gianlucarenzi/Vera-Module-RBL-C64/WORKFLOW.md

# Workflow di progetto: dallo schematico all'ordine JLCPCB

Versione stampabile: [WORKFLOW.pdf](WORKFLOW.pdf), generata da `WORKFLOW.tex`
(`firmware/MCU/produce-pdf-from-tex.sh WORKFLOW`). Le modifiche si fanno
prima qui, poi nel `.tex`.

Strumenti: KiCad 5 (Eeschema, CvPcb, Pcbnew) per schematico e PCB, libreria
`~/Progetti/RetroBitLab-Library` per simboli, footprint e modelli 3D, gli script
del repository per tutto ciò che si produce (PDF, Gerber, 3D, BOM, CPL).

In sintesi:

1. schematico e annotazione
2. disponibilità dei componenti → se serve, aggiornare la libreria e tornare al punto 1
3. ERC
4. assegnamento dei footprint
5. salvataggio della netlist
6. PCB: import della netlist e netclass
7. sbroglio
8. riempimento delle aree e DRC, senza errori né warning
9. salvataggio del PCB
10. `./output_job.sh <versione>`
11. consegna: zip dei Gerber, BOM e CPL

In questa fase **non** si esportano a mano PDF, BOM, Gerber o CPL da KiCad:
li genera tutti `output_job.sh` al punto 10, sempre dai sorgenti.

## 1. Schematico e annotazione

- Si disegna lo schematico in Eeschema (KiCad 5), foglio principale
  `VERA-MODULE-RBL.sch` e fogli gerarchici.
- Ogni componente da montare ha il campo **`LCSC`** con il codice del pezzo
  (es. `C17713`). La BOM raggruppa per valore, footprint e LCSC; un componente
  senza LCSC non viene montato da JLCPCB e viene tolto anche dalla CPL.
- Si annota tutto (Strumenti → Annota schematico). Nessun riferimento deve
  restare con `?`: `sch2bomxml.py` si ferma se ne trova uno, o se due parti
  diverse hanno lo stesso riferimento.

## 2. Disponibilità dei componenti

Subito dopo l'annotazione, prima di andare avanti:

```sh
./check_jlcpcb_stock.sh          # 5 schede
./check_jlcpcb_stock.sh -n 10    # 10 schede
```

Lo script costruisce la BOM dallo schematico in una cartella temporanea (non
scrive file del progetto) e la confronta con il catalogo JLCPCB in tempo reale.
Per ogni riga riporta stock, quantità necessaria (con scarto e minimo),
tipo Basic / Preferred / Extended e costo.

| Stato | Significato | Blocca |
|---|---|---|
| `OK` | stock sufficiente | no |
| `LOW` | sufficiente ora, ma meno di 5 volte il necessario | no (avviso) |
| `GLOBAL` | stock insufficiente, ma il codice è in `jlcpcb-global-sourcing.txt` | no |
| `SHORT` | stock minore del necessario | sì |
| `OUT` | stock zero | sì |
| `MISSING` | codice non presente nel catalogo JLCPCB | sì |

Per le righe che bloccano propone alternative con stock sufficiente (stessa
categoria e package, stesso valore per i passivi, Basic prima). Esce con 0 se
tutto si può montare, 1 se qualcosa va cambiato, 2 se il servizio non risponde.

Se un componente è attivo ma JLCPCB ne ha pochi, lo si può far comprare a
JLCPCB con il **Global Sourcing**: si aggiunge il codice LCSC a
`jlcpcb-global-sourcing.txt` (uno per riga, `#` per il commento) e all'ordine
si sceglie Global Sourcing per quella riga.

### Aggiornare la libreria, se necessario

Quando un componente va sostituito:

1. in `RetroBitLab-Library` si crea o si aggiorna il simbolo (`.lib`) con
   footprint, datasheet e campo `LCSC`, e la sua documentazione (`.dcm`);
   per i passivi si usa la libreria della famiglia giusta (`CCAP0805`,
   `CRES0805`, ...). Se cambia il package servono anche footprint e modello 3D;
2. si verifica sul datasheet piedinatura e land pattern rispetto al footprint;
3. si fa il commit della libreria;
4. nello schematico si sostituisce il simbolo e si torna al punto 2 finché
   il controllo non passa.

## 3. ERC

Ispeziona → Controllo regole elettriche. Si correggono tutti gli errori e i
warning prima di proseguire.

## 4. Assegnamento dei footprint

Con CvPcb ogni simbolo deve avere il suo footprint. Per le parti JLCPCB il
footprint deve corrispondere al package del codice LCSC.

## 5. Salvataggio della netlist

Si genera e si salva la netlist `VERA-MODULE-RBL.net` (Strumenti → Genera
netlist, formato Pcbnew). **Nessun PDF e nessuna BOM** in questa fase.

## 6. PCB: netlist e netclass

- In Pcbnew (KiCad 5) si importa la netlist (Strumenti → Carica netlist).
- Le **netclass si definiscono e si assegnano nel PCB** (File → Impostazioni
  scheda → Classi di rete): con KiCad 5 non esiste back annotation dal PCB
  allo schematico, quindi l'unico posto dove le netclass sono definite è il
  `.kicad_pcb`. Dopo ogni nuovo import della netlist si controlla che le net
  nuove o rinominate siano nella netclass giusta.

## 7. Sbroglio

A mano, oppure con fastroute tramite `tools/route.sh` (vedi il commento in
testa allo script). Il risultato si importa come sessione Specctra.
fastroute va installato nel sistema dal suo pacchetto Debian, da
[github.com/gianlucarenzi/fastroute](https://github.com/gianlucarenzi/fastroute)
(`scripts/build-deb.sh`, poi `sudo apt install ./dist/fastroute_*.deb`):
`tools/route.sh` si ferma se non lo trova.

`tools/route.sh` sbroglia **da zero** (cancella tutte le piste). Per completare
solo i collegamenti mancanti di una scheda già sbrogliata si usa
`tools/route_incremental.sh WORKDIR` (KiCad chiuso, DSN esportato dalla scheda
salvata con le aree riempite): le piste esistenti restano fisse e il risultato
è `VERA-MODULE-RBL.ses`. Due cose da sapere:

- KiCad 5 esporta i segmenti consecutivi come un'unica polilinea e mette le
  giunzioni a T sui vertici intermedi; fastroute collega le piste solo agli
  estremi e vedrebbe interrotte net già complete. `tools/split_dsn_wires.py`
  spezza le polilinee in segmenti.
- L'import della sessione in KiCad 5 **sostituisce tutte** le piste e le via:
  `tools/filter_ses.py` tiene lo sbroglio esistente una sola volta e con la
  larghezza originale, aggiunge il nuovo solo sulle net incomplete
  (`tools/unrouted_nets.py`) e rifiuta una sessione a cui manca qualcosa.

Per far ottimizzare a fastroute (lunghezza delle piste, numero di via) solo
lo sbroglio aggiunto dopo un commit, lasciando fisso quello già validato, si
usa `tools/optimize_new.sh COMMIT WORKDIR`. Prima dell'import della sessione
si tolgono le teardrop, dopo si rimettono. Il report di fastroute è più severo
del DRC di KiCad (controlla anche il rame della stessa net e vede via ed
estremità delle piste come ottagoni): il riferimento resta il DRC.

## 8. Riempimento delle aree e DRC

1. Al termine dello sbroglio si riempiono tutte le aree (tasto `B`).
2. Si lancia il DRC (Ispeziona → Controllo regole di progettazione).
3. Si correggono **tutti** gli errori e i warning, poi si ripetono i punti 1 e 2
   finché il DRC è pulito.

## 9. Salvataggio del PCB

Il `.kicad_pcb` si salva sempre corretto (DRC pulito) e **con le aree
riempite**: Gerber, 3D e CPL vengono generati dal file così come è salvato.
(`REFILL_ZONES=1 ./output_job.sh <versione>` riempie di nuovo le aree solo in
memoria, senza modificare il file: è un ripiego, non sostituisce il punto 8.)

## 10. Generazione dei file di produzione

```sh
./check_jlcpcb_stock.sh          # di nuovo, lo stock cambia nel tempo
./output_job.sh <versione>       # es. ./output_job.sh 4
```

`output_job.sh`, in ordine:

1. XML della BOM dallo schematico (`sch2bomxml.py`) → `VERA-MODULE-RBL.xml`;
2. BOM raggruppata (`generate_bom.py`) → `VERA-MODULE-RBL.csv`;
3. **BOM JLCPCB** (`jlcpcb-check-bom.py`) → `<NOME>-v<versione>-JLCPCB-BOM.csv`;
4. **CPL JLCPCB** dal PCB (`run_generate_cpl.sh`, `clean_virtual.sh`) →
   `<NOME>-v<versione>-JLCPCB-CPL.csv`, poi `jlcpcb-sync-cpl.py` toglie dalla
   CPL ciò che non è in BOM e si ferma se manca qualcosa;
5. **Gerber e forature** con pcbnew 5 e le impostazioni di stampa salvate nel
   PCB (`generate_gerbers.py`) → `production/` (svuotata prima);
6. **BOM interattiva** con il plugin InteractiveHtmlBom e le impostazioni di
   `ibom.config.ini` (`tools/generate_ibom.py`) → `ibom/ibom.html`;
7. **PDF dello schematico** con eeplot → `VERA-MODULE-RBL.pdf`;
8. **scheda in 3D**, STEP e VRML, con kicad-cli → `images/VERA-MODULE-RBL.step`
   e `images/VERA-MODULE-RBL.wrl`;
9. zip del contenuto di `production/` → `<NOME>-v<versione>.zip`.

Si ferma al primo errore. `<NOME>` è `VERA-MODULE-RBL-C64` per questo progetto.

## 11. Consegna

Il progetto da mandare in produzione è composto da **3 file**:

| File | Contenuto | Dove si carica su JLCPCB |
|---|---|---|
| `<NOME>-v<versione>.zip` | Gerber e forature | ordine PCB |
| `<NOME>-v<versione>-JLCPCB-BOM.csv` | BOM | PCB Assembly → BOM |
| `<NOME>-v<versione>-JLCPCB-CPL.csv` | posizioni e rotazioni | PCB Assembly → CPL |

All'ordine:

- nell'anteprima di montaggio si controlla la rotazione dei componenti,
  soprattutto quelli nuovi o con footprint cambiato;
- per le righe elencate come `GLOBAL` dal controllo stock si sceglie
  Global Sourcing.

Zip, BOM e CPL versionati non vanno nel repository; ci vanno invece i
sorgenti (schematici, netlist, PCB), `VERA-MODULE-RBL.xml/.csv`,
`production/`, il PDF, la BOM interattiva e i modelli 3D.
