gianlucarenzi/Vera-Module-RBL-C64/firmware/MCU/Vera_Module_Analisys.ITA.tex

\documentclass[12pt, a4paper]{article}

% --- PACHETTI ---
\usepackage[utf8]{inputenc}
\usepackage[T1]{fontenc}
\usepackage{lmodern} % Font più moderno rispetto al default
\usepackage[italian]{babel}
\usepackage{geometry}
\usepackage{graphicx}
\usepackage{amsmath}
\usepackage{amssymb}
\usepackage{xcolor}
\usepackage{hyperref}
\usepackage{listings}
\usepackage{tikz}
\usepackage{tikz-timing}
\usepackage{verbatim} % Aggiunto per commentare blocchi
\usepackage{fancyvrb} % BVerbatim per ASCII art centrata
\usepackage{float}
\usepackage{booktabs}
\usepackage{array}

% --- CONFIGURAZIONE GEOMETRIA PAGINA ---
\geometry{a4paper, top=3cm, bottom=3cm, left=2.5cm, right=2.5cm}

% --- CONFIGURAZIONE HYPERREF ---
\hypersetup{
    colorlinks=true,
    linkcolor=blue!50!black,
    urlcolor=blue!80!black,
    citecolor=green!50!black,
    pdftitle={Analisi Progetto Vera-Module-RBL-C64},
    pdfauthor={RetroBit Lab},
}

% --- CONFIGURAZIONE TIKZ ---
\usetikzlibrary{shapes.geometric, arrows, positioning, chains, shapes.misc}

% --- CONFIGURAZIONE LISTINGS (per il codice) ---
\definecolor{codegreen}{rgb}{0,0.6,0}
\definecolor{codegray}{rgb}{0.5,0.5,0.5}
\definecolor{codepurple}{rgb}{0.58,0,0.82}
\definecolor{backcolour}{rgb}{0.98,0.98,0.98}

\lstdefinestyle{cppstyle}{
    backgroundcolor=\color{backcolour},
    commentstyle=\color{codegreen},
    keywordstyle=\color{magenta},
    numberstyle=\tiny\color{codegray},
    stringstyle=\color{codepurple},
    basicstyle=\footnotesize\ttfamily,
    breakatwhitespace=false,
    breaklines=true,
    captionpos=b,
    keepspaces=true,
    numbers=left,
    numbersep=5pt,
    showspaces=false,
    showstringspaces=false,
    showtabs=false,
    tabsize=2,
    language=C++
}

% --- TITOLO ---
\title{
    \vspace{2cm}
    \hrule
    \vspace{0.5cm}
    {\Huge \bfseries Analisi Tecnica del Firmware}\\
    \vspace{0.2cm}
    {\Large Progetto \textit{Vera-Module-RBL-C64}}\\
    \vspace{0.5cm}
    \hrule
}
\author{Analisi del progetto a cura di RetroBit Lab}
\date{\today}

% --- INIZIO DOCUMENTO ---
\begin{document}

\maketitle
\thispagestyle{empty}

\newpage
\tableofcontents
\thispagestyle{empty}

\newpage
\setcounter{page}{1}

% --- SEZIONE 1: INTRODUZIONE ---
\section{Introduzione}
Questo documento presenta un'analisi tecnica del firmware ESP32 per il progetto \textit{Vera-Module-RBL-C64}. Il firmware, eseguito su un ESP32-S3, si interfaccia con il bus del processore 6510 attraverso la \textbf{porta di espansione del Commodore 64}. Espone i registri della scheda video VERA (FPGA) e una \textbf{GeoRAM da 256\,KB} emulata nella RAM interna dell'ESP32.

Il progetto deriva dalla versione Atari (\textit{Vera-Module-RBL-XE}). Lo schema è quello di RBL-XE nella revisione del 2026-10-26, con il foglio del connettore adattato alla porta di espansione del C64; la piedinatura dell'ESP32-S3 è la stessa di RBL-XE, tranne GPIO\,41/42 che diventano gli ingressi \texttt{/IO1}/\texttt{/IO2} (\texttt{PIN-MAPPING.md}~\S9). Il PCB è ancora quello Atari. Anche il firmware riprende l'architettura di RBL-XE (loop del bus sul Core\,1 a interruzioni mascherate, percorso critico in assembly, tabelle di decodifica, log senza lock), adattata al bus del C64. L'analisi si concentra sulla fattibilità temporale dell'interazione fra la MCU e la CPU e sulla struttura del loop del bus. \textbf{Nulla è stato provato su hardware.}

% --- SEZIONE 2: ARCHITETTURA DEL SISTEMA ---
\section{Architettura del Sistema}

\subsection{Componenti Chiave}
\begin{itemize}
    \item {\bfseries CPU 6510 (MOS):} il processore del C64, a \textbf{0.985\,MHz} (PAL) o \textbf{1.023\,MHz} (NTSC). PHI2 alto dura $\approx$490\,ns.
    \item {\bfseries MCU:} \textbf{ESP32-S3FN8} (QFN56, 7$\times$7\,mm) --- dual-core Xtensa LX7 @ 240\,MHz, 512\,KB SRAM, 8\,MB flash in-package Quad SPI, 45 GPIO.
    \item {\bfseries FPGA VERA:} iCE40UP5K con il firmware VERA; risponde ai registri \$DF00--\$DF1F quando l'ESP32 asserisce \texttt{DEV\_SEL\_N}.
\end{itemize}

\subsection{Mappa I/O}
La scheda occupa le due aree I/O della porta di espansione, \texttt{IO1} (\$DE00--\$DEFF) e \texttt{IO2} (\$DF00--\$DFFF). Sul C64 queste aree non hanno memoria interna: non serve disabilitare nulla sulla scheda madre, basta pilotare il bus dati.

\begin{center}
\begin{tabular}{lllp{4.5cm}}
\toprule
\textbf{Indirizzo} & \textbf{Accesso} & \textbf{Funzione} & \textbf{Chi risponde} \\
\midrule
\$DE00--\$DEFF & R/W & Finestra GeoRAM (pagina da 256\,B) & ESP32, \texttt{georam\_256k[]} \\
\$DF00--\$DF1F & R/W & Registri VERA & FPGA, \texttt{DEV\_SEL\_N} asserito \\
\$DFFD & W & Latch selezione VERA & ESP32 (snoop) \\
\$DFFE & W & GeoRAM, registro pagina (0--63) & ESP32 (snoop) \\
\$DFFF & W & GeoRAM, registro blocco (0--15) & ESP32 (snoop) \\
\bottomrule
\end{tabular}
\end{center}

La VERA risponde \textbf{solo se selezionata}: un valore $\neq 0$ scritto in \$DFFD la seleziona, \texttt{0} la deseleziona. La GeoRAM (finestra e registri \$DFFE/\$DFFF) è \textbf{sempre attiva}, come nella cartuccia originale. Il latch risponde sempre.

La GeoRAM è organizzata in 16 blocchi da 16\,KB, ognuno di 64 pagine da 256\,byte:
\[
\text{offset} = \text{blocco} \times 16384 + \text{pagina} \times 256 + (\text{addr} \;\&\; \text{\$FF})
\]
I registri sono a sola scrittura, si azzerano all'accensione e sopravvivono al reset del C64, come nell'hardware originale. Sono decodificati esattamente a \$DFFE/\$DFFF, senza i mirror \$DF80--\$DFFD di alcune GeoRAM: per questo il latch a \$DFFD non va in conflitto.

\subsection{Ambiente di build PlatformIO}
Il file \texttt{platformio.ini} definisce un solo ambiente, \texttt{esp32s3fn8}. Opzioni di compilazione (\texttt{-D}):

\begin{center}
\begin{tabular}{lcp{8cm}}
\toprule
\textbf{Macro} & \textbf{Default} & \textbf{Effetto} \\
\midrule
\texttt{CARD\_SEL\_LATCH}           & \texttt{0xFD} & offset in \texttt{IO2} del latch di selezione (\$DFFD) \\
\texttt{IO\_QUALIFY\_NS}            & 200  & attesa massima di \texttt{/IO1}/\texttt{/IO2} dopo il fronte di salita di PHI2 \\
\texttt{BUS\_WR\_SAMPLE\_NS}        & 300  & ritardo dalla salita di PHI2 al campionamento del dato in scrittura \\
\texttt{VERA\_TRACE\_REGS}          & 0    & log di ogni accesso ai registri VERA (solo debug) \\
\texttt{VERA\_POST\_CDONE\_DELAY\_US} & 1000 & attesa fra \texttt{CDONE} e il rilascio del reset del C64 \\
\bottomrule
\end{tabular}
\end{center}

\subsection{Interfacciamento Bus}
Ogni ciclo è qualificato dalle linee \texttt{/IO1} e \texttt{/IO2} della porta di espansione. Nel C64 le genera il 74LS139 a valle del PLA, che le abilita solo con \texttt{AEC} alto, cioè solo per gli accessi della CPU: i fetch del VIC-II, i cui indirizzi compaiono anch'essi sulla porta, non le asseriscono e vengono ignorati. \texttt{/IO1} e \texttt{/IO2} decodificano già A8--A15, quindi al firmware servono solo A0--A7 come offset nella pagina.

\begin{sloppypar}
L'adattamento di livello 5\,V\,$\leftrightarrow$\,3.3\,V è affidato a cinque \textbf{74LVC4245} (lato A a 5\,V verso il C64, lato B a 3.3\,V), a un invertitore \textbf{SN74HCT04} (\texttt{U23}) per la direzione del bus dati e a due \textbf{SN74LVC00A} (\texttt{U24}, \texttt{U25}) per l'abilitazione di \texttt{U19}; dettaglio in \texttt{PIN-MAPPING.md}~\S6:
\end{sloppypar}

\begin{itemize}
    \item {\bfseries U19 --- Bus dati D0--D7 (GPIO\,4--11):} bidirezionale, \texttt{DIR} = NOT R/W\_ da \texttt{U23}. \texttt{\textasciitilde OE\_} = \texttt{NAND(PHI2, NAND(R/W, DEV\_SEL\_N, /IO1))}: acceso in scrittura, nelle letture VERA e nelle letture GeoRAM, spento in tutte le altre letture. L'ESP32 abilita le proprie uscite con \texttt{GPIO.enable\_w1ts} solo nelle letture della finestra GeoRAM.
    \item {\bfseries U4 --- A0--A7 (GPIO\,12--19)} e {\bfseries U3 --- A8--A15:} ingressi C64$\rightarrow$ESP32, con \texttt{\textasciitilde OE\_} sulla rete \texttt{\textasciitilde ABUS\_OE} (GPIO\,47, sezione~\ref{sec:strapping}). A8--A15 sono cablati ma non usati dalla decodifica. GPIO\,19/20 condividono i pad USB; USB CDC è disabilitato.
    \item {\bfseries U6 --- PHI2, R/W\_, /IO1, /IO2 (GPIO\,1, 2, 41, 42):} ingressi C64$\rightarrow$scheda; altri tre canali portano \texttt{BA}, \texttt{/DMA} e \texttt{/RESET} a punti di test. GPIO\,41 e 42 erano \texttt{EXTSEL\_N} e \texttt{MPD} su RBL-XE.
    \item {\bfseries U26, U27 --- IRQ della VERA e ARESET (GPIO\,37):} uscite scheda$\rightarrow$C64 verso le linee condivise \texttt{/IRQ} e \texttt{/RESET}, attraverso due buffer open-drain SN74LVC1G07; \texttt{U16} non pilota più nessuna linea del C64. Una pull-down da 10\,k$\Omega$ (\texttt{R70}) tiene il C64 in reset mentre l'ESP32 si avvia.
    \item {\bfseries Connessioni dirette (3.3\,V):} \texttt{DEV\_SEL\_N} (GPIO\,40) $\rightarrow$ /CS della VERA e gating di \texttt{U19}; \texttt{CRESET} (GPIO\,38) $\rightarrow$ reset VERA; \texttt{CDONE} (GPIO\,39) $\leftarrow$ VERA; \texttt{ABUS\_OE\_N} (GPIO\,47) $\rightarrow$ \texttt{U3}/\texttt{U4}.
\end{itemize}

PHI2, R/W\_, \texttt{/IO1} e \texttt{/IO2} sono letti con il \textbf{Dedicated GPIO input bundle} (\texttt{ee.get\_gpio\_in}, 1\,ciclo CPU, canali 0--3); \texttt{DEV\_SEL\_N} è l'unico canale del bundle di uscita (\texttt{ee.wr\_mask\_gpio\_out}). I bundle sono creati dal task del bus sul Core\,1, che è il core che li usa.

\subsection{Ripartizione dei core}
\label{sec:core}

\begin{center}
\begin{tabular}{clp{5.5cm}}
\toprule
\textbf{Core} & \textbf{Cosa gira} & \textbf{Note} \\
\midrule
0 & \texttt{LogTask}, \texttt{Serial} & svuota \texttt{log\_ring} e stampa; qui gira anche l'interrupt della UART e il tick FreeRTOS \\
1 & solo \texttt{MonitorTask} (loop del bus) & priorità \texttt{configMAX\_PRIORITIES - 1}, non cede mai la CPU, \textbf{interruzioni mascherate}; watchdog delle interruzioni (MWDT1) disattivato \\
\bottomrule
\end{tabular}
\end{center}

Nella versione precedente il loop girava sul Core\,0 con il tick FreeRTOS attivo: l'interruzione a 1\,kHz può far perdere cicli di bus. Ora il Core\,1 non esegue nient'altro e non riceve interruzioni; il contatore dei tick resta aggiornato dal Core\,0. Il loop passa gli eventi (cambio del latch; accessi ai registri VERA con \texttt{VERA\_TRACE\_REGS=1}) a \texttt{LogTask} tramite \texttt{log\_ring}, un ring buffer \emph{single-producer/single-consumer} senza lock: l'inserimento costa poche istruzioni e non chiama FreeRTOS, il timestamp è aggiunto da \texttt{LogTask}. Il cambio di latch viene registrato nella coda di PHI2 e inserito nel ring nel PHI1 successivo.

% --- SEZIONE 3: MAPPING DEI PIN ---
\section{Mapping dei Pin (ESP32-S3FN8, QFN56)}

I pin fisici del package QFN56 sono numerati 1--56 (più il pad GND centrale). La tabella riporta i segnali con il numero GPIO logico \textbf{e} il numero di pad fisico (Table~2-1 del datasheet ESP32-S3 v2.2).

\textbf{Nota importante:} il MCU \emph{richiede} un \textbf{quarzo esterno a 40\,MHz} sui pin dedicati \textbf{XTAL\_P} (pin\,54) e \textbf{XTAL\_N} (pin\,53); senza quarzo il chip non si avvia (sezione~\ref{sec:xtal}).

\begin{center}
\resizebox{\linewidth}{!}{%
\begin{tabular}{lcclll}
\toprule
\textbf{Segnale} & \textbf{GPIO} & \textbf{Pin QFN56} & \textbf{IO MUX} & \textbf{Dir.} & \textbf{Note} \\
\midrule
\multicolumn{6}{l}{\textit{Bus dati D0--D7 --- bidirezionale via 74LVC4245 U19 (Bank-0 bit 4--11)}} \\
D0--D7 & 4--11 & 9--16 & GPIO4--11 & I/O & D0 ha un glitch LOW di 60\,µs al power-up \\
\midrule
\multicolumn{6}{l}{\textit{Bus indirizzi A0--A7 --- input via 74LVC4245 U4 (Bank-0 bit 12--19)}} \\
A0--A2 & 12--14 & 17--19 & GPIO12--14 & IN & \\
A3 & 15 & 21 & XTAL\_32K\_P & IN & pad RTC usato come GPIO; pin\,20 = VDD3P3\_RTC \\
A4 & 16 & 22 & XTAL\_32K\_N & IN & pad RTC usato come GPIO \\
A5, A6 & 17, 18 & 23, 24 & GPIO17, 18 & IN & \\
A7 & 19 & 25 & USB\_D$-$ & IN & USB CDC disabilitato \\
\midrule
\multicolumn{6}{l}{\textit{Bus indirizzi A8--A15 --- input via U3, cablati ma non usati dalla decodifica}} \\
A8, A9 & 20, 21 & 26, 27 & USB\_D$+$, GPIO21 & IN & \\
A10, A11 & 33, 34 & 38, 39 & GPIO33, 34 & IN & \\
A12, A13 & 35, 36 & 40, 41 & GPIO35, 36 & IN & \\
A14, A15 & 45, 46 & 51, 52 & GPIO45, 46 & IN & pin di strapping (sezione~\ref{sec:strapping}) \\
\midrule
\multicolumn{6}{l}{\textit{Controllo --- U6 (ingressi) e U27 (uscita open-drain)}} \\
PHI2  &  1 &  6 & GPIO1  & IN  & Dedicated GPIO input ch\,0; 0.985/1.023\,MHz \\
R/W\_ &  2 &  7 & GPIO2  & IN  & Dedicated GPIO input ch\,1; HIGH = lettura \\
/IO1  & 41 & 47 & MTDI   & IN  & Dedicated GPIO input ch\,2; ex \texttt{EXTSEL\_N}, ex-JTAG \\
/IO2  & 42 & 48 & MTMS   & IN  & Dedicated GPIO input ch\,3; ex \texttt{MPD}, ex-JTAG \\
ARESET & 37 & 42 & GPIO37 & OUT & \texttt{/RESET} del C64 via open-drain \texttt{U27} (LOW asserito) \\
\midrule
\multicolumn{6}{l}{\textit{Segnali diretti (senza level shifter, 3.3\,V)}} \\
DEV\_SEL\_N & 40 & 45 & MTDO   & OUT & /CS VERA; Dedicated GPIO output ch\,0; ex-JTAG \\
CRESET      & 38 & 43 & GPIO38 & OUT & /RESET VERA \\
CDONE       & 39 & 44 & MTCK   & IN  & VERA configurata (HIGH = OK); ex-JTAG \\
ABUS\_OE\_N & 47 & 37 & SPICLK\_P & OUT & \texttt{\textasciitilde OE} di U3/U4; pull-up \texttt{R7}/\texttt{R34} \\
--- & 3 & 8 & GPIO3 & --- & non usato; pull-up \texttt{R71} 10\,k$\Omega$ (strapping) \\
BOOT0 & 0 & 5 & GPIO0 & IN & pulsante BOOT / auto-reset; non usato dal firmware \\
\midrule
\multicolumn{6}{l}{\textit{Debug}} \\
UART TX & 43 & 49 & U0TXD & OUT & Serial debug @ 115200 baud \\
UART RX & 44 & 50 & U0RXD & IN  & non utilizzato dal firmware \\
\bottomrule
\end{tabular}%
}
\end{center}

\noindent\textbf{Attenzione:} i pin QFN56 30--35 (GPIO\,27--32) sono collegati alla flash Quad SPI in-package (variante FN8) e non devono mai essere connessi esternamente; il pin\,28 (GPIO\,26, \texttt{SPICS1}) è il chip select della PSRAM in-package, assente sulla FN8, e resta sconsigliato (datasheet Table~2-14). Resta libero solo GPIO\,48 (pin\,36). I pin\,53 e\,54 sono pad analogici dedicati al quarzo da 40\,MHz.

\subsection{Pin di strapping --- comportamento al boot con il C64 collegato}
\label{sec:strapping}

L'ESP32-S3 campiona quattro pin di strapping a ogni reset del chip (accensione, CHIP\_PU, programmatore, brown-out), \emph{prima che qualsiasi codice venga eseguito}; i livelli devono essere validi alla salita di CHIP\_PU e per 3\,ms dopo. Le linee indirizzo della porta di espansione sono sempre pilotate: dal 6510, che continua a pilotarle anche in reset, oppure in PHI1 dal VIC-II e dai pull-up della scheda madre. Il loro livello non può quindi decidere gli strapping di GPIO\,45/46.

\begin{itemize}
  \item \textbf{GPIO\,0 (pin\,5) --- boot mode.} Rete \texttt{BOOT0} (\texttt{R33} 4.7\,k$\Omega$ verso 3V3, pulsante \texttt{SW3}, \texttt{C61}, \texttt{R54} verso \texttt{Q4}); non collegato al C64. CHIP\_PU ha \texttt{R31} 4.7\,k$\Omega$ + \texttt{C25} 1\,µF (4.7\,ms) contro 0.47\,ms di BOOT0: GPIO\,0 è già alto al rilascio del reset. Campionato HIGH $\rightarrow$ boot SPI dalla flash integrata.
  \item \textbf{GPIO\,3 (pin\,8) --- sorgente JTAG, nessun pull interno.} Non usato dal firmware; pull-up \texttt{R71} 10\,k$\Omega$ verso 3V3, obbligatoria perché il datasheet vieta l'alta impedenza. Con gli eFuse di default il livello è comunque ignorato.
  \item \textbf{GPIO\,45 (pin\,51) --- VDD\_SPI} e \textbf{GPIO\,46 (pin\,52) --- messaggi ROM / download}, pull-down interni da 45\,k$\Omega$, collegati ad A14/A15 tramite \texttt{U3}. \texttt{\textasciitilde OE} di \texttt{U3} e \texttt{U4} è la rete \texttt{\textasciitilde ABUS\_OE}, pilotata da GPIO\,47 e tenuta alta da \texttt{R7}/\texttt{R34} (10\,k$\Omega$ verso 3V3) mentre l'ESP32 è in reset: i traslatori sono spenti, i pull-down danno GPIO\,45 = GPIO\,46 = LOW, quindi VDD\_SPI = 3.3\,V (quella della flash della FN8) e download boot valido anche con il C64 acceso. \texttt{setup()} porta GPIO\,47 basso molto dopo i 3\,ms di hold. Gli eFuse \texttt{VDD\_SPI\_FORCE}/\texttt{TIEH} non servono.
\end{itemize}

\subsection{Quarzo oscillatore 40\,MHz (pin\,53--54)}
\label{sec:xtal}

L'ESP32-S3FN8 richiede un quarzo esterno da \textbf{40\,MHz} per il riferimento del PLL che alimenta la CPU a 240\,MHz, l'interfaccia flash e i divisori UART. I pin sono analogici dedicati, non condivisi con GPIO.

\begin{center}
\begin{BVerbatim}
XTAL_P (54) --[C1 10pF]-- GND
     |
  [X1 40MHz]    <- Rs 0-33 Ohm in serie (opzionale)
     |
XTAL_N (53) --[C2 10pF]-- GND
\end{BVerbatim}
\end{center}

\begin{center}
\resizebox{\linewidth}{!}{%
\begin{tabular}{lll}
\toprule
\textbf{Componente} & \textbf{Valore} & \textbf{Note} \\
\midrule
X1 -- quarzo & 40\,MHz, SMD 3225 o 2016 & $\pm$10\,ppm; verificare $C_L$ dal datasheet \\
C1, C2 -- condensatori di carico & 10\,pF, 0402, $\pm$5\,\% & $C_{ext}=2C_L - C_{stray}$;\; $C_{stray}\approx 3$--5\,pF \\
Rs -- resistenza serie & 0--33\,$\Omega$ (opzionale) & Limita il drive dell'oscillatore \\
\bottomrule
\end{tabular}%
}
\end{center}

\noindent\textbf{Regole di layout PCB:} tracce XTAL\_P/N più corte possibile ($<$5\,mm); condensatori di carico ai pad del chip; piano di massa solido sotto il quarzo; isolamento dalle tracce PHI2 e D0--D7.

% --- SEZIONE 4: ANALISI DELLE TEMPISTICHE ---
\section{Analisi delle Tempistiche}

\begin{itemize}
    \item {\bfseries Ciclo 6510:} $T_{6510} \approx 1015\,\text{ns}$ (PAL, 0.985\,MHz) o $\approx 978\,\text{ns}$ (NTSC, 1.023\,MHz).
    \item {\bfseries Finestra PHI2 alto:} $T_{PHI2\uparrow} \approx 490\,\text{ns}$. Nella fase PHI1 il bus appartiene al VIC-II: sul C64, a differenza dell'Atari, l'indirizzo della CPU non è disponibile in anticipo e la decodifica può partire solo dopo la salita di PHI2.
    \item {\bfseries Vincoli del 6510 a 1\,MHz:} dato in lettura richiesto $t_{DSU} = 100$\,ns prima della discesa di PHI2; dato in scrittura valido al più $t_{MDS} = 200$\,ns dopo la salita e tenuto $t_{HW} = 10$\,ns dopo la discesa.
    \item {\bfseries Ciclo ESP32 (240\,MHz):} $T_{ESP32} \approx 4.17\,\text{ns}$, quindi
    \[
    \frac{T_{PHI2\uparrow}}{T_{ESP32}} = \frac{490\,\text{ns}}{4.17\,\text{ns}} \approx 117\,\text{cicli ESP32}.
    \]
\end{itemize}

\subsection{Sequenza di un ciclo}
\begin{enumerate}
    \item \textbf{Fronte di salita di PHI2}, letto con \texttt{ee.get\_gpio\_in} (3 cicli per campione); l'istante è annotato con \texttt{CCOUNT}.
    \item \textbf{Qualificazione}: attesa limitata (\texttt{IO\_QUALIFY\_NS}, default 200\,ns dalla salita) di \texttt{/IO1} o \texttt{/IO2} basso, con un solo salto \texttt{bnall} sui canali 2--3. Se nessuna delle due si attiva, il ciclo non è della scheda (altro indirizzo o fetch VIC-II) e viene saltato.
    \item \textbf{Una lettura di \texttt{GPIO.in}} (A0--A7): a questo punto \texttt{AEC} è alto e l'indirizzo è quello del 6510; R/W\_ è già nel canale Dedicated GPIO\,1.
    \item \textbf{\texttt{/IO2}}: \texttt{c = bus\_io2[latch][A0-A7]}, poi \texttt{ee.wr\_mask\_gpio\_out}: per \$DF00--\$DF1F con la VERA selezionata \texttt{DEV\_SEL\_N} va basso (risponde la FPGA).
    \item \textbf{\texttt{/IO1}, finestra GeoRAM in lettura}: l'ESP32 pilota subito D0--D7 con \texttt{win[off8]} (\texttt{GPIO.out = byte << 4} e \texttt{GPIO.enable\_w1ts}, due store senza \texttt{memw}); \texttt{win} è il puntatore alla pagina corrente, tenuto in un registro.
    \item \textbf{Scritture}: il dato è campionato \texttt{BUS\_WR\_SAMPLE\_NS} (300\,ns) dopo la salita di PHI2, fra $t_{MDS}$ e la discesa; gli effetti (byte GeoRAM, latch, registri pagina/blocco e ricalcolo di \texttt{win}) sono applicati subito, nel resto di PHI2.
    \item \textbf{Fronte di discesa di PHI2}: bus rilasciato, \texttt{DEV\_SEL\_N} de-asserito, eventuale evento di latch inserito nel ring.
\end{enumerate}

\subsection{Percorso critico}
I passi 2--5 sono scritti in assembly inline, con tutti gli operandi in registro e le costanti caricate prima dell'attesa. Conteggio dal disassemblato della ELF (\texttt{xtensa-esp32s3-elf-objdump}), a partire dal campione di \texttt{/IOx} basso:

\begin{center}
\begin{tabular}{lcc}
\toprule
\textbf{Fino a} & \textbf{Versione precedente} & \textbf{Versione corrente} \\
\midrule
\texttt{DEV\_SEL\_N} asserito (registri VERA) & $\approx$9 istruzioni + 1 lettura APB & 5 istruzioni + 1 lettura APB \\
dato GeoRAM pilotato su D0--D7 & $\approx$18 istruzioni & $\approx$10 istruzioni + 1 lettura e 2 scritture APB \\
campionamento di \texttt{/IOx} & chiamate C, $\approx$10 istruzioni & 5 istruzioni \\
\bottomrule
\end{tabular}
\end{center}

La versione precedente teneva la GeoRAM in \texttt{.iram0.bss}: una sezione fuori dal layout IRAM di ESP-IDF, che non viene riservata sul bus dati e si sovrappone a \texttt{.data}, \texttt{.bss} e heap; inoltre la IRAM non è accessibile a byte. Ora la GeoRAM è \texttt{.bss} ordinaria in DRAM, come la RAMbo di RBL-XE, e il pilotaggio del bus non usa più la tabella \texttt{lut\_drive[]}. Con $\approx$117 cicli disponibili il margine è ampio anche considerando l'attesa di \texttt{/IOx}; i tempi reali (latenza delle letture APB, sincronizzatori GPIO, ritardo di \texttt{/IOx}) vanno confermati con un analizzatore logico.

La previsione del fronte di discesa usata su RBL-XE non serve: gli effetti delle scritture durano poche decine di cicli e dopo la discesa di PHI2 resta tutto PHI1 ($\approx$490\,ns) prima del ciclo successivo.

\subsection{Accesso diretto ai registri GPIO}
\begin{itemize}
    \item \texttt{GPIO.in} --- i 32 GPIO del bank-0 in una lettura: D0--D7, A0--A7 (PHI2, R/W\_, \texttt{/IO1}, \texttt{/IO2} arrivano dai canali Dedicated GPIO).
    \item \texttt{GPIO.out} + \texttt{GPIO.enable\_w1ts} --- pilotaggio del bus dati (\texttt{byte << 4}); \texttt{GPIO.enable\_w1tc} lo rilascia.
    \item \texttt{GPIO.out1\_w1ts} --- rilascio di \texttt{ARESET} all'avvio del loop.
\end{itemize}

\subsection{Diagramma temporale di una lettura GeoRAM}

\begin{figure}[h!]
\centering
\begin{tikztimingtable}[timing/slope=0.1, timing/coldist=2pt, xscale=1.2, yscale=1.5]
    PHI2      & L H L H L H L H L H L H \\
    /IO1      & H H H 8L H \\
    Address   & U 2D{Addr} 8D{Addr} 2U \\
    R/W Line  & U H H H H H H H H H 2U \\
    Data Bus  & Z Z Z Z Z Z 4D{Data} 2Z \\
    \extracode
    \begin{pgfonlayer}{background}
        \vertlines[help lines, step=1]{0,1,...,12}
        \node[below, font=\tiny, text=blue] at (3,-0.5) {/IO1 basso (AEC alto)};
        \node[below, font=\tiny, text=blue] at (8,-0.5) {ESP32 fornisce \texttt{win[off8]}};
        \node[below, font=\tiny, text=blue] at (11,-0.5) {CPU legge dati};
    \end{pgfonlayer}
\end{tikztimingtable}
\caption{Ciclo di lettura della finestra GeoRAM gestito dall'ESP32.}
\label{fig:timing_diagram}
\end{figure}

% --- SEZIONE 5: CODICE SORGENTE ---
\section{Frammento di Codice Sorgente}
Estratti di \texttt{bus\_decode.h} e \texttt{main.cpp} (setup dei bundle e sequenza di reset omessi).

\begin{lstlisting}[style=cppstyle, caption={Canali Dedicated GPIO e tabella di IO2 (bus\_decode.h)}, label=code:mcu_select]
#define DEDIC_IN_PHI2        (1u << 0)   /* GPIO 1              */
#define DEDIC_IN_RW          (1u << 1)   /* GPIO 2              */
#define DEDIC_IN_IO1N        (1u << 2)   /* GPIO 41, active LOW */
#define DEDIC_IN_IO2N        (1u << 3)   /* GPIO 42, active LOW */
#define DEDIC_OUT_DEVSELN    (1u << 0)   /* GPIO 40, active LOW */

BUS_INLINE uint32_t bus_io2_ctrl(uint32_t off8, bool selected)
{
    uint32_t c = DEDIC_OUT_CTRL_IDLE | CT_IO2;
    if (selected && off8 < VERA_REG_COUNT)
        c &= ~DEDIC_OUT_DEVSELN;
    if (off8 == CARD_SEL_LATCH || off8 == GEORAM_PAGE_REG || off8 == GEORAM_BLOCK_REG)
        c |= CT_WR_REG;
    return c;
}
\end{lstlisting}

\begin{lstlisting}[style=cppstyle, caption={Percorso critico del MonitorTask (Core\,1), assembly inline}, label=code:monitor_task]
wait_phi2_high();
const uint32_t t_rise  = cpu_ll_get_cycle_count();
const uint32_t t_limit = t_rise + qualify;
asm volatile(
    "   movi   %[c], 0x0C                \n"   /* /IO1, /IO2 in din */
    "   movi   %[t2], 1                  \n"   /* DEDIC_OUT_CTRL_MASK */
    "1: ee.get_gpio_in %[din]            \n"
    "   bnall  %[din], %[c], 2f          \n"   /* /IO1 or /IO2 LOW */
    "   rsr.ccount %[t1]                 \n"
    "   sub    %[t1], %[t1], %[tl]       \n"
    "   bltz   %[t1], 1b                 \n"
    "   movi   %[c], 0                   \n"   /* not ours */
    "   j      6f                        \n"
    "2: l32i   %[lo], %[gpio], %[o_in]   \n"   /* GPIO.in */
    "   extui  %[off], %[lo], 12, 8      \n"   /* A0-A7 */
    "   bbci   %[din], 2, 4f             \n"   /* /IO1 LOW: GeoRAM */
    "   add    %[t1], %[io2], %[off]     \n"
    "   l8ui   %[c], %[t1], 0            \n"   /* io2_cur[A0-A7] */
    "   ee.wr_mask_gpio_out %[c], %[t2]  \n"
    "   j      6f                        \n"
    "4: movi   %[c], %[ct_io1]           \n"
    "   bbci   %[din], 1, 6f             \n"   /* write cycle */
    "   add    %[t1], %[win], %[off]     \n"
    "   l8ui   %[t1], %[t1], 0           \n"   /* win[A0-A7] */
    "   movi   %[t2], %[m_dbus]          \n"
    "   slli   %[t1], %[t1], %[sh]       \n"
    "   s32i   %[t1], %[gpio], %[o_out]  \n"   /* GPIO.out */
    "   s32i   %[t2], %[gpio], %[o_en]   \n"   /* GPIO.enable_w1ts */
    "6:                                  \n"
    /* operandi omessi */);
\end{lstlisting}

% --- SEZIONE 6: DIAGRAMMA DI FLUSSO ---
\section{Diagramma di Flusso del Firmware}
Il \texttt{MonitorTask} gira da solo sul Core\,1 a interruzioni mascherate; il Core\,0 stampa gli eventi del \texttt{log\_ring} (sezione~\ref{sec:core}).

\begin{figure}[H]
\centering
\begin{tikzpicture}[
    scale=0.50, transform shape,
    node distance=1.2cm and 1.0cm,
    base/.style={draw, text width=5cm, align=center, minimum height=0.9cm},
    proc/.style={base, rectangle, fill=blue!10},
    test/.style={base, diamond, aspect=2, text width=4cm, fill=orange!15},
    term/.style={base, rounded rectangle, fill=green!20},
    arrow/.style={-latex, thick}
]
    \node[term] (start) {Inizio \texttt{MonitorTask} (Core 1)};
    \node[proc, below=of start]      (wait_phi2) {Spin-wait salita PHI2};
    \node[proc, below=of wait_phi2]  (qualify)   {Attesa limitata di /IO1 o /IO2\\(\texttt{IO\_QUALIFY\_NS})};
    \node[test, below=of qualify]    (ours)      {/IO1 o /IO2\\basso?};
    \node[proc, right=1.5cm of ours] (skip)      {Ciclo non della scheda};
    \node[proc, below=of ours]       (read_in)   {Lettura \texttt{GPIO.in}: A0--A7};
    \node[test, below=of read_in]    (is_io1)    {/IO1?};

    \node[proc, below=of is_io1, xshift=-4cm] (geo)  {GeoRAM: in lettura pilota subito \texttt{win[off8]}};
    \node[proc, below=of is_io1, xshift=+4cm] (io2)  {IO2: \texttt{DEV\_SEL\_N} da \texttt{bus\_io2[latch][off8]}};

    \node[proc, below=3.2cm of is_io1] (write) {Scrittura: campione a \texttt{BUS\_WR\_SAMPLE\_NS};\\GeoRAM, latch \$DFFD, pagina/blocco $\rightarrow$ \texttt{win}};
    \node[proc, below=of write] (fall) {Discesa PHI2: rilascio bus, \texttt{DEV\_SEL\_N} alto,\\evento di latch nel ring};

    \draw[arrow] (start)     -- (wait_phi2);
    \draw[arrow] (wait_phi2) -- (qualify);
    \draw[arrow] (qualify)   -- (ours);
    \draw[arrow] (ours)      -- node[above]{No} (skip);
    \draw[arrow] (ours)      -- node[right, pos=0.4]{Sì} (read_in);
    \draw[arrow] (read_in)   -- (is_io1);
    \draw[arrow] (is_io1)    -| node[above, pos=0.25]{Sì} (geo);
    \draw[arrow] (is_io1)    -| node[above, pos=0.25]{No} (io2);
    \draw[arrow] (geo)       |- (write);
    \draw[arrow] (io2)       |- (write);
    \draw[arrow] (write)     -- (fall);
    \draw[arrow] (skip.east) -- ++(1.2,0) |- (fall.east);

    \coordinate (back) at ([xshift=-6cm]fall.west);
    \draw[arrow] (fall.west) -- (back) |- (wait_phi2.west);
\end{tikzpicture}
\caption{Diagramma di flusso semplificato del \texttt{MonitorTask} (ESP32-S3FN8, C64).}
\label{fig:flowchart}
\end{figure}

% --- SEZIONE 7: VERIFICHE HARDWARE ---
\section{Verifiche hardware}
\label{sec:hwverif}
I punti seguenti derivano dallo schema e dalla netlist (2026-10-26); vanno confermati con l'oscilloscopio. I requisiti della VERA sul bus e il dettaglio delle modifiche sono in \texttt{VERA-C64-HW-REQUIREMENTS.md}.

\begin{itemize}
  \item \textbf{Ritardo di \texttt{/IO1}/\texttt{/IO2}.} \texttt{IO\_QUALIFY\_NS} e \texttt{BUS\_WR\_SAMPLE\_NS} vanno tarati misurando il ritardo di \texttt{/IOx} rispetto a PHI2 (PLA + 74LS139, qualche decina di ns) e il momento in cui il dato in scrittura è stabile.
  \item \textbf{Gating di \texttt{U19}} (nello schema). \texttt{U24}/\texttt{U25} realizzano \texttt{NAND(PHI2, NAND(R/W, DEV\_SEL\_N, /IO1))}: rispetto a RBL-XE l'ingresso \texttt{\textasciitilde mEXSEL} è diventato \texttt{\textasciitilde mIO1} e \texttt{\textasciitilde mMPD} è fisso a 3V3. La GeoRAM è sempre attiva: ogni lettura a \$DExx abilita \texttt{U19}.
  \item \textbf{Hold del dato in scrittura verso la VERA.} Lo stesso fronte di discesa di PHI2 chiude WR\_n e \texttt{U19}: verificare che il dato resti stabile dopo la salita di WR\_n.
  \item \textbf{\texttt{/IRQ} e \texttt{/RESET}} passano dai buffer open-drain \texttt{U26} e \texttt{U27} (nello schema): la scheda tira solo in basso le linee condivise.
  \item \textbf{Linee non usate.} \texttt{/GAME}, \texttt{/EXROM}, \texttt{/ROML}, \texttt{/ROMH}, \texttt{/NMI} e Dot Clock restano scollegate; \texttt{BA} e \texttt{/DMA} arrivano solo a punti di test.
  \item \textbf{PCB} ancora Atari: da rifare con il connettore a pettine della porta di espansione.
\end{itemize}

\subsection*{Sequenza di reset e configurazione}
\texttt{setup()} (Core\,1) tiene \texttt{ARESET} e \texttt{CRESET} bassi, avvia \texttt{LogTask} sul Core\,0, configura i GPIO, abilita i traslatori degli indirizzi (\texttt{ABUS\_OE\_N}), rilascia \texttt{CRESET}, attende \texttt{CDONE} (timeout 5\,s) e \texttt{VERA\_POST\_CDONE\_DELAY\_US} (default 1000\,\textmu s) per il POR interno della VERA. Poi crea il \texttt{MonitorTask} sul Core\,1, che maschera le interruzioni e solo allora rilascia \texttt{ARESET}. La sequenza vale solo al power-on.

% --- SEZIONE 8: CONCLUSIONE ---
\section{Conclusione}
Con PHI2 alto per $\approx$490\,ns l'ESP32-S3 a 240\,MHz dispone di circa 117 cicli per ciclo di bus, contro i 67 della versione Atari. La qualificazione tramite \texttt{/IO1} e \texttt{/IO2} riduce la decodifica alla sola lettura di A0--A7; con il percorso critico in assembly, visto \texttt{/IOx} servono 5 istruzioni e una lettura APB per \texttt{DEV\_SEL\_N} e circa 10 istruzioni per il dato GeoRAM sul bus.

Il Core\,1 è dedicato al bus a interruzioni mascherate e il log passa al Core\,0 tramite un ring buffer senza lock. Restano da misurare sulla scheda il ritardo di \texttt{/IOx}, il tempo dal fronte di PHI2 al dato GeoRAM, la latenza degli accessi APB e il comportamento di \texttt{U19}; prima serve il PCB adattato al C64.

\end{document}
