gianlucarenzi/Vera-Module-RBL-C64/images/VERA-MODULE-RBL.png

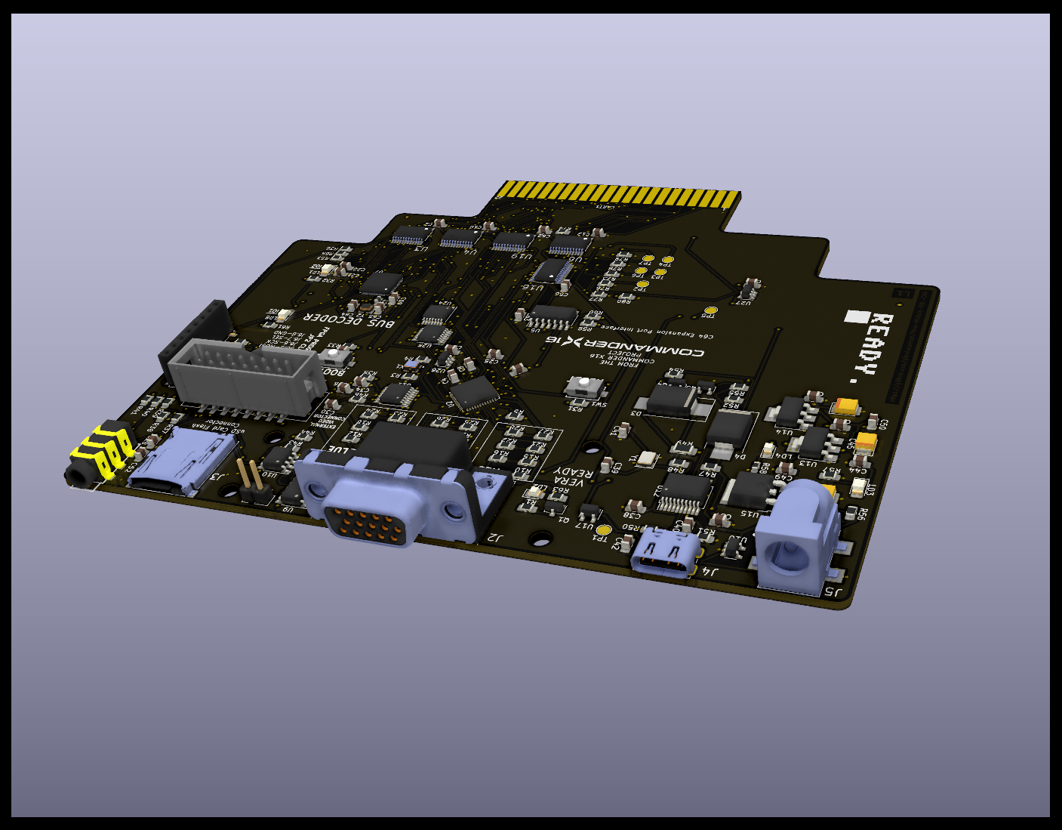
images/VERA-MODULE-RBL.png
