gianlucarenzi/Vera-Module-RBL-C64/VERA-XE-HDMI-Expansion-brd.dxf

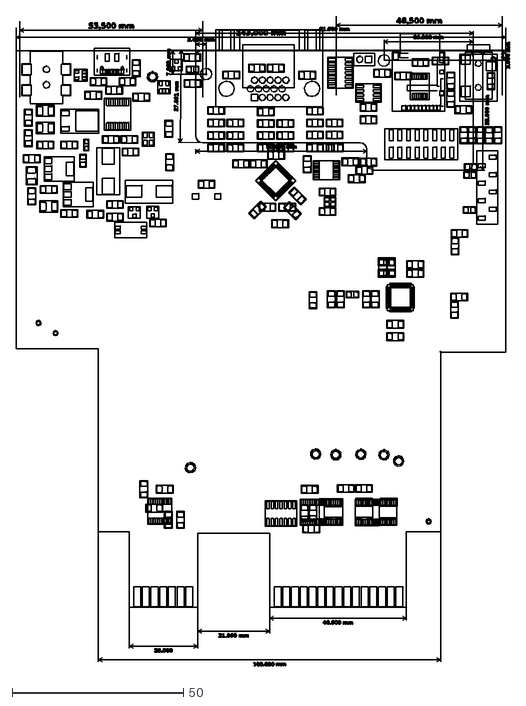
[picture p10: CAD file, 2026-10-21]
VERA-XE-HDMI-Expansion-brd.dxf
144.2 x 189.9
