gianlucarenzi/Vera-Module-RBL-C64/(list of files, cad)

Other CAD files:
images/VERA-MODULE-RBL.step
