gianlucarenzi/Vera-Module-RBL-C64/firmware/FPGA/build-and-programming-guide.pdf

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

VERA RBL-C64 FPGA Build & Programming Guide | Rev 6
0 | Contents
1 Overview | 2
2 Prerequisites | 3
3 Build Flow | 4
4 Programmer Wiring | 6
5 Reset Sequencing | 7
6 Pin Assignment | 8
7 GeoRAM | 10
8 Timing | 10
9 Source File Reference | 11

1 Overview

This document describes the complete workow for building and programming the FPGA rmware for the VERA RBL-C64 module. The rmware implements the Commodore 64 expansion-port bus interface on a Lattice iCE40UP5K. It drives the VERA chip select for the registers in IO2 and implements a GeoRAM 256 KB on an external AS6C4008 SRAM, with the GeoRAM bank registers inside the FPGA.

There is a single bitstream (C6502_Interface.bin); no generics or build variants have to be chosen.

1.1 | Architecture summary
| Qualication by /IO1 and /IO2: every access is qualied by the C64 /IO1 (port pin 7,
$DE00$DEFF) and /IO2 (port pin 10, $DF00$DFFF) lines. The C64 PLA asserts them only for CPU accesses (AEC high), so VIC-II fetches, whose addresses also appear on the port, never reach VERA or the SRAM. /IOx already decodes A15A8, so only A7A0 are wired to the FPGA.
VERA registers ($DF00$DF1F, 32 B): the FPGA asserts VERA_CS for one bus cycle only when /IO2 is low, A7A5 are zero, the VERA select latch at $DFFD is set and PHI2 is high. The VERA FPGA drives the data bus.
VERA select latch ($DFFD): a write of any non-zero value selects the VERA, $00 deselects it. The latch always responds and selects only the VERA.
GeoRAM ($DE00$DEFF window, 256 KB total): served by an external 512K×8 SRAM (AS6C4008-55). Window and page/block registers ($DFFE/$DFFF) are always active, independent of the $DFFD latch, like the original cartridge: existing GeoRAM software works without touching $DFFD.
PHI2 synchronisation: PHI2 is treated as a data input and synchronised to the 25 MHz FPGA clock via a two-stage ip-op chain, producing a single-cycle phi2_rise pulse. Register writes are sampled SAMPLE_CLKS clocks later (Section 8).
| No BRAM: the design uses 0 of the 30 EBR blocks.
1.2 | Memory map
Address | Size | Function | Implementation
$DE00$DEFF | 256 B GeoRAM data window (one
| | page), always active | External SRAM
$DF00$DF1F | 32 B | VERA registers, VERA_CS when the VERA is selected | VERA FPGA
$DFFD | 1 B | VERA select latch (write only): ̸= $00 selects, $00 deselects | Register
$DFFE | 1 B | GeoRAM page register (write only, 063, D5D0) | Register
$DFFF | 1 B | GeoRAM block register (write only, 015, D3D0) | Register

$DF20$DFFC are not decoded. The GeoRAM registers are decoded exactly at $DFFE/$DFFF, without the $DF80$DFFD mirrors of some GeoRAM cartridges, so the latch at $DFFD does not collide with them. Latch and GeoRAM registers power up at zero (VERA deselected) and are not cleared by a C64 reset, like the original GeoRAM.

LDA # $04 : STA $DFFF | ; GeoRAM block 4 ( always active )
LDA # $23 : STA $DFFE | ; GeoRAM page 35

LDA $DE45 | ; GeoRAM byte $12345
LDA # $01 : STA $DFFD | ; select the VERA at $DF00 - $DF1F
LDA # $00 : STA $DFFD | ; deselect the VERA

Listing 1: Typical use from 6510 code

1.3 VERA chip select

sel_vera <= '1 ' when IO2_N = '0 ' and A (7 downto 5) = "000" and vera_sel = '1 ' else '0 ';
VERA_CS <= '0 ' when sel_vera = '1 ' and PHI2 = '1 ' else '1 ';

Listing 2: VERA decode in C6502_Interface.vhd

VERA_CS is never asserted for $DF20$DFFF (latch and GeoRAM registers included), for $DExx, for any other address, for VIC-II cycles (no /IO2), or for $DF00$DF1F while $DFFD holds zero. PHI2 gating hides the address decode glitches of PHI1.

2 | Prerequisites
2.1 | FPGA toolchain

While some tools are available via apt on Debian/Ubuntu, they are often outdated (especially on Debian 11). The recommended way to set up the toolchain is using the OSS CAD Suite, which provides pre-compiled, up-to-date versions of Yosys, nextpnr, GHDL, and all required plugins.

2.1.1 Installing OSS CAD Suite (Recommended for Debian 11)

1. Download the latest Linux x64 archive from: https://github.com/YosysHQ/oss-cad-suite-build/releases/latest
2. Extract the archive (e.g., to $HOME/oss-cad-suite).
3. Add the bin directory to your PATH:

export PATH =" $HOME / oss - cad - suite / bin : $PATH "

This suite includes yosys, nextpnr-ice40, icepack, iceprog, and ghdl with the ghdl-yosys-plugin already integrated.

2.1.2 Alternative: Manual installation via apt (Debian 12+)

On newer distributions, you can try:

sudo apt install fpga - icestorm nextpnr - ice40 yosys ghdl

Note: if installing via apt, you will likely need to build the ghdl-yosys-plugin from source as described below, because it is rarely packaged.

git clone https :// github . com / ghdl / ghdl - yosys - plugin
cd ghdl - yosys - plugin
make
sudo make install

2.2 Flash programming tools

On modern distributions (e.g. Debian 12+), openFPGALoader can be installed via package man-ager:

sudo apt install openFPGALoader

On older distributions like Debian 11 (Bullseye), the package is not available and must be built from source.

2.2.1 Building openFPGALoader from source

First, install the required dependencies and build tools:

sudo apt install git cmake make g ++ pkg - config libusb -1.0 -0 - dev \ libhidapi - dev libgpiod - dev libusbmuxd - dev

Then, clone the repository and build the project:

git clone https :// github . com / trabucayre / openfpgaloader cd openfpgaloader
mkdir build
cd build
# Use - DCMAKE_INSTALL_PREFIX = $HOME to install in your home directory # or omit it to install system - wide ( requires sudo make install ) cmake .. - DCMAKE_INSTALL_PREFIX = $HOME

make - j$ ( nproc )
make install

Ensure $HOME/bin is in your PATH if you used the home directory prex.

2.2.2 Iceprog

The iceprog tool is already included in the fpga-icestorm package and supports FTDI-based programmers (e.g. FT2232H).

2.3 | Tool roles at a glance
Tool | Input | Output | Purpose
ghdl (plugin) | VHDL sources RTLIL | VHDL elaboration
yosys | RTLIL | .json | Synthesis
nextpnr-ice40 | .json + .pcf | .asc | Place & route
icepack | .asc | .bin | Bitstream packing
openFPGALoader / iceprog | .bin | SPI ash Programming
3 | Build Flow

The design is a single VHDL le with no ROM to pre-load, so the build starts directly from synthesis.

3.1 Step 1 Synthesis

cd firmware / FPGA
yosys -m ghdl -p \

" ghdl -- std =08 C6502_Interface . vhd -e C6502_Interface ; \ synth_ice40 - top C6502_Interface - json C6502_Interface . json "

Listing 3: Synthesis with Yosys and the GHDL plugin

The -m ghdl ag loads the GHDL plugin into Yosys, which handles VHDL analysis and elaboration. The entity has one generic, SAMPLE_CLKS (default 6), that sets the register write sample point (Section 8); the default needs no override.

Last measured results (OSS CAD Suite 2025-10-08):

Resource | Used | Available
ICESTORM_LC | 40 | 5280
ICESTORM_RAM (EBR) | 0 | 30
SB_IO (user I/O) | 35 | 39
ICESTORM_SPRAM | 0 | 4
Fmax (CLK) | 89.54 MHz post-route (target 25 MHz)

These gures predate the change that made the GeoRAM independent of the $DFFD latch; the logic is slightly smaller now. Re-measure after the next build.

3.2 Step 2 Place & Route

Place & route assigns logic cells and routes signals to physical iCE40 resources, guided by the pin constraints le.

nextpnr - ice40 -- up5k -- package sg48 \
-- json C6502_Interface . json \
-- pcf board - pin - mapping . pcf \
-- asc C6502_Interface . asc

Listing 4: Place & route with nextpnr-ice40

Important: all pin numbers in board-pin-mapping.pcf are placeholders. Edit the le to match your actual schematic before this step (see Section 6).

3.3 Step 3 Pack the bitstream

icepack converts the ASCII intermediate format produced by nextpnr into the binary bitstream that is written to the SPI ash.

icepack C6502_Interface . asc C6502_Interface . bin

Listing 5: Pack the binary bitstream

The .bin le is what gets programmed into the SPI ash. Bitstream size is device-dependent (not design-dependent) on the iCE40: ≈104 KB for the iCE40UP5K SG48.

3.4 Step 4 Program the SPI ash

The iCE40UP5K loads its conguration from an external SPI NOR ash at power-up. The programmer writes the bitstream into that ash.

3.4.1 Using openFPGALoader (recommended)

openFPGALoader -b ice40_generic C6502_Interface . bin

Listing 6: Program with openFPGALoader

Select the programmer cable explicitly if needed:

openFPGALoader -- cable ft2232 | C6502_Interface . bin | # FTDI
FT2232H
openFPGALoader -- cable ft232 | C6502_Interface . bin | # FTDI FT232H
openFPGALoader -- cable tigard | C6502_Interface . bin | # Tigard
openFPGALoader -- cable raspberrypi C6502_Interface . bin | # Raspberry
Pi GPIO

3.4.2 Using iceprog (FTDI FT2232H)

iceprog C6502_Interface . bin

# Erase + write ( useful if previous write was partial ) iceprog -e 1048576 C6502_Interface . bin

| Listing 7: Program with iceprog
3.5 | One-command build and ash

The firmware/FPGA/Makefile wraps all steps:

cd firmware / FPGA
make | # synthesise + P & R + pack -> C6502_Interface .
bin
make flash | # write the bitstream via openFPGALoader
make flash - iceprog | # write the bitstream via iceprog ( FTDI FT2232H
)
make doc | # regenerate this PDF
make clean | # remove all generated files
4 | Programmer Wiring

The SPI ash is shared between the FPGA (conguration bus at boot) and the programmer (writes the bitstream). During programming, the FPGA is held in reset by asserting CRESET_B low.

Programmer signal iCE40UP5K pin | SPI ash pin
MOSI | SPI_SI | DI
MISO | SPI_SO | DO
SCK | SPI_SCK | CLK
CS# | | CS#
CRST# | CRESET_B |
CDONE | CDONE |

Recommended SPI ash: Winbond W25Q16 (2 MB) or W25Q32 (4 MB).

Supported programmers:

Hardware | Interface | Tool
FTDI FT232H breakout | SPI bitbang | iceprog, openFPGALoader
FTDI FT2232H breakout | MPSSE SPI iceprog, openFPGALoader
Tigard | JTAG/SPI | openFPGALoader
Raspberry Pi (GPIO) | SPI bitbang | openFPGALoader
dirtyJTAG (STM32F103) JTAG | openFPGALoader
5 | Reset Sequencing

The VERA RBL-C64 module requires a dened power-on boot sequence: the Commodore 64 and the VERA graphics chip must remain in reset until all FPGA congurations have completed. This is implemented with a single 74LVC1G08 logic gate no MCU or rmware is needed.

5.1 Boot sequence

1. Power-on: both VERA_RESET# and C64_RESET# are held low.
2. FPGA ready (FPGA_CDONE goes high, ≈50100 ms after power-on): VERA_RESET# is released, allowing VERA to start loading its own bitstream from its SPI ash.
3. VERA ready (VERA_CDONE goes high, ≈200500 ms later): C64_RESET# is released and the C64 boots normally.

The natural SPI ash loading times provide all necessary delays; no RC timer or additional delay circuit is required.

5.2 | Logic
Signal | Boolean expression
VERA_RESET# | FPGA_CDONE
C64_RESET# | FPGA_CDONE AND VERA_CDONE
FPGA_CDONE | VERA_CDONE | VERA_RST# | C64_RST# | Phase
0 | 0 | 0 | 0 | Power-on / FPGA loading
1 | 0 | 1 | 0 | FPGA ready, VERA loading
1 | 1 | 1 | 1 | System ready
5.3 | Circuit 74LVC1G08 (SOT-23-5)

A single 74LVC1G08 (2-input AND gate, SOT-23-5) implements C64_RESET#. VERA_RESET# connects directly from FPGA_CDONE through a 33 Ω series resistor.

VCC - -[4 k7 ] - -+ - - - - - - - - FPGA_CDONE ( open - drain )
+ - -[33 R ] - VERA_RESET # |
| + - - A -\
+ - - - 74 LVC1G08 - - -[33 R ] - - - C64_RESET #
| + - - B -/
VCC - -[4 k7 ] - -+ - - - - - - - - VERA_CDONE ( open - drain )

Both CDONE outputs are open-drain; they require an external pullup to VCC. The 33 Ω series resistors limit current if an external driver (e.g. a reset button on the C64 /RESET line, which pulls it to GND) conicts with the 74LVC output.

Why 74LVC and not 74HC? The 74LVC family has 5 V tolerant inputs while operating at 3.3 V VCC. The CDONE signals are at 3.3 V; the C64 /RESET line belongs to a 5 V TTL system. The 74LVC output at 3.3 V is correctly recognised as HIGH by 5 V TTL logic (VIH = 2.0 V). The 74HC family is not suitable for this mixed-voltage interface.

5.4 | Bill of materials
Ref | Value | Package | Function
U1 | 74LVC1G08 SOT-23-5 2-input AND gate
R1 | 4.7 kΩ | 0402 | Pullup | | for
FPGA_CDONE
R2 | 4.7 kΩ | 0402 | Pullup | | for
VERA_CDONE
R3 | 33 Ω | 0402 | Series | resistor | on
VERA_RESET#
R4 | 33 Ω | 0402 | Series | resistor | on
C64_RESET#

Total cost under 0.30 EUR; no rmware required.

6 Pin Assignment

Edit board-pin-mapping.pcf and replace every pin number with the actual pad number from your schematic before running nextpnr-ice40.

The CLK signal must be assigned to a Global Buer (GB) input pin. Valid GB pins on the iCE40UP5K SG48 package are: 20, 28, 31, 38, 41, 43, 48. The placeholder in the current PCF (pin 35) is not a GB pin.

Valid user I/O pin numbers for SG48 (39 total):

2, 3, 4, 6, 9, 10, 11, 12, 13, 14, 15, 16, 17, 18, 19, 20, 21,
23, 25, 26, 27, 28, 31, 32, 34, 35, 36, 37, 38, 39,
40, 41, 42, 43, 44, 45, 46, 47, 48

Pins 1, 5, 7, 8, 22, 24, 29, 30, 33 are power/ground or reserved and must not appear in the PCF le nextpnr rejects them with an error.

I/O budget: the design uses 35 of the 39 user I/O pins; 4 are free.

Group | | | | | Pins
Address A[7:0] (A15A8 decoded by /IO1, /IO2) | 8
Data D[7:0] (input only, shared net with SRAM DQ) | 8
PHI2, RNW | 2
IO1_N, IO2_N | 2
VERA_CS | 1
SRAM: SRAM_PAGE[5:0], SRAM_BLOCK[3:0], CE/OE/WE | 13
CLK (25 MHz, GB pin) | 1
Total | 35

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

* Pin numbers are placeholders. Replace with actual pad numbers from your board schematic.

7 | GeoRAM
7.1 | External SRAM wiring

AS6C4008-55 (Alliance Memory, 512K×8, 55 ns, 2.75.5 V), lower 256 KB used. The SRAM sits on the 3.3 V side of the level shifters, on the same nets as the FPGA, and is powered at 3.3 V.

SRAM pin | Source | Note
A[7:0] | C64 A[7:0] (PCB net) | Direct trace, no FPGA I/O pin
A[13:8] | FPGA SRAM_PAGE[5:0] | Page register $DFFE
A[17:14] | FPGA SRAM_BLOCK[3:0] Block register $DFFF
A[18] | GND (PCB) | Lower 256 KB of the 512 KB chip
DQ[7:0] | C64 D[7:0] (PCB net) | Shared with FPGA D[7:0]
CE# | FPGA SRAM_CE_N
OE# | FPGA SRAM_OE_N
WE# | FPGA SRAM_WE_N
7.2 | Address formula

16 blocks of 16 KB, each made of 64 pages of 256 bytes:

oset = block × 16384 + page × 256 + A[7 : 0]

sel_page | <= '1 ' when IO2_N = '0 ' and A = x " FE " else '0 ';
sel_block | <= '1 ' when IO2_N = '0 ' and A = x " FF " else '0 ';
sel_georam <= '1 ' when IO1_N = '0 ' else '0 ';

Listing 8: GeoRAM decode in C6502_Interface.vhd

None of these terms depends on the $DFFD latch: the GeoRAM is always active.

7.3 Data transceiver

The board must drive the C64 data bus during GeoRAM reads. SRAM_CE_N is the GeoRAM term of the data transceiver output enable:

OE = NAND

PHI2, NAND(R/W, AND(VERA_CS, SRAM_CE_N))

Every $DExx read is driven from the SRAM (GeoRAM always active); $DF00$DF1F reads are driven only while the VERA is selected.

8 Timing

The C64 runs at 0.985 MHz (PAL) or 1.023 MHz (NTSC); PHI2 is high for ≈490 ns.

8.1 Register writes

The 6510 drives write data during PHI2 high, up to ≈150 ns after the rising edge. The latch ($DFFD) and the GeoRAM registers ($DFFE/$DFFF) are sampled SAMPLE_CLKS clock cycles after the synchronised PHI2 rising edge: with the default of 6 clocks at 25 MHz this is 240 ns after phi2_rise, i.e. ≈280320 ns after the real edge, well inside the PHI2-high window. A PHI2 pulse that ends before the sample point never samples.

8.2 | SRAM read cycle
Event | Time from PHI2 rise | Note
/IO1 asserted by the PLA | ≈5080 ns
SRAM_CE_N asserted | ≈5080 ns /IO1 AND PHI2
SRAM data valid (tAA = 55 ns) | ≈105135 ns AS6C4008-55
6510 samples the data bus | ≈490 ns At PHI2 fall

The read margin is several hundred nanoseconds.

8.3 SRAM write cycle

SRAM_WE_N is asserted combinationally while /IO1 is low, PHI2 is high and R/W is low. The pulse lasts ≈400 ns, far above the 40 ns tWP of the AS6C4008-55. The SRAM latches the data on the WE# rising edge (PHI2 fall); tDH = 0 ns is covered by the 6510 data hold after PHI2 fall.

SRAM_PAGE/SRAM_BLOCK change only on $DFFE/$DFFF writes, which are /IO2 cycles, so they never change while CE# is low.

9 | Source File Reference
File | Description
C6502_Interface.vhd | Top-level VHDL entity (Rev 6, C64 expansion port,
VERA + GeoRAM). Contains the whole bus logic: /IO1//IO2 decode, VERA select latch, GeoRAM reg-
| isters and SRAM control.
board-pin-mapping.pcf | Pin constraints for iCE40UP5K SG48. All pin num-
bers are placeholders edit before use.
Makefile | Targets: all (default), flash, flash-iceprog, doc,
clean.
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
