gianlucarenzi/Vera-Module-RBL-C64/VERA-MODULE-RBL.pdf

## Sheet: VeraModule

## Sheet: BusDecoder

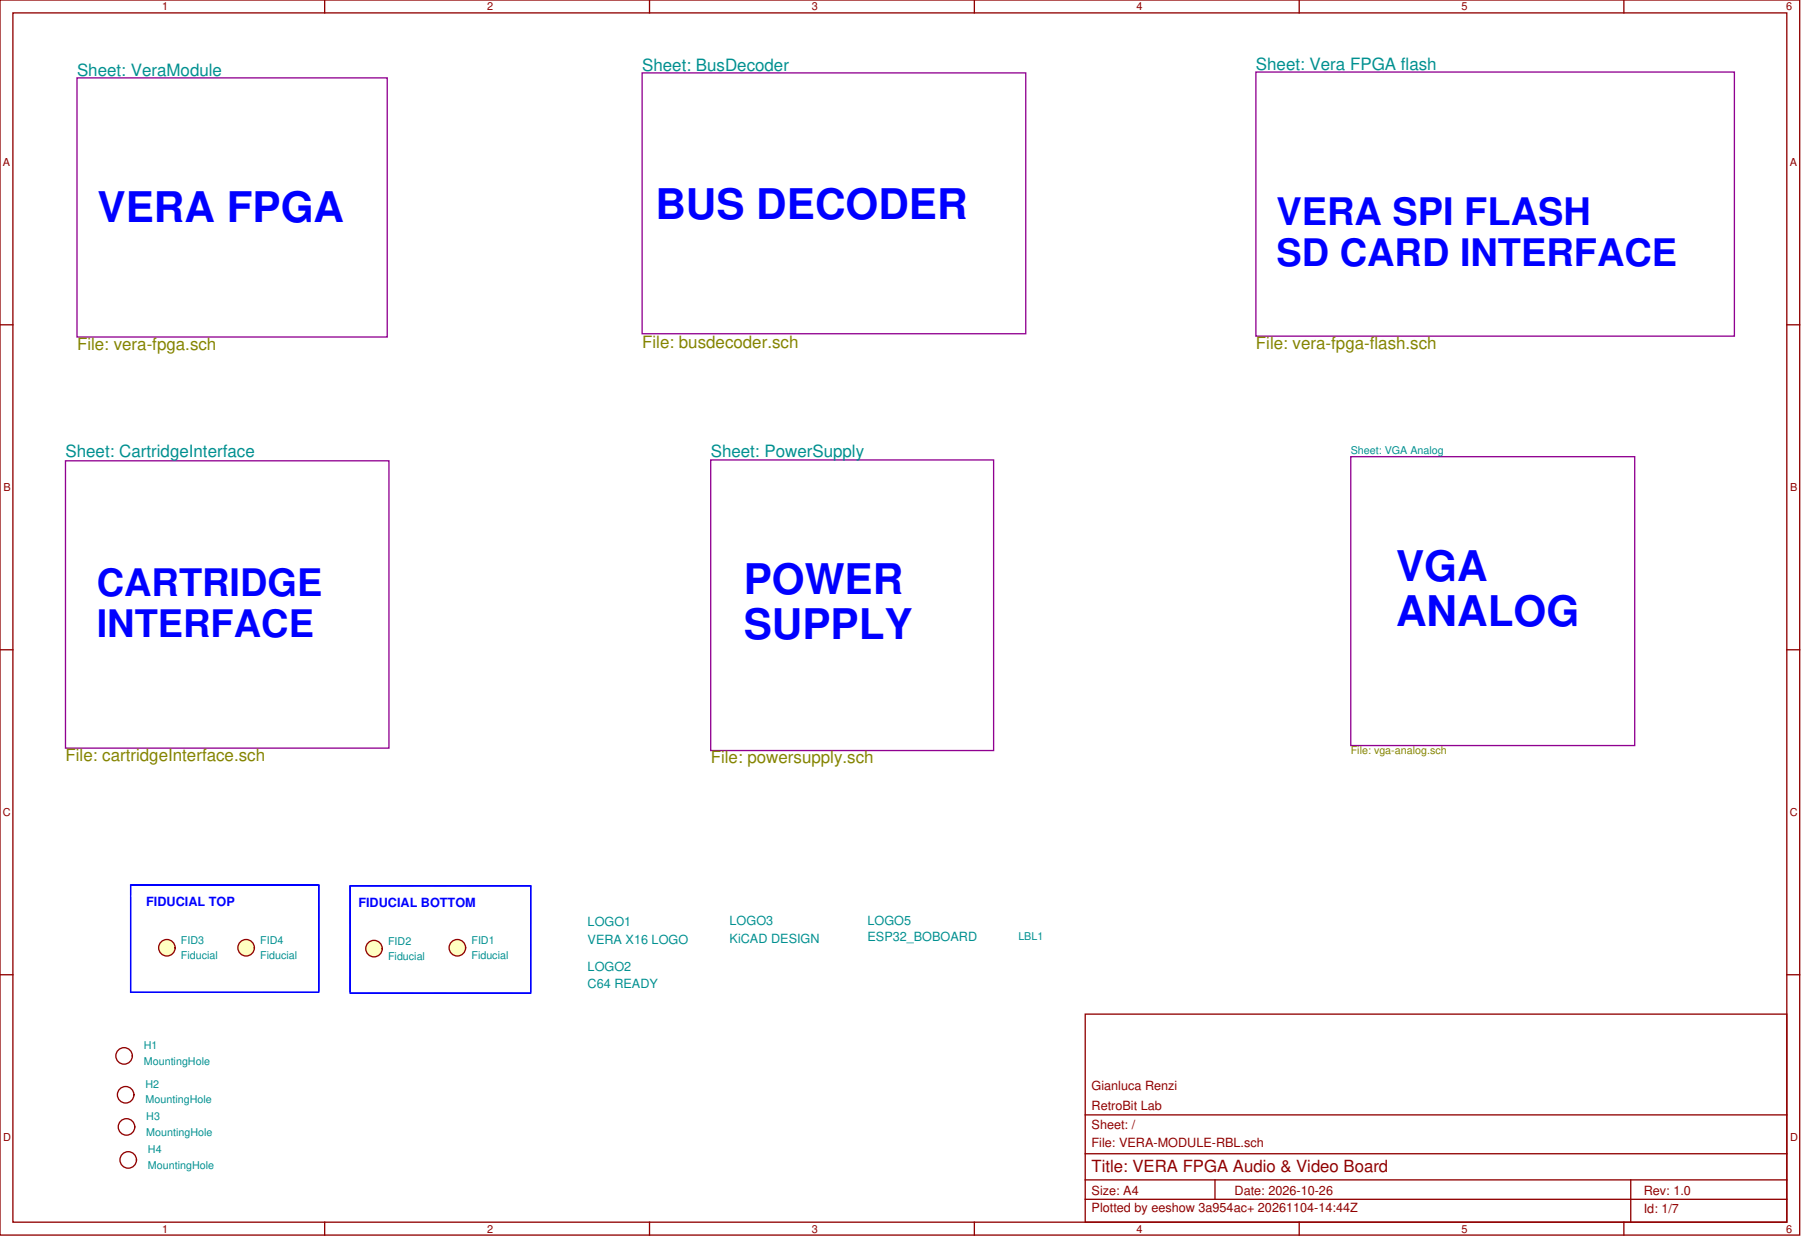
[picture p11: page 1]
Size: A4; Rev: 1.0; Date: 2026-10-26; Sheet: CartridgeInterface; Sheet: PowerSupply; Fiducial; FID3; FID4; FID2; FID1; VERA X16 LOGO; LOGO1; C64 READY; LOGO2; KiCAD DESIGN; LOGO3; ESP32_BOBOARD; LOGO5; LBL1; MountingHole; VERA FPGA; BUS DECODER; CARTRIDGE INTERFACE; POWER SUPPLY; FIDUCIAL TOP; FIDUCIAL BOTTOM; VGA ANALOG

Sheet: Vera FPGA flash

VERA SPI FLASH
SD CARD INTERFACE

File: vera-fpga.sch

File: busdecoder.sch

File: vera-fpga-flash.sch

Sheet: VGA Analog

File: cartridgeInterface.sch

File: powersupply.sch

File: vga-analog.sch

Gianluca Renzi
RetroBit Lab
Sheet: /
File: VERA-MODULE-RBL.sch
Title: VERA FPGA Audio & Video Board

Plotted by eeshow 3a954ac+ 20261104-14:44Z

# IOT_43a 32 VCCIO_0 33

# FPGA VERA LOGIC VIDEO & AUDIO CARD

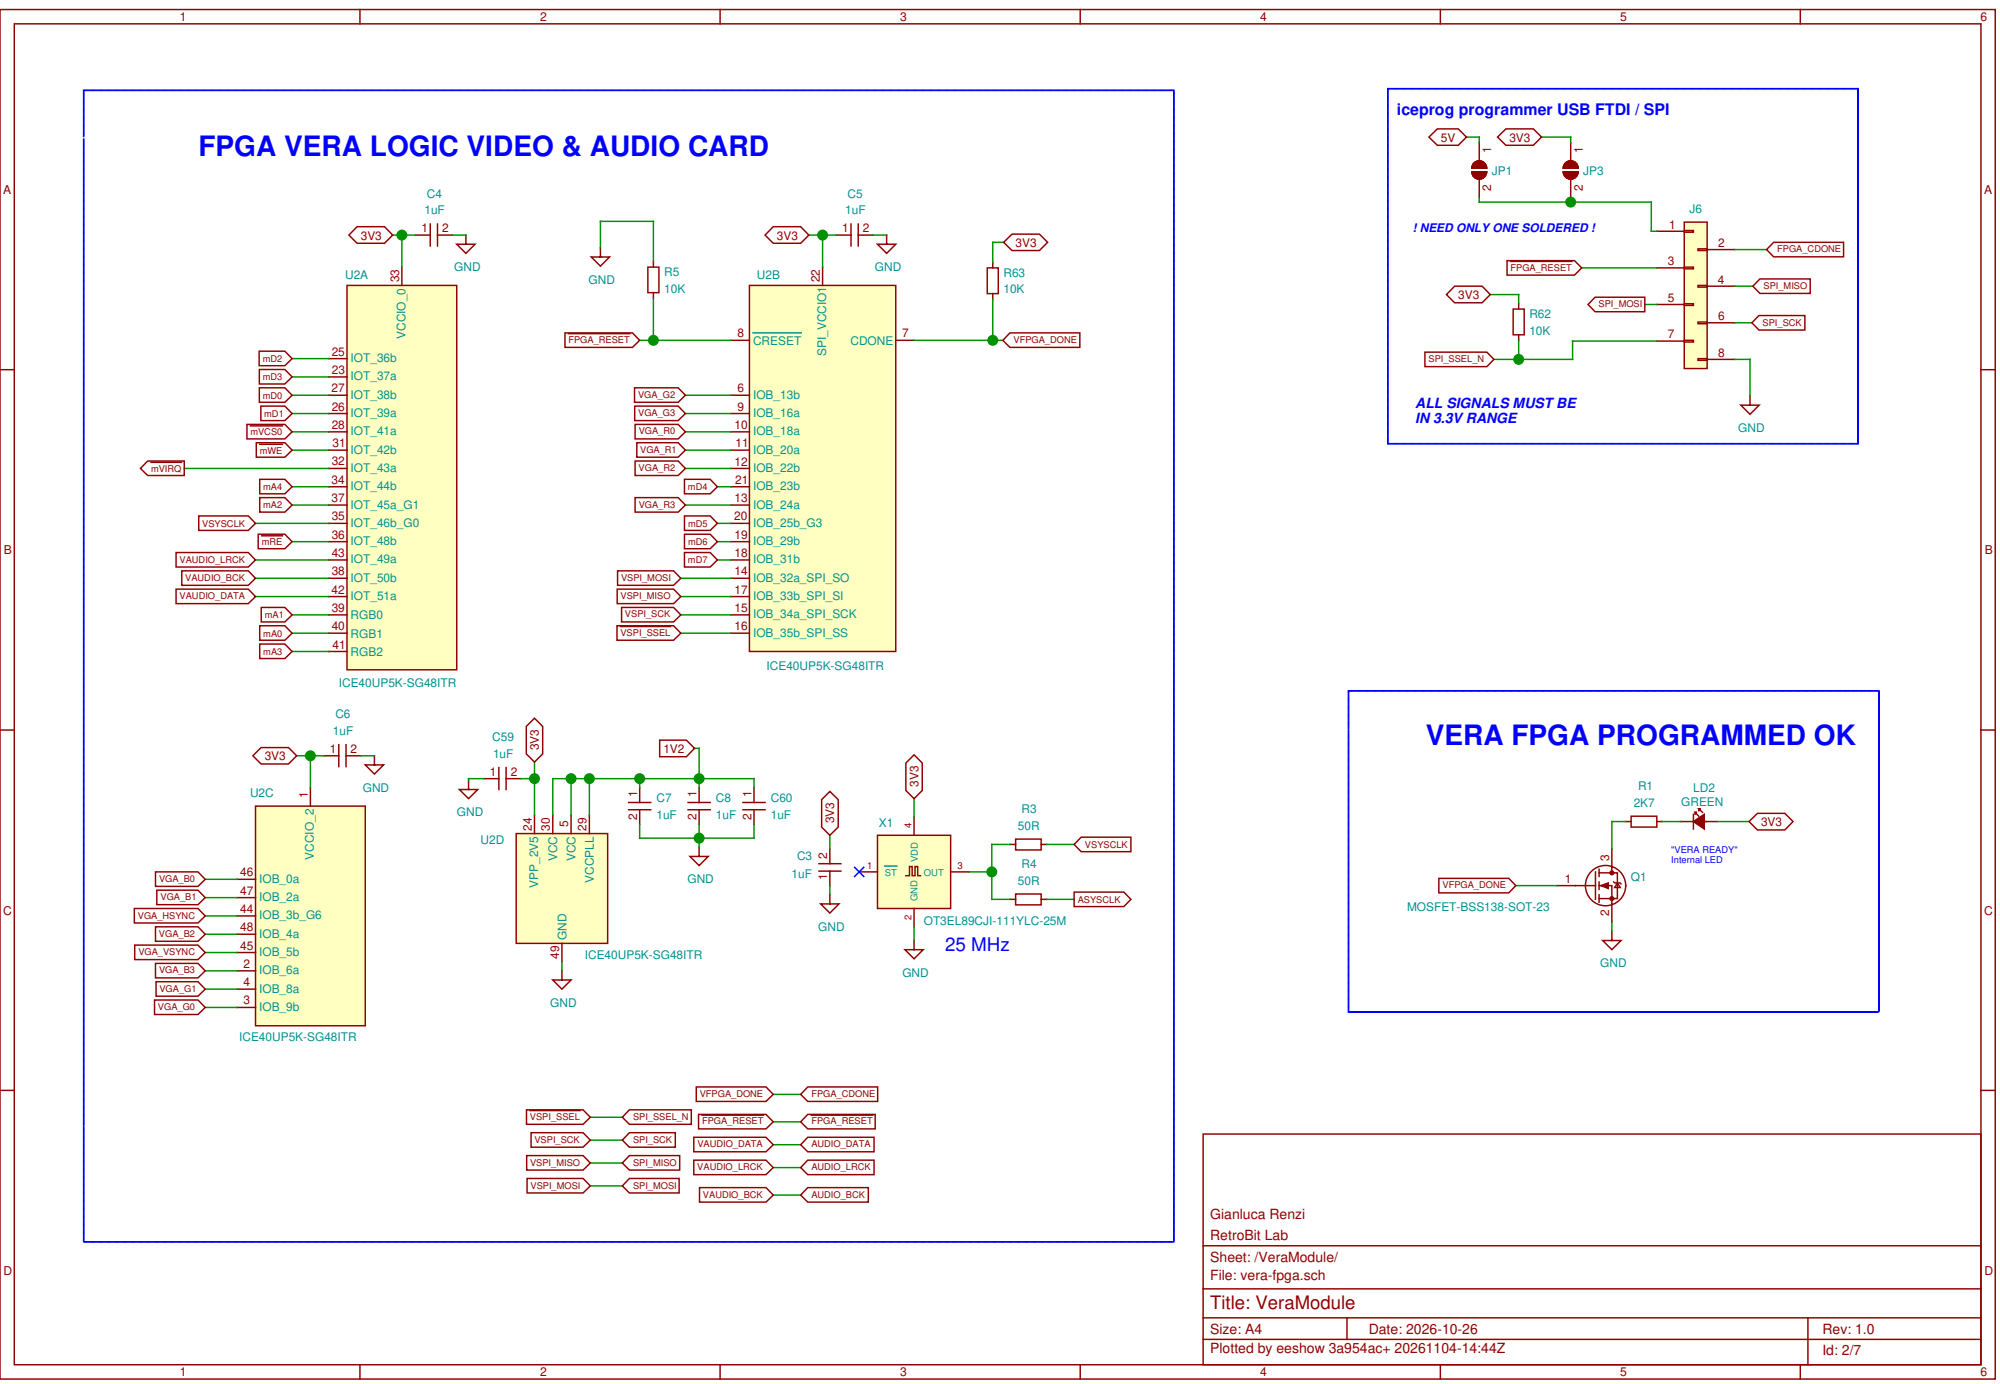
[picture p12: page 2]

iceprog programmer USB FTDI / SPI

! NEED ONLY ONE SOLDERED !

ALL SIGNALS MUST BE
IN 3.3V RANGE

VERA FPGA PROGRAMMED OK

Gianluca Renzi
RetroBit Lab
Sheet: /VeraModule/
File: vera-fpga.sch
Title: VeraModule

# VERA SELECT: latch $DFFD, software only

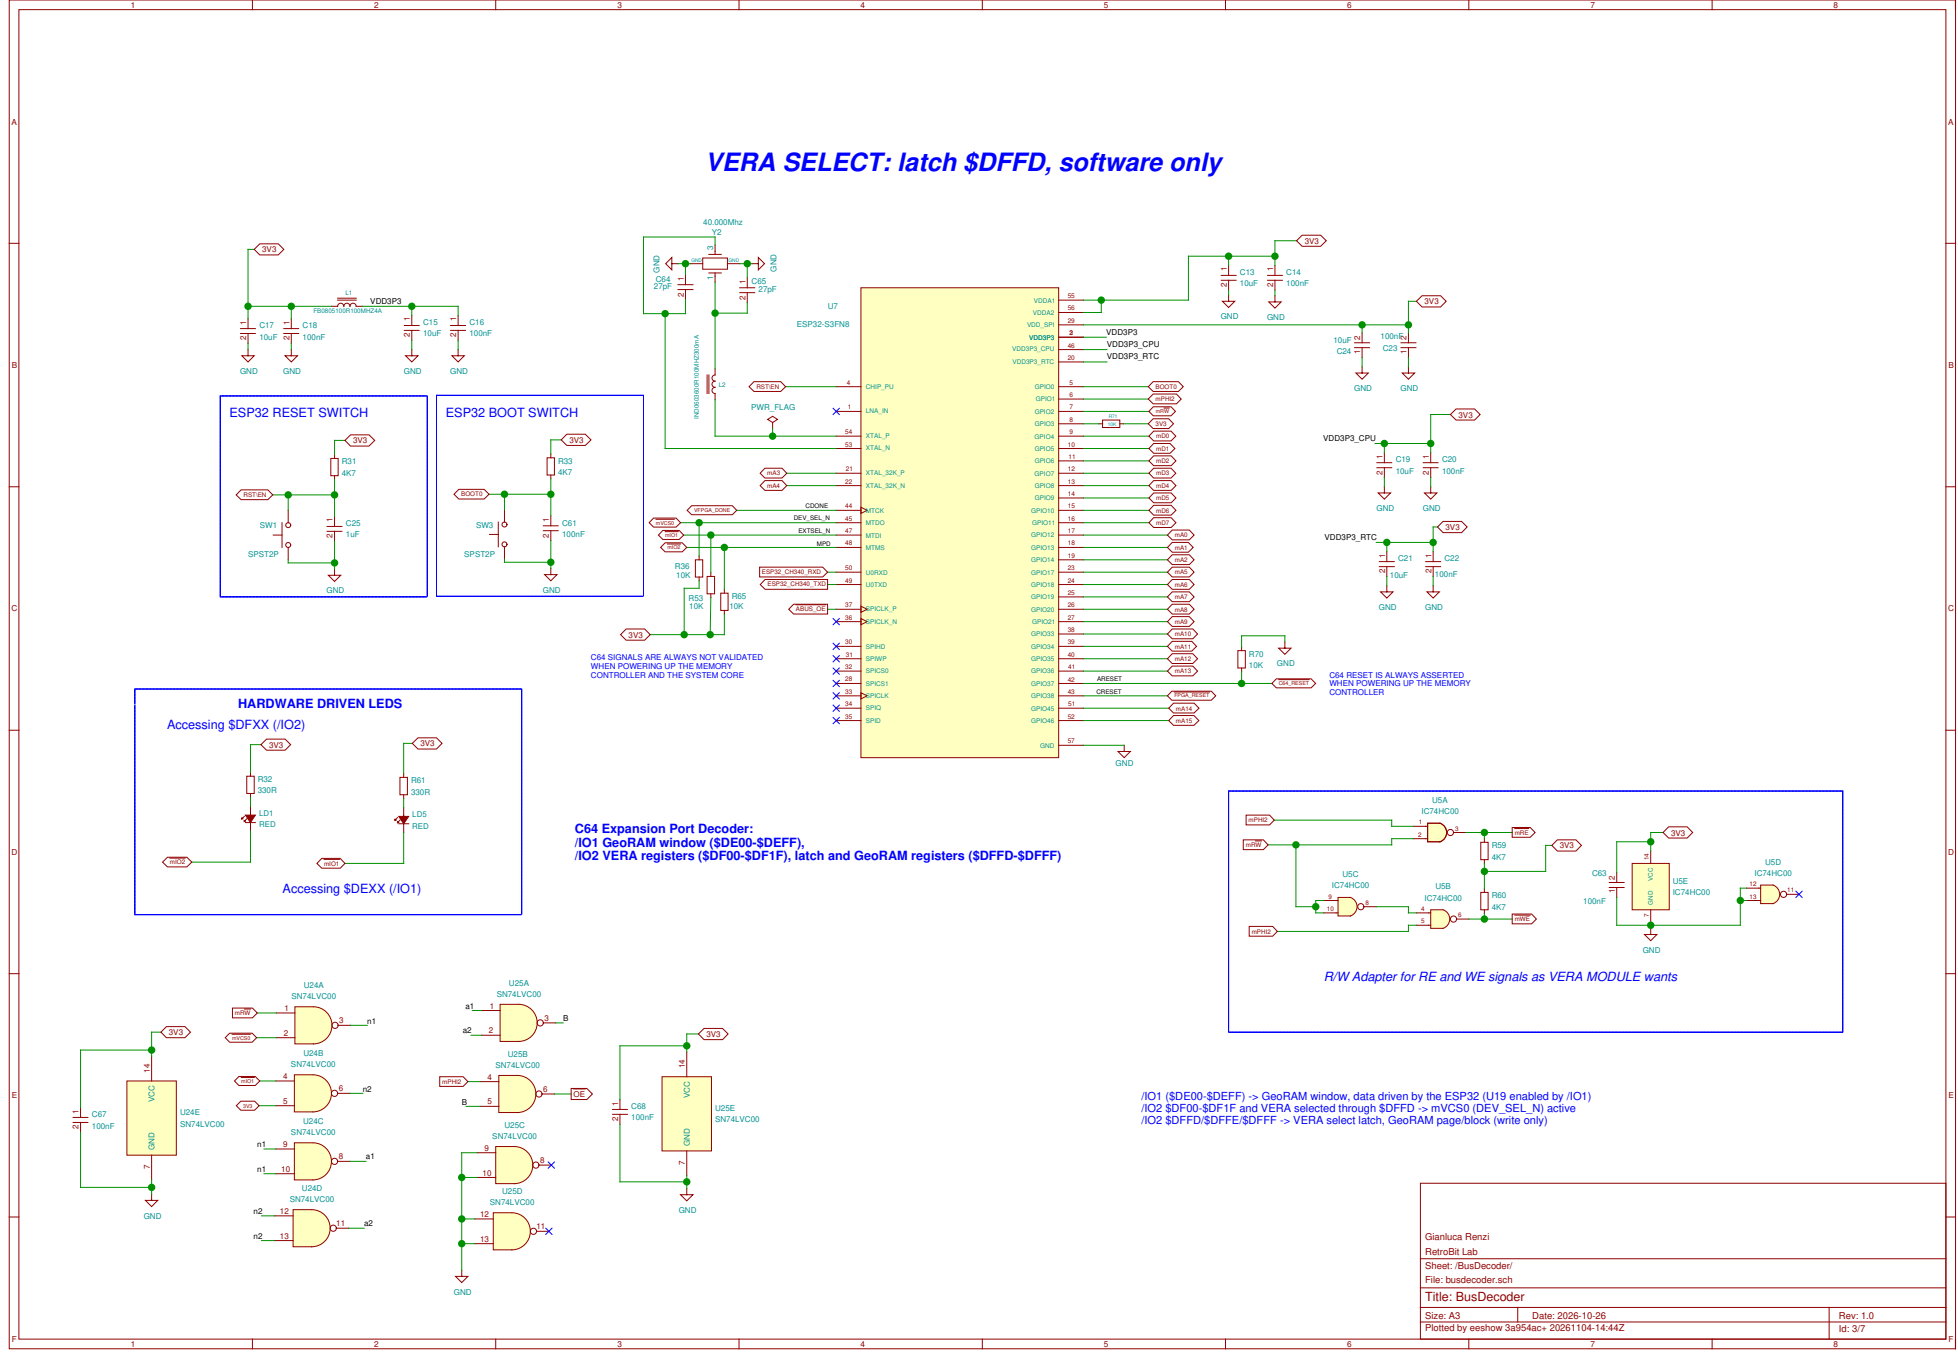
[picture p13: page 3]

C64 SIGNALS ARE ALWAYS NOT VALIDATED
WHEN POWERING UP THE MEMORY
CONTROLLER AND THE SYSTEM CORE

C64 RESET IS ALWAYS ASSERTED
CONTROLLER

C64 Expansion Port Decoder:
/IO1 GeoRAM window ($DE00-$DEFF),
/IO2 VERA registers ($DF00-$DF1F), latch and GeoRAM registers ($DFFD-$DFFF)

R/W Adapter for RE and WE signals as VERA MODULE wants

/IO1 ($DE00-$DEFF) -> GeoRAM window, data driven by the ESP32 (U19 enabled by /IO1)
/IO2 $DF00-$DF1F and VERA selected through $DFFD -> mVCS0 (DEV_SEL_N) active
/IO2 $DFFD/$DFFE/$DFFF -> VERA select latch, GeoRAM page/block (write only)

# COMMODORE 64 EXPANSION PORT INTERFACE

## All 8-Bit signals must be shifted from 5V to 3.3V and vice versa

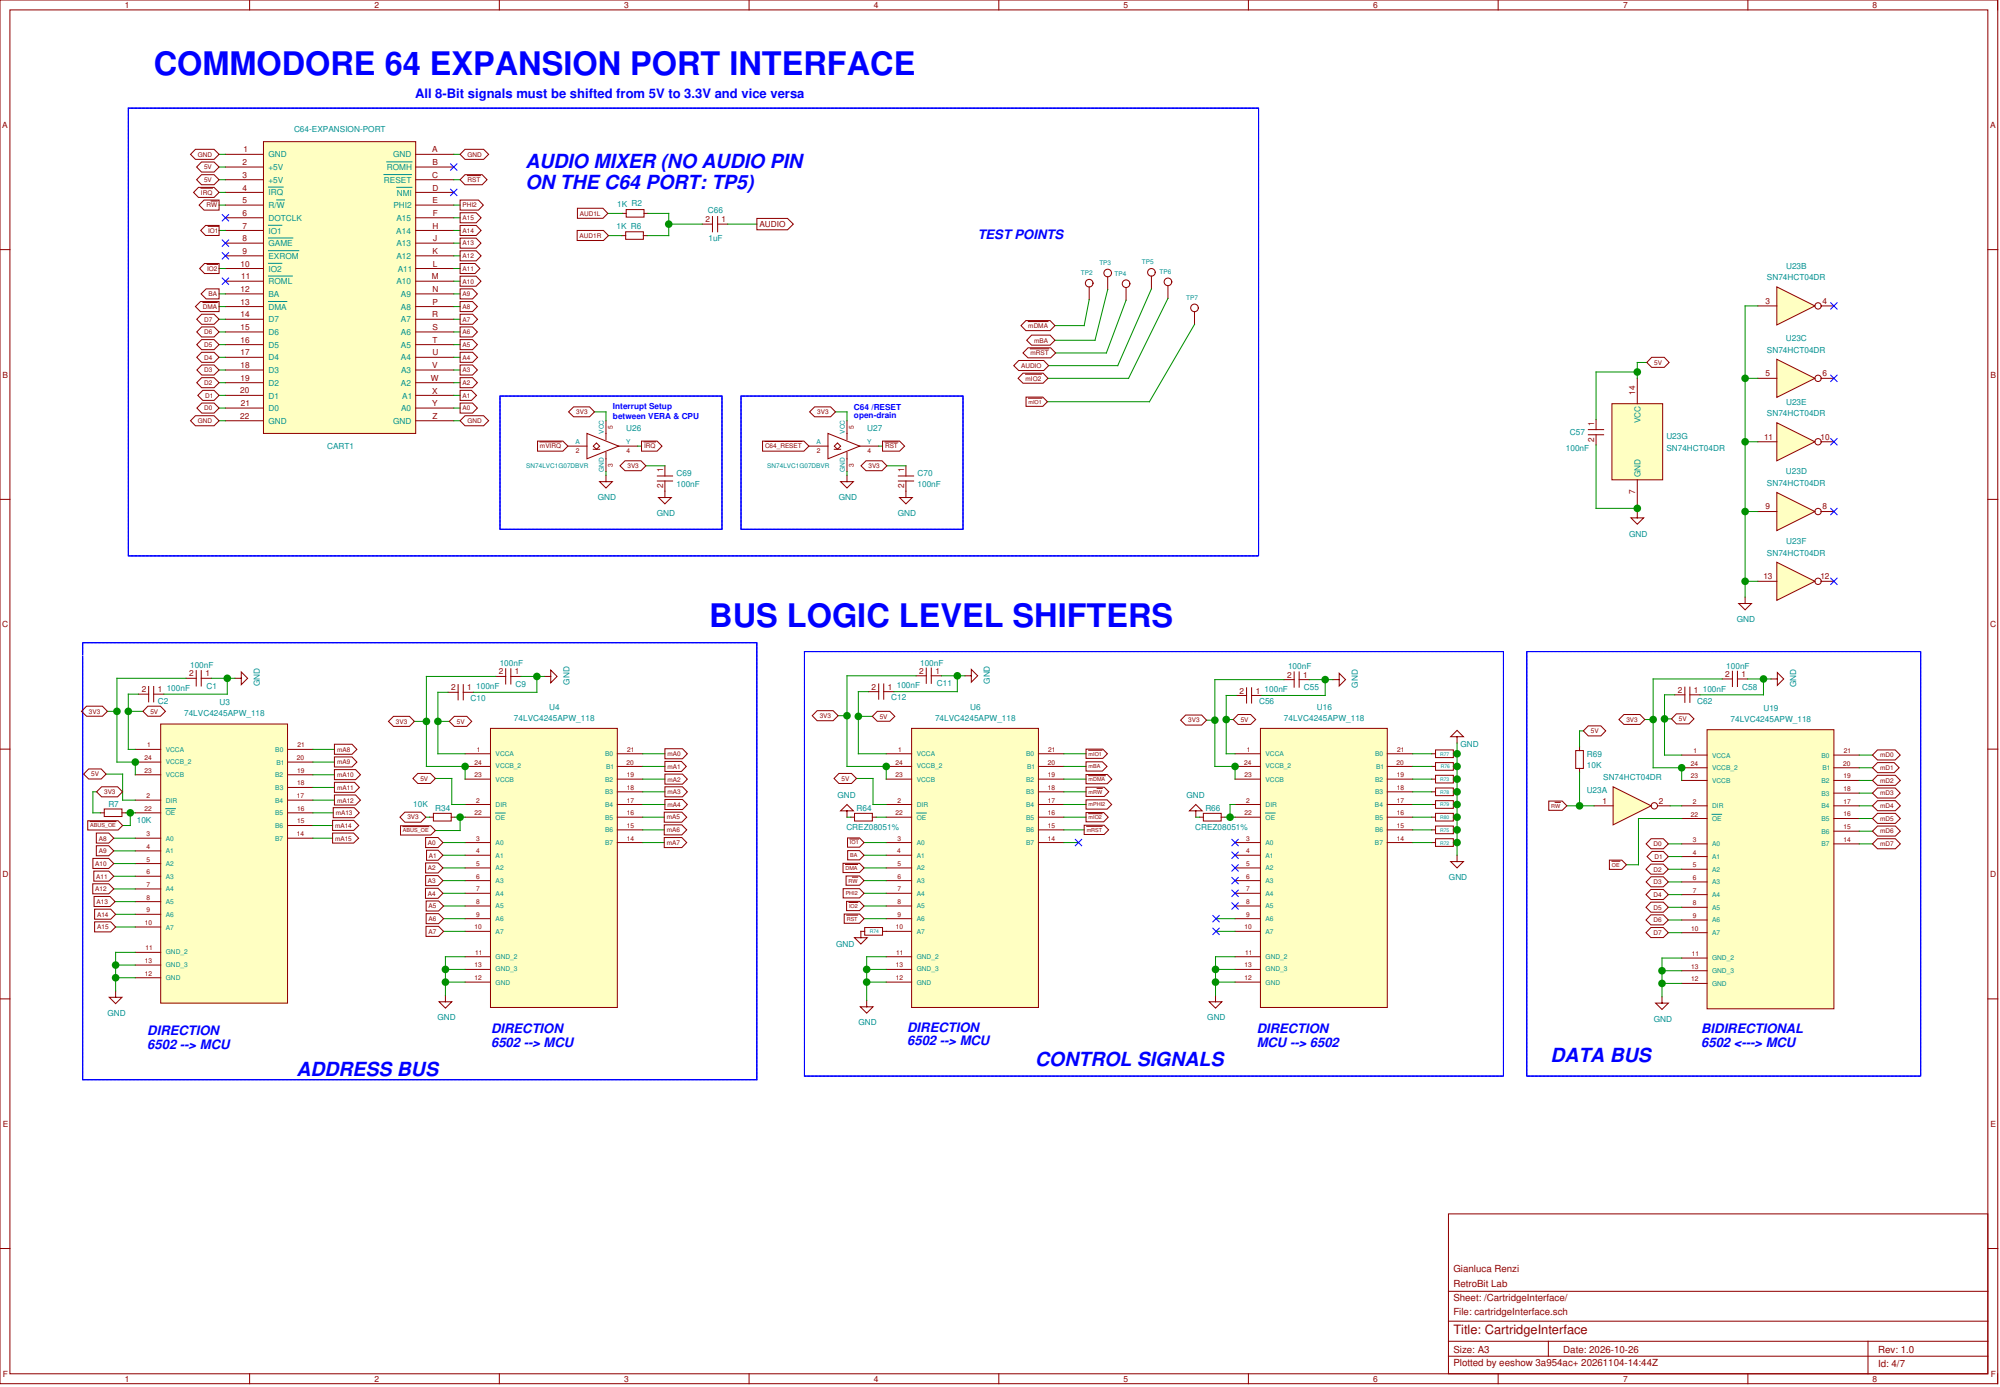
[picture p14: page 4]

AUDIO MIXER (NO AUDIO PIN
ON THE C64 PORT: TP5)

BUS LOGIC LEVEL SHIFTERS

# FPGA/SSD Flash Glue Logic

When programming SPI FLASH for bitstream,

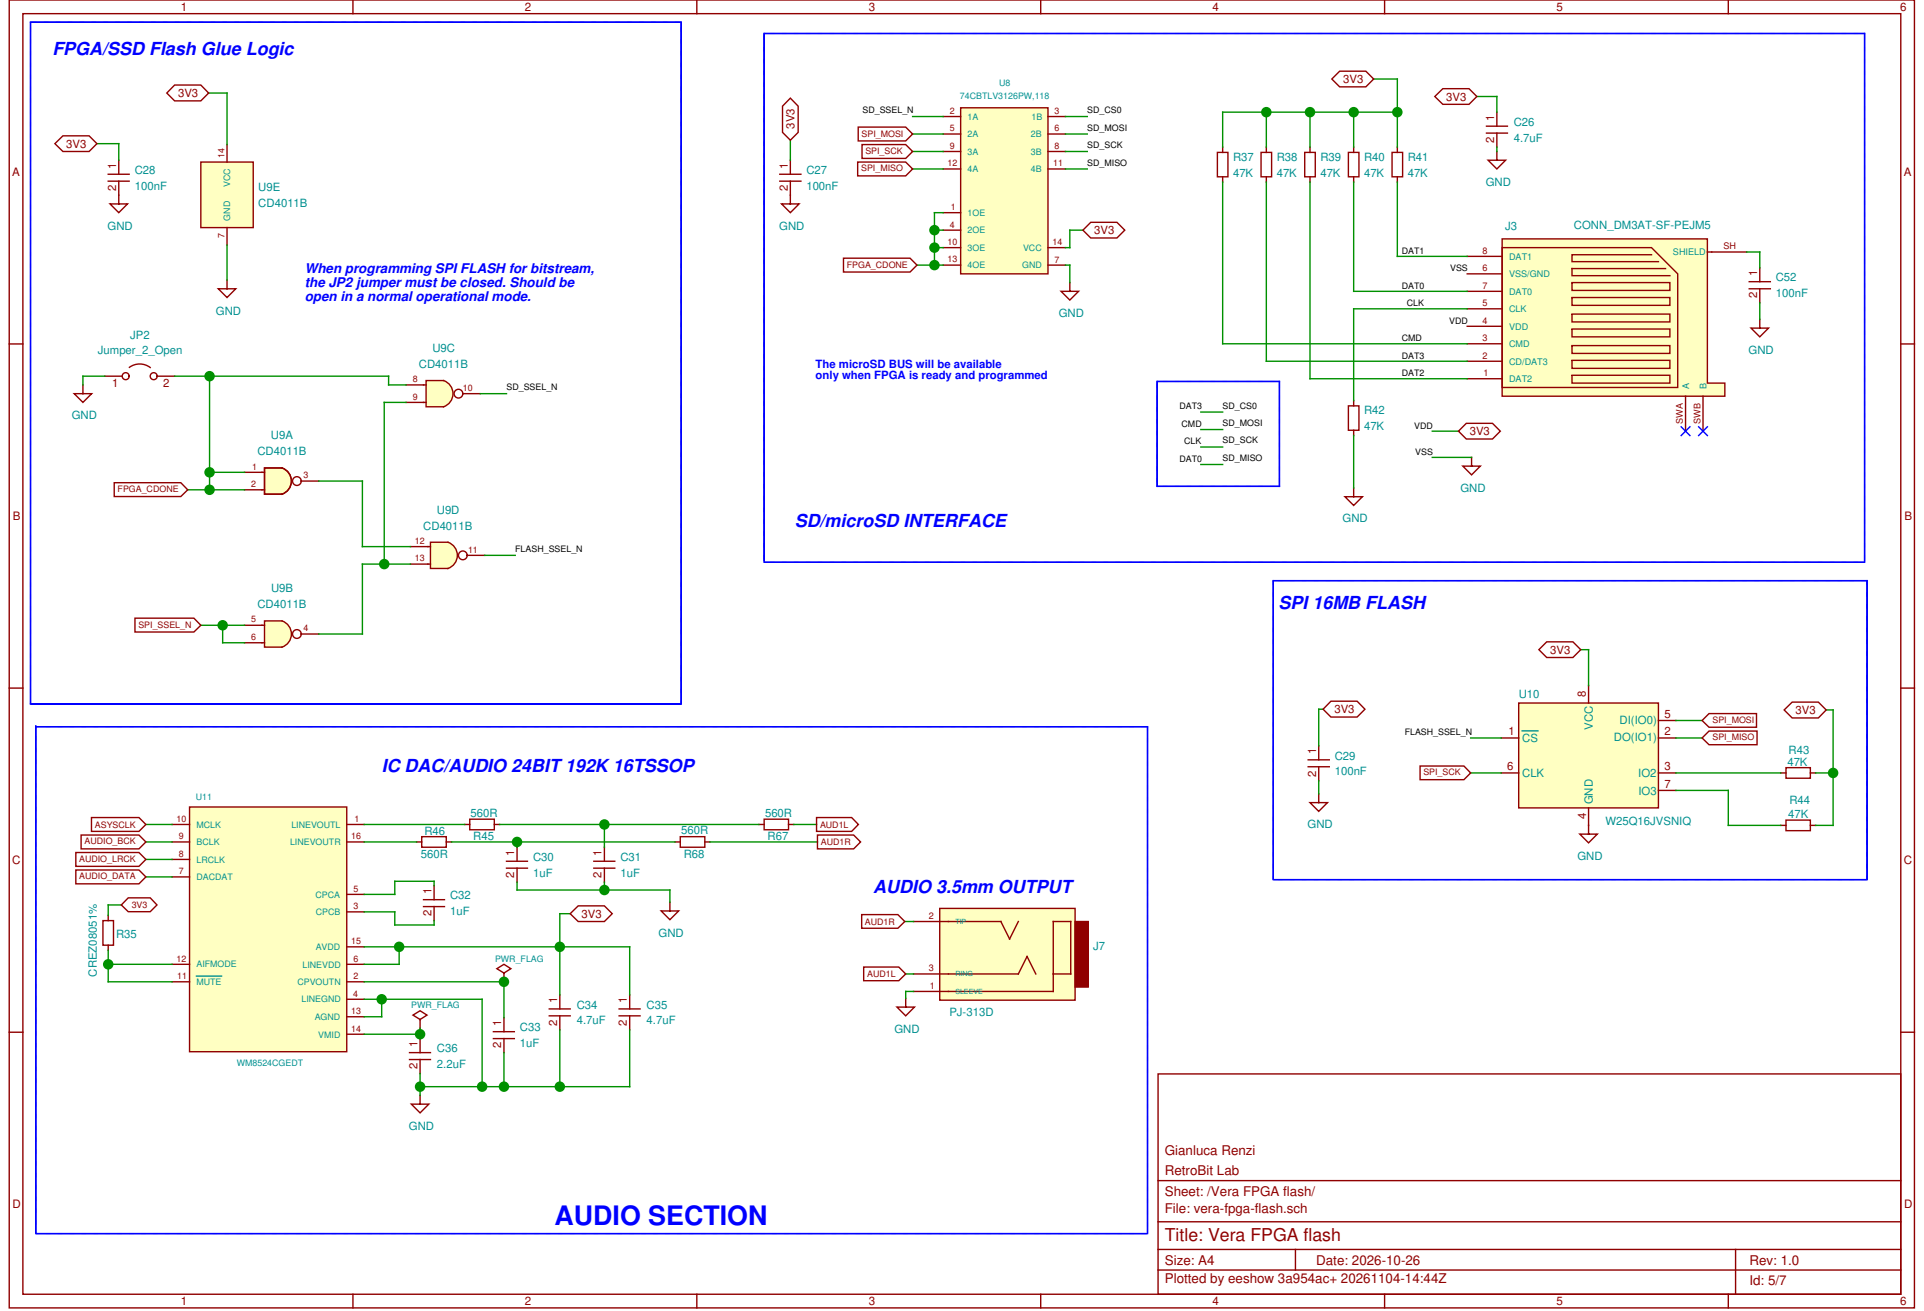
[picture p15: page 5]

the JP2 jumper must be closed. Should be
open in a normal operational mode.

The microSD BUS will be available
only when FPGA is ready and programmed

DAT3 | CD/DAT3 2

DAT2

Gianluca Renzi
RetroBit Lab
Sheet: /Vera FPGA flash/
File: vera-fpga-flash.sch
Title: Vera FPGA flash

# USB ESP32 PROGRAMMING

# POWER LED

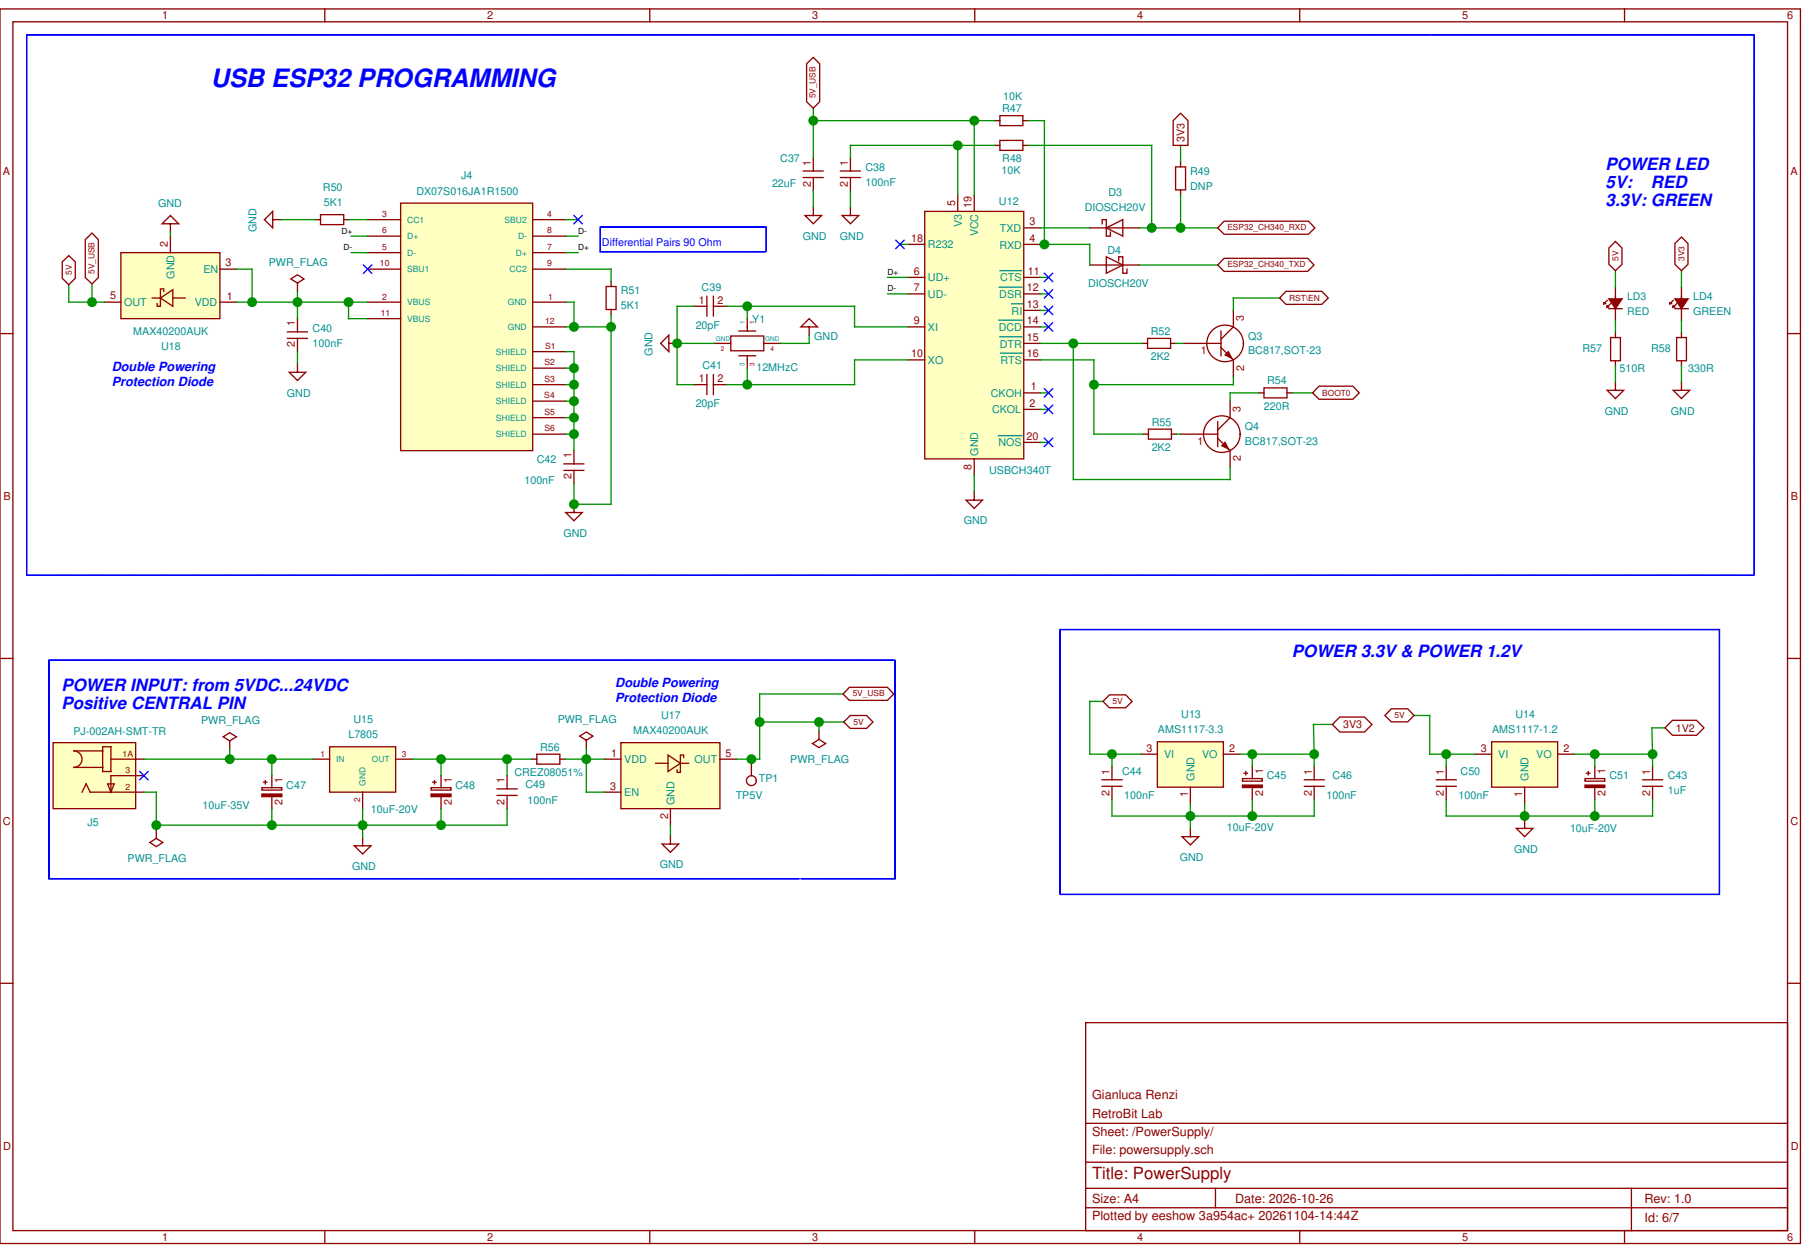
[picture p16: page 6]

# ANALOG VGA SIGNALS

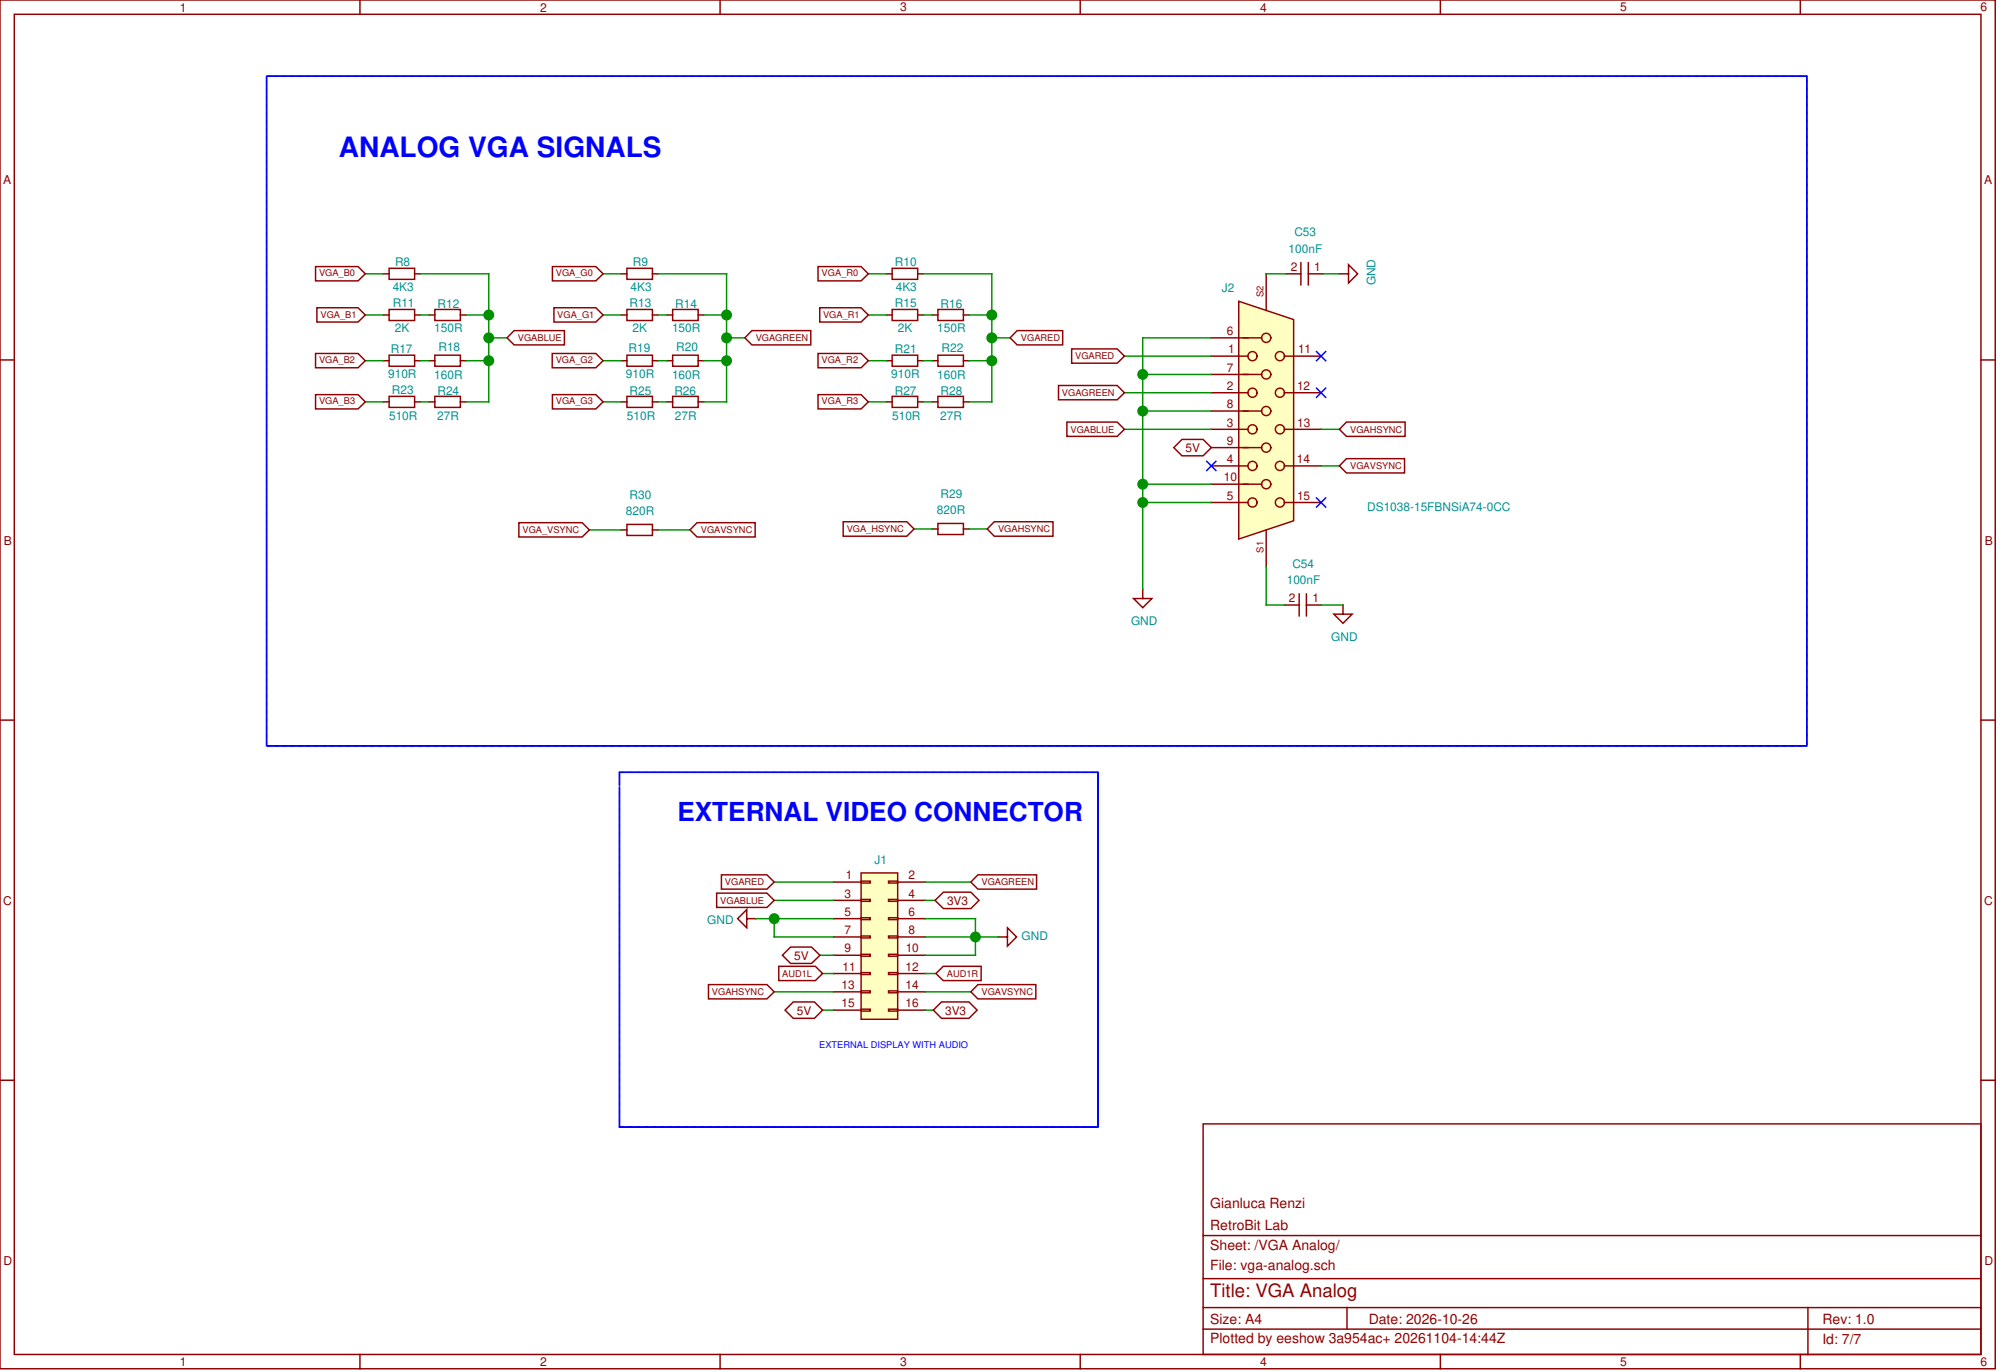
[picture p17: page 7]

EXTERNAL DISPLAY WITH AUDIO

Gianluca Renzi
RetroBit Lab
Sheet: /VGA Analog/
File: vga-analog.sch
Title: VGA Analog
