gianlucarenzi/Vera-Module-RBL-C64/VERA-MODULE-RBL.kicad_pcb

## KiCad design VERA-MODULE-RBL.kicad_pcb (2026-11-04)

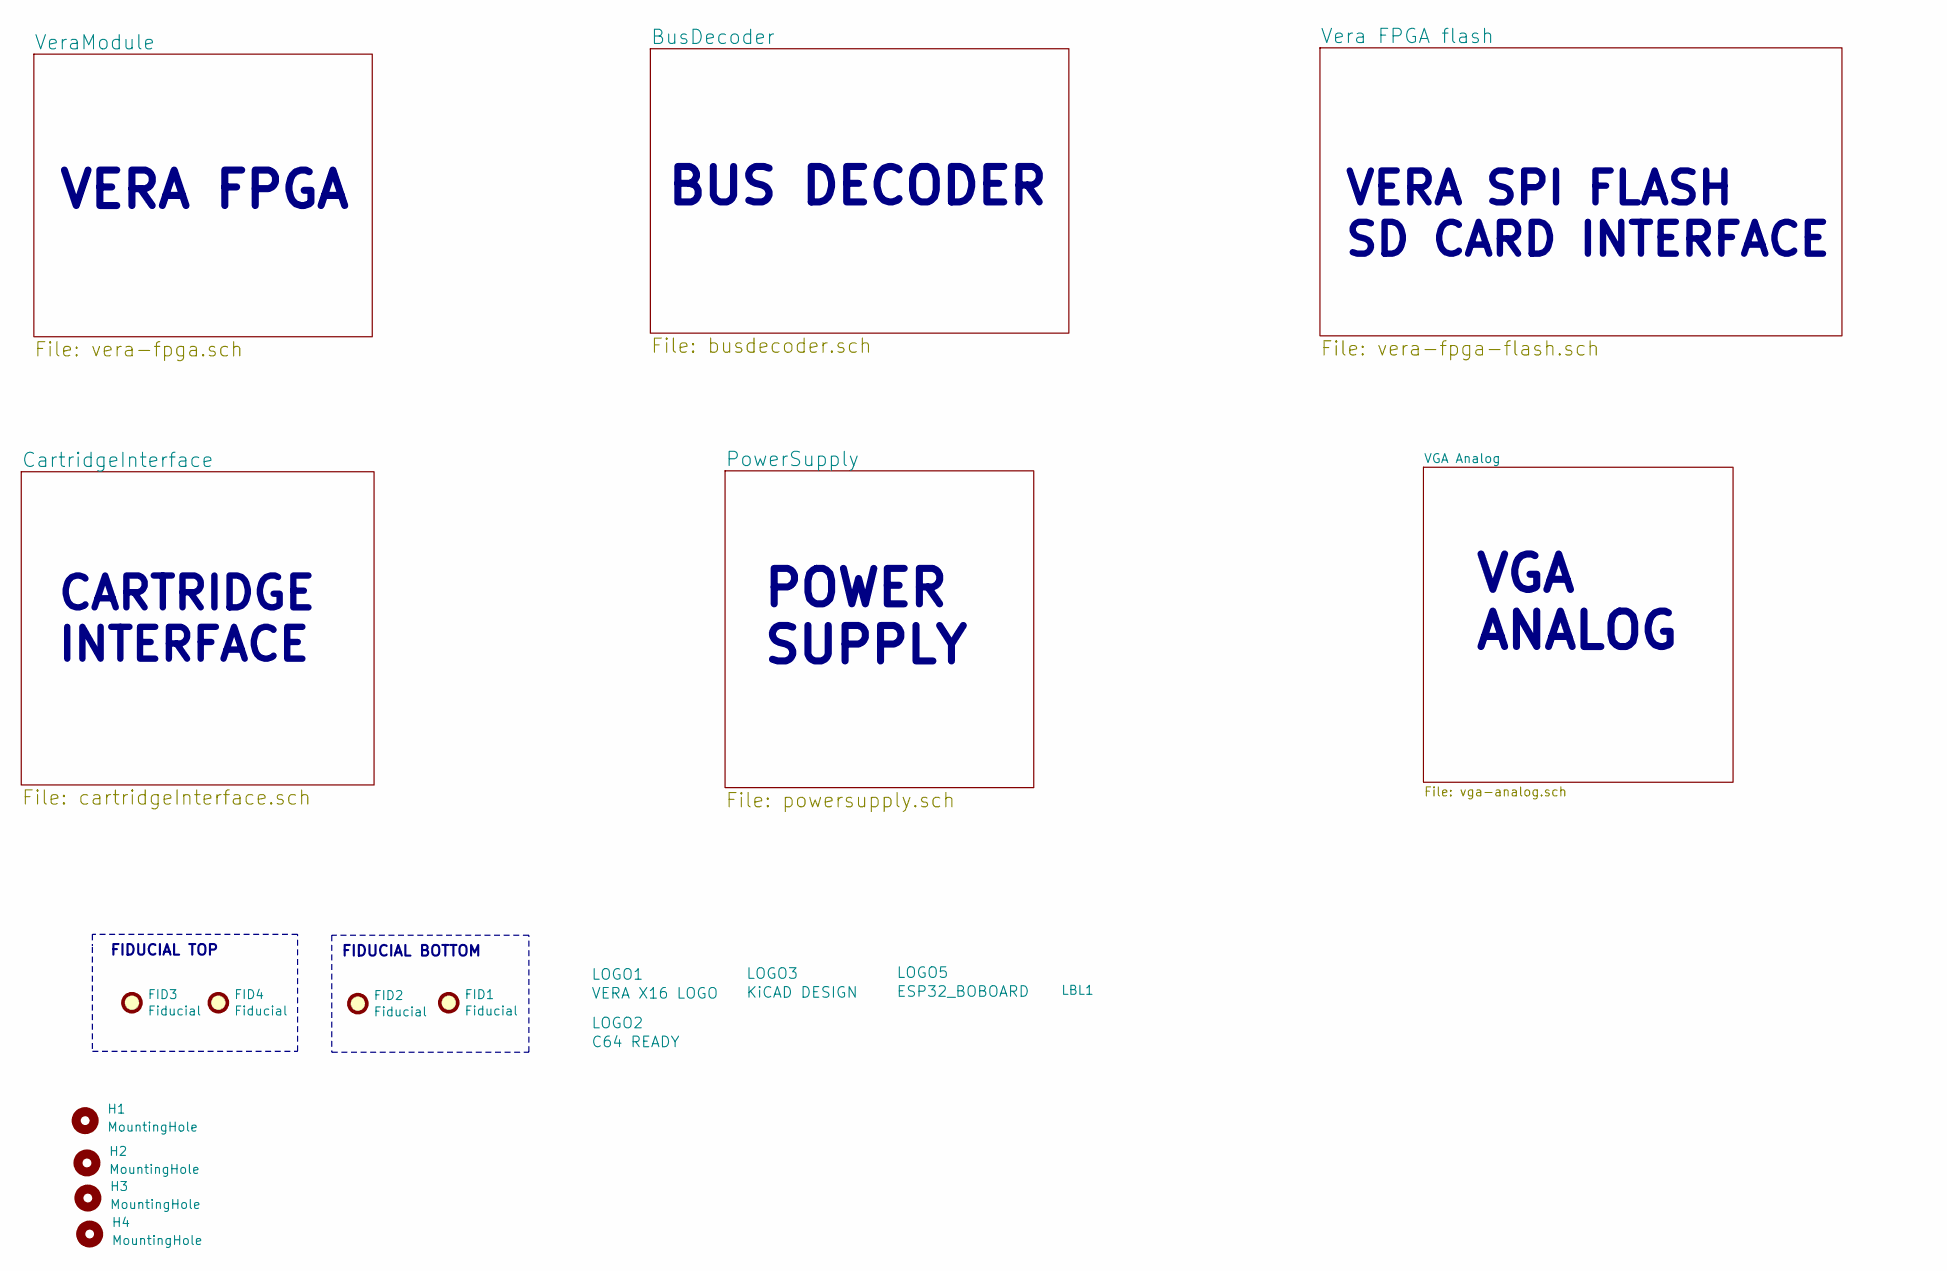
[picture p18: schematic VERA-MODULE-RBL.sch, VERA FPGA Audio & Video Board]

Parts:
FID1, FID2, FID3, FID4: Fiducial; Fiducial_0.5mm_Mask1mm
H1, H2, H3, H4: MountingHole; MountingHole_3.2mm_M3
LBL1: Label-20mmx10mm; Label-20mmx10mm-Silkscreen
LOGO1: VERA X16 LOGO; x16logo
LOGO2: C64 READY; c64_ready_8mm_REV
LOGO3: KiCAD DESIGN; KiCad-Logo2_6mm_SilkScreen
LOGO5: ESP32_BOBOARD; ESP32_BOBOARD_5V_21.7mmx21.7mm

Notes on the sheet:
VERA FPGA
BUS DECODER
CARTRIDGE INTERFACE
VERA SPI FLASH SD CARD INTERFACE
POWER SUPPLY
FIDUCIAL TOP
FIDUCIAL BOTTOM
VGA ANALOG

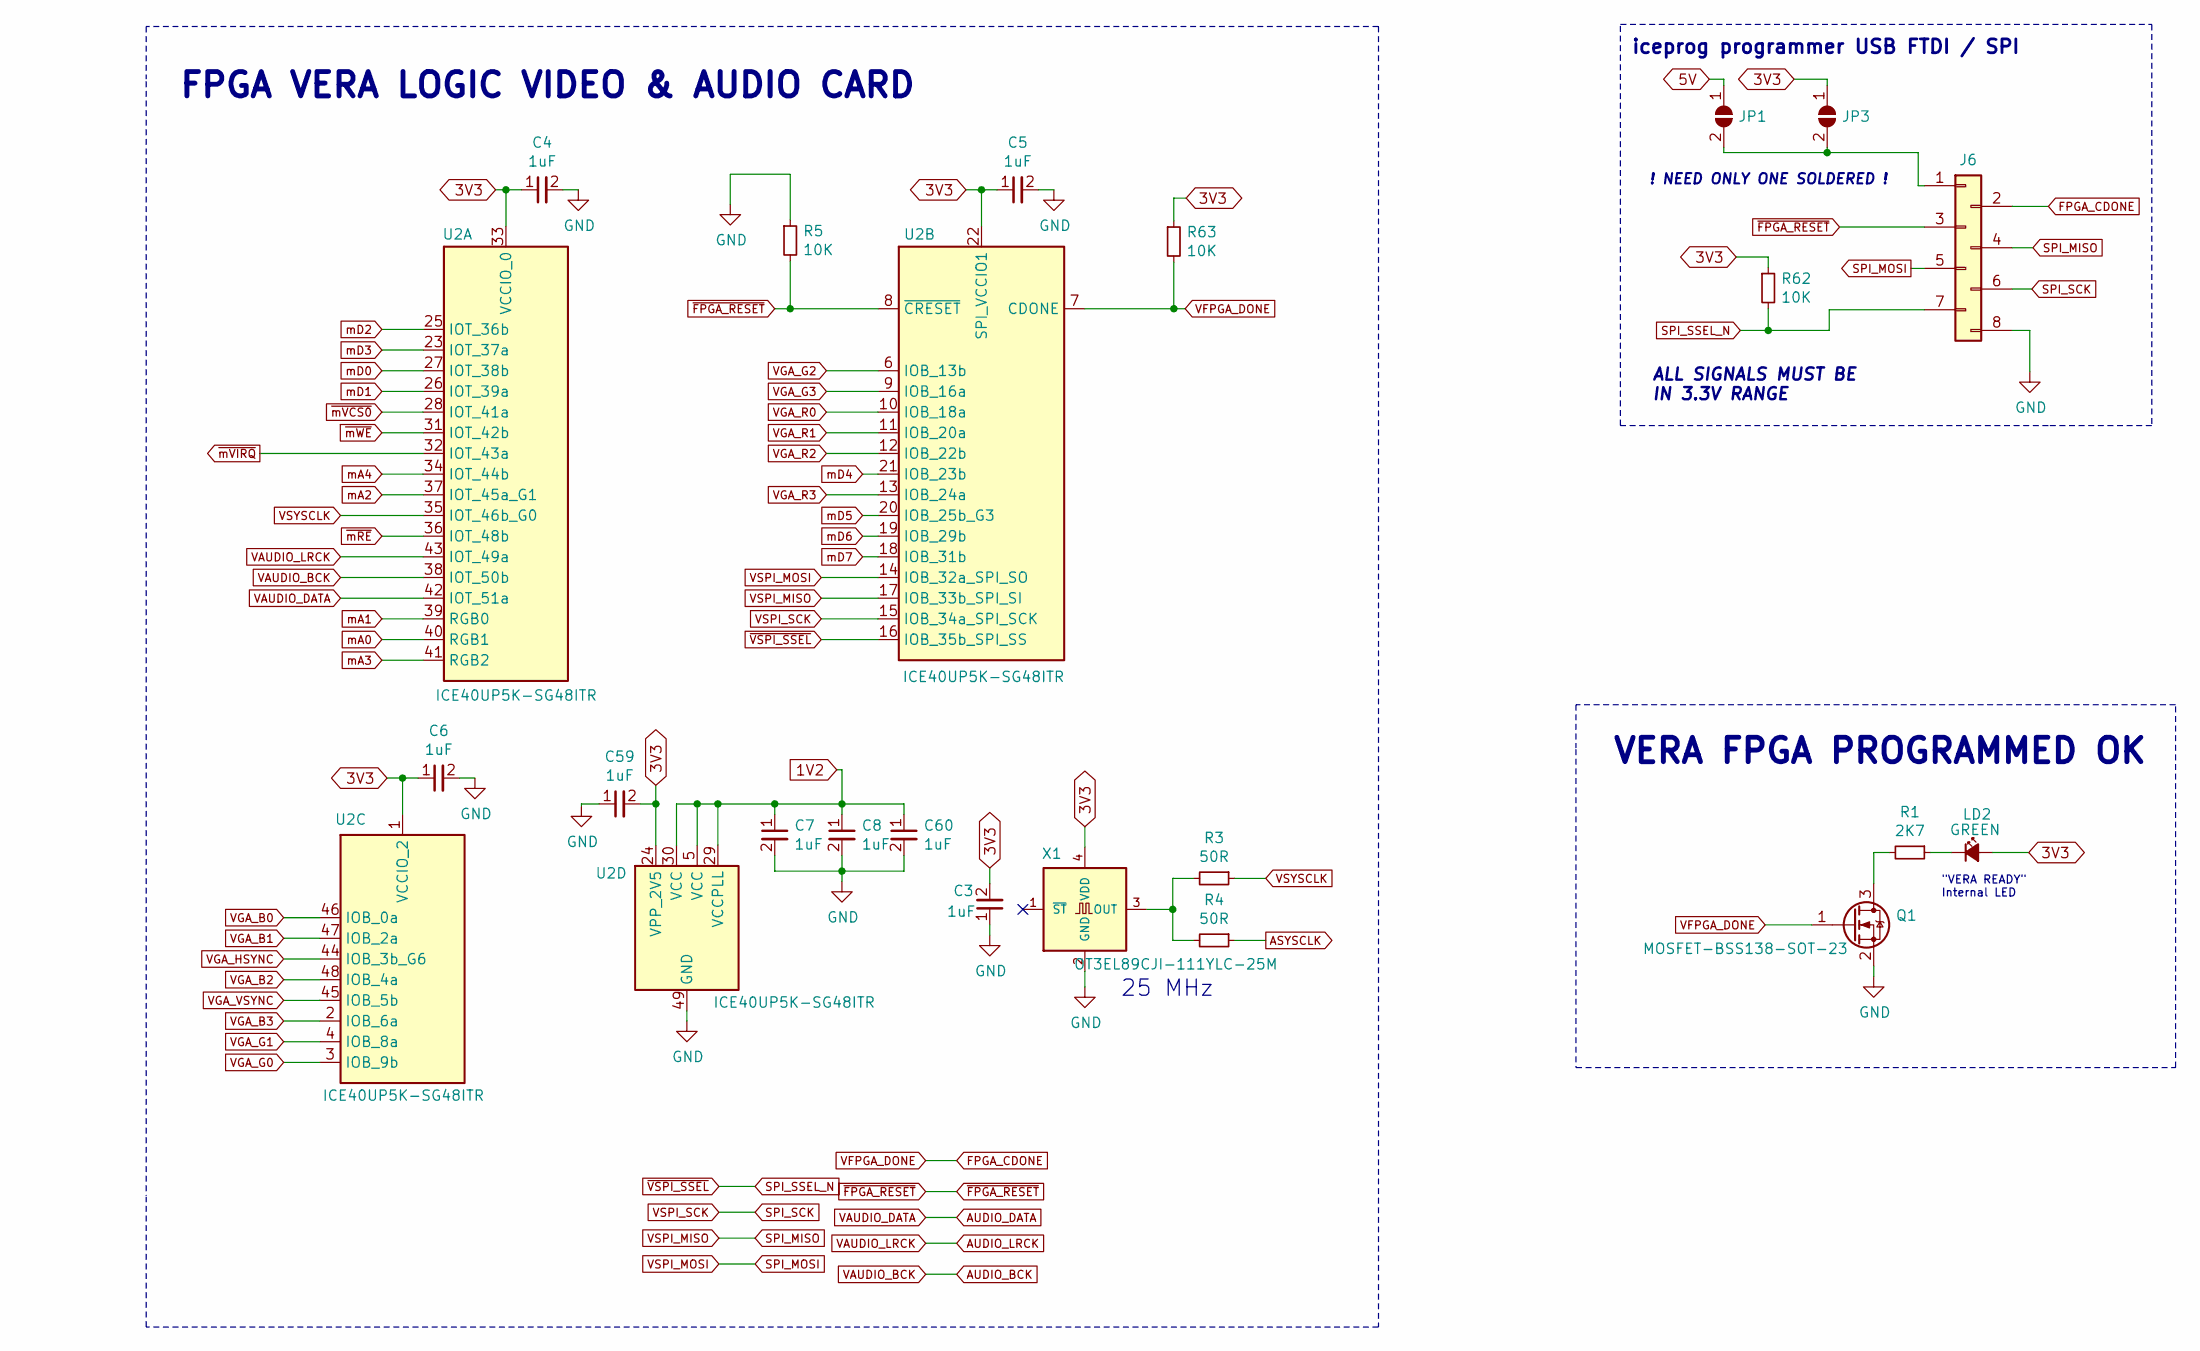
[picture p19: schematic vera-fpga.sch, VERA MODULE AND PROGRAMMING CONNECTOR]

Parts:
C3, C4, C5, C6, C7, C8, C59, C60: 1uF; C_0805_2012Metric_Pad1.18x1.45mm_HandSolder; LCSC C2798196
J6: CONN_SMD_01x08_Staggered_2.54mm; PinSocket_1x08_P2.54mm_Vertical_SMD_Pin1Right; LCSC C42380985
JP1, JP3: SolderJumper_2_Open; SolderJumper-2_P1.3mm_Open_RoundedPad1.0x1.5mm
LD2: GREEN; LED_0805_2012Metric_Pad1.15x1.40mm_HandSolder; LCSC C84260
Q1: MOSFET-BSS138-SOT-23; SOT-23; LCSC C82045
R1: 2K7; R_0805_2012Metric_Pad1.20x1.40mm_HandSolder; LCSC C313926
R3, R4: 50R; R_0805_2012Metric_Pad1.20x1.40mm_HandSolder; LCSC C2828866
R5, R62, R63: 10K; R_0805_2012Metric_Pad1.20x1.40mm_HandSolder; LCSC C84376
U2: ICE40UP5K-SG48ITR; QFN-48-1EP_7x7mm_P0.5mm_EP5.6x5.6mm; LCSC C2678152
X1: OT3EL89CJI-111YLC-25M; OSC_ECS-2033-250-BN; LCSC C7471623

Connections:
1V2: C7.1, C8.1, C60.1, U2.5 (VCC), U2.29 (VCCPLL), U2.30 (VCC); also elsewhere on the board
3V3: C3.2, C4.1, C5.1, C6.1, C59.2, JP3.1 (A), LD2.2 (A), R62.1, R63.1, U2.1 (VCCIO_2), U2.22 (SPI_VCCIO1), U2.24 (VPP_2V5), U2.33 (VCCIO_0), X1.4 (VDD); also elsewhere on the board
5V: JP1.1 (A); also elsewhere on the board
ASYSCLK: R4.1; also elsewhere on the board
AUDIO_BCK: U2.38 (IOT_50b); also elsewhere on the board
AUDIO_DATA: U2.42 (IOT_51a); also elsewhere on the board
AUDIO_LRCK: U2.43 (IOT_49a); also elsewhere on the board
FPGA_CDONE: J6.2, Q1.1 (G), R63.2, U2.7 (CDONE); also elsewhere on the board
GND: C3.1, C4.2, C5.2, C6.2, C7.2, C8.2, C59.1, C60.2, J6.8, Q1.2 (S), R5.1, U2.49 (GND), X1.2 (GND); also elsewhere on the board
unnamed: J6.1, JP1.2 (B), JP3.2 (B)
unnamed: LD2.1 (K), R1.1
unnamed: Q1.3 (D), R1.2
unnamed: R3.2, R4.2, X1.3 (OUT)
SPI_MISO: J6.4, U2.17 (IOB_33b_SPI_SI); also elsewhere on the board
SPI_MOSI: J6.5, U2.14 (IOB_32a_SPI_SO); also elsewhere on the board
SPI_SCK: J6.6, U2.15 (IOB_34a_SPI_SCK); also elsewhere on the board
SPI_SSEL_N: J6.7, R62.2, U2.16 (IOB_35b_SPI_SS); also elsewhere on the board
VGA_B0: U2.46 (IOB_0a); also elsewhere on the board
VGA_B1: U2.47 (IOB_2a); also elsewhere on the board
VGA_B2: U2.48 (IOB_4a); also elsewhere on the board
VGA_B3: U2.2 (IOB_6a); also elsewhere on the board
VGA_G0: U2.3 (IOB_9b); also elsewhere on the board
VGA_G1: U2.4 (IOB_8a); also elsewhere on the board
VGA_G2: U2.6 (IOB_13b); also elsewhere on the board
VGA_G3: U2.9 (IOB_16a); also elsewhere on the board
VGA_HSYNC: U2.44 (IOB_3b_G6); also elsewhere on the board
VGA_R0: U2.10 (IOB_18a); also elsewhere on the board
VGA_R1: U2.11 (IOB_20a); also elsewhere on the board
VGA_R2: U2.12 (IOB_22b); also elsewhere on the board
VGA_R3: U2.13 (IOB_24a); also elsewhere on the board
VGA_VSYNC: U2.45 (IOB_5b); also elsewhere on the board
VSYSCLK: R3.1, U2.35 (IOT_46b_G0)
mA0: U2.40 (RGB1); also elsewhere on the board
mA1: U2.39 (RGB0); also elsewhere on the board
mA2: U2.37 (IOT_45a_G1); also elsewhere on the board
mA3: U2.41 (RGB2); also elsewhere on the board
mA4: U2.34 (IOT_44b); also elsewhere on the board
mD0: U2.27 (IOT_38b); also elsewhere on the board
mD1: U2.26 (IOT_39a); also elsewhere on the board
mD2: U2.25 (IOT_36b); also elsewhere on the board
mD3: U2.23 (IOT_37a); also elsewhere on the board
mD4: U2.21 (IOB_23b); also elsewhere on the board
mD5: U2.20 (IOB_25b_G3); also elsewhere on the board
mD6: U2.19 (IOB_29b); also elsewhere on the board
mD7: U2.18 (IOB_31b); also elsewhere on the board
~FPGA_RESET: J6.3, R5.2, U2.8 (~CRESET); also elsewhere on the board
~mRE: U2.36 (IOT_48b); also elsewhere on the board
~mVCS0: U2.28 (IOT_41a); also elsewhere on the board
~mVIRQ: U2.32 (IOT_43a); also elsewhere on the board
~mWE: U2.31 (IOT_42b); also elsewhere on the board

Notes on the sheet:
"VERA READY" Internal LED
25 MHz
FPGA VERA LOGIC VIDEO & AUDIO CARD
VERA FPGA PROGRAMMED OK
iceprog programmer USB FTDI / SPI
ALL SIGNALS MUST BE IN 3.3V RANGE
! NEED ONLY ONE SOLDERED !

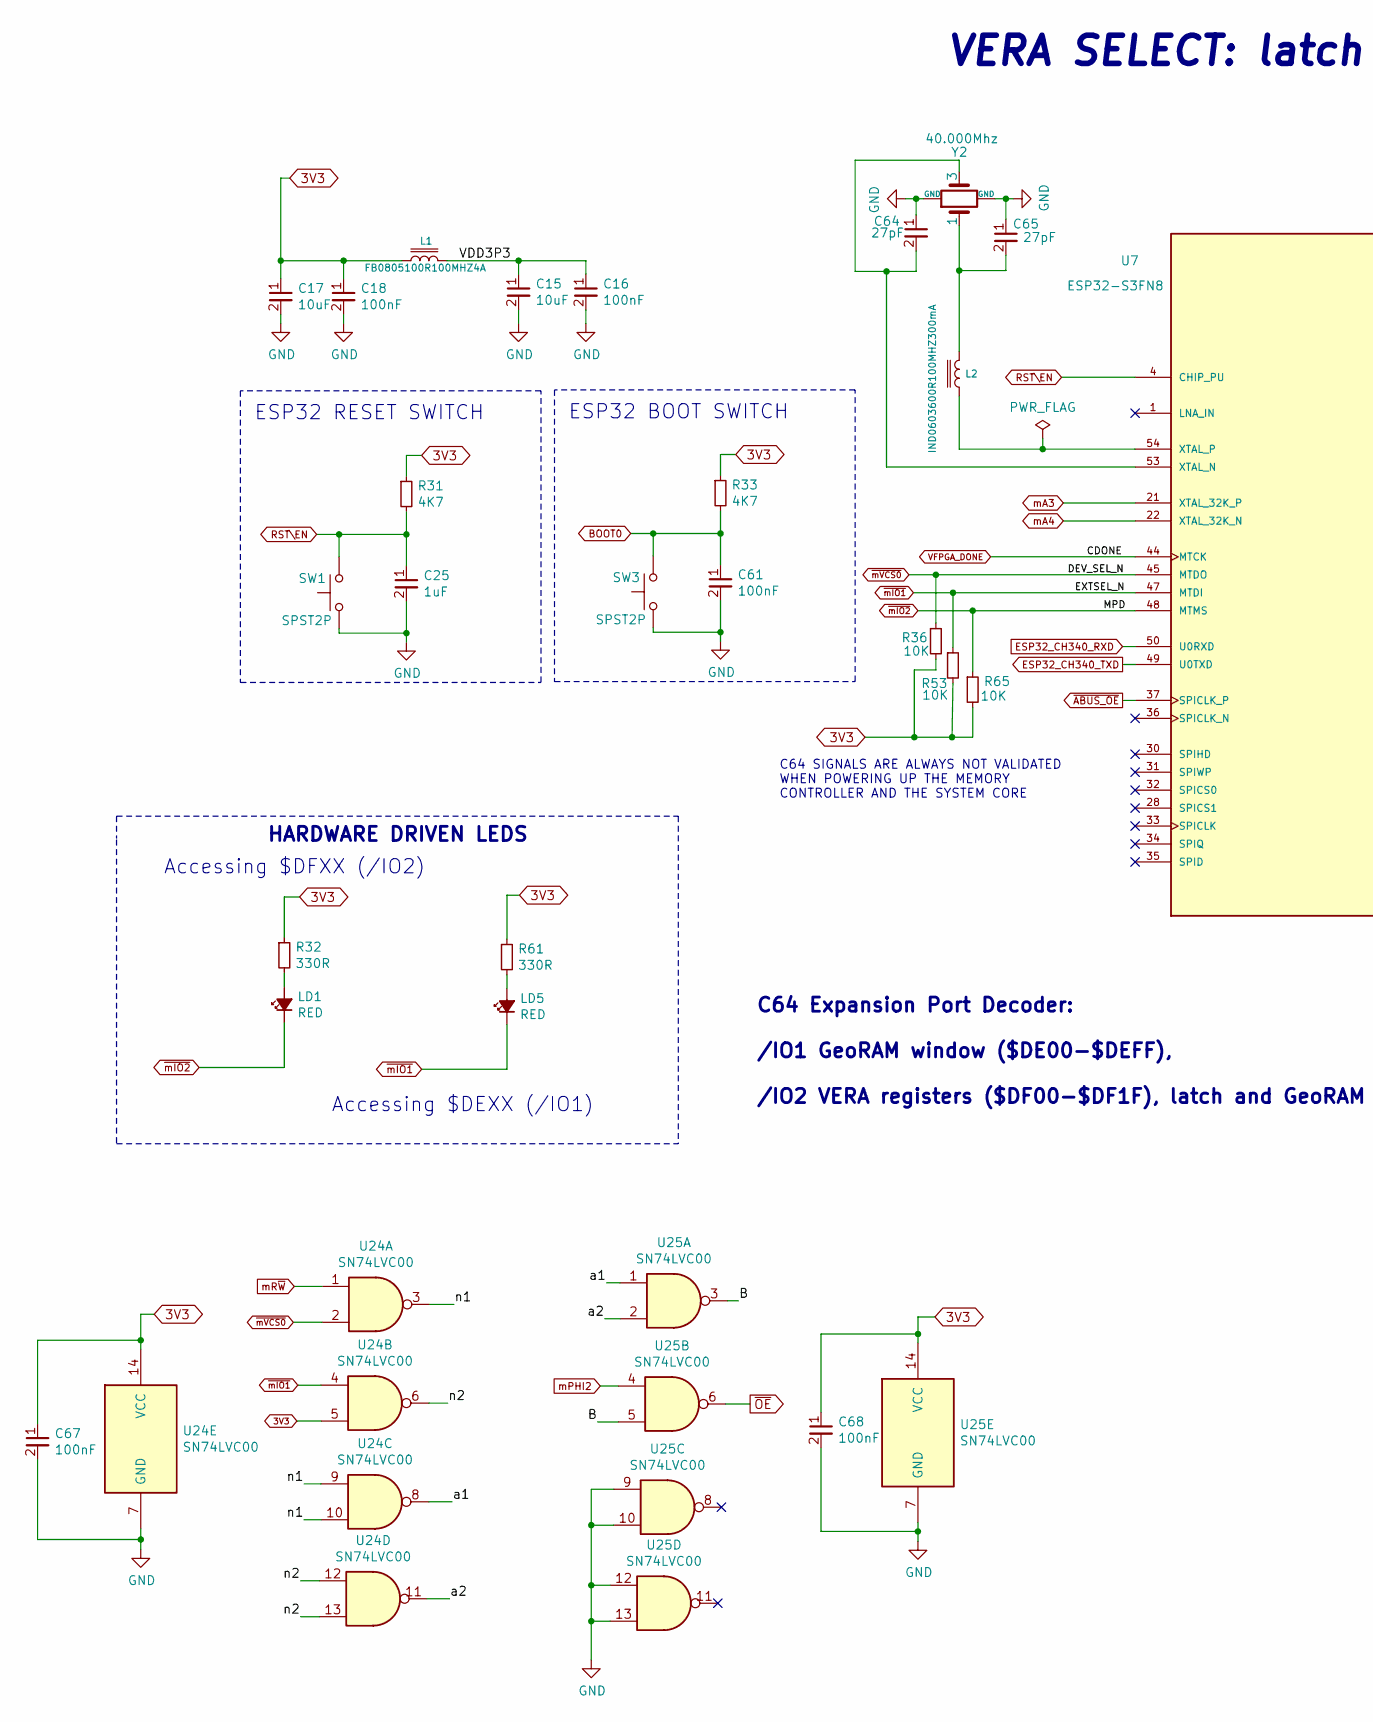
[picture p20: schematic busdecoder.sch, BUS DECODER, part in row 1, column 1]

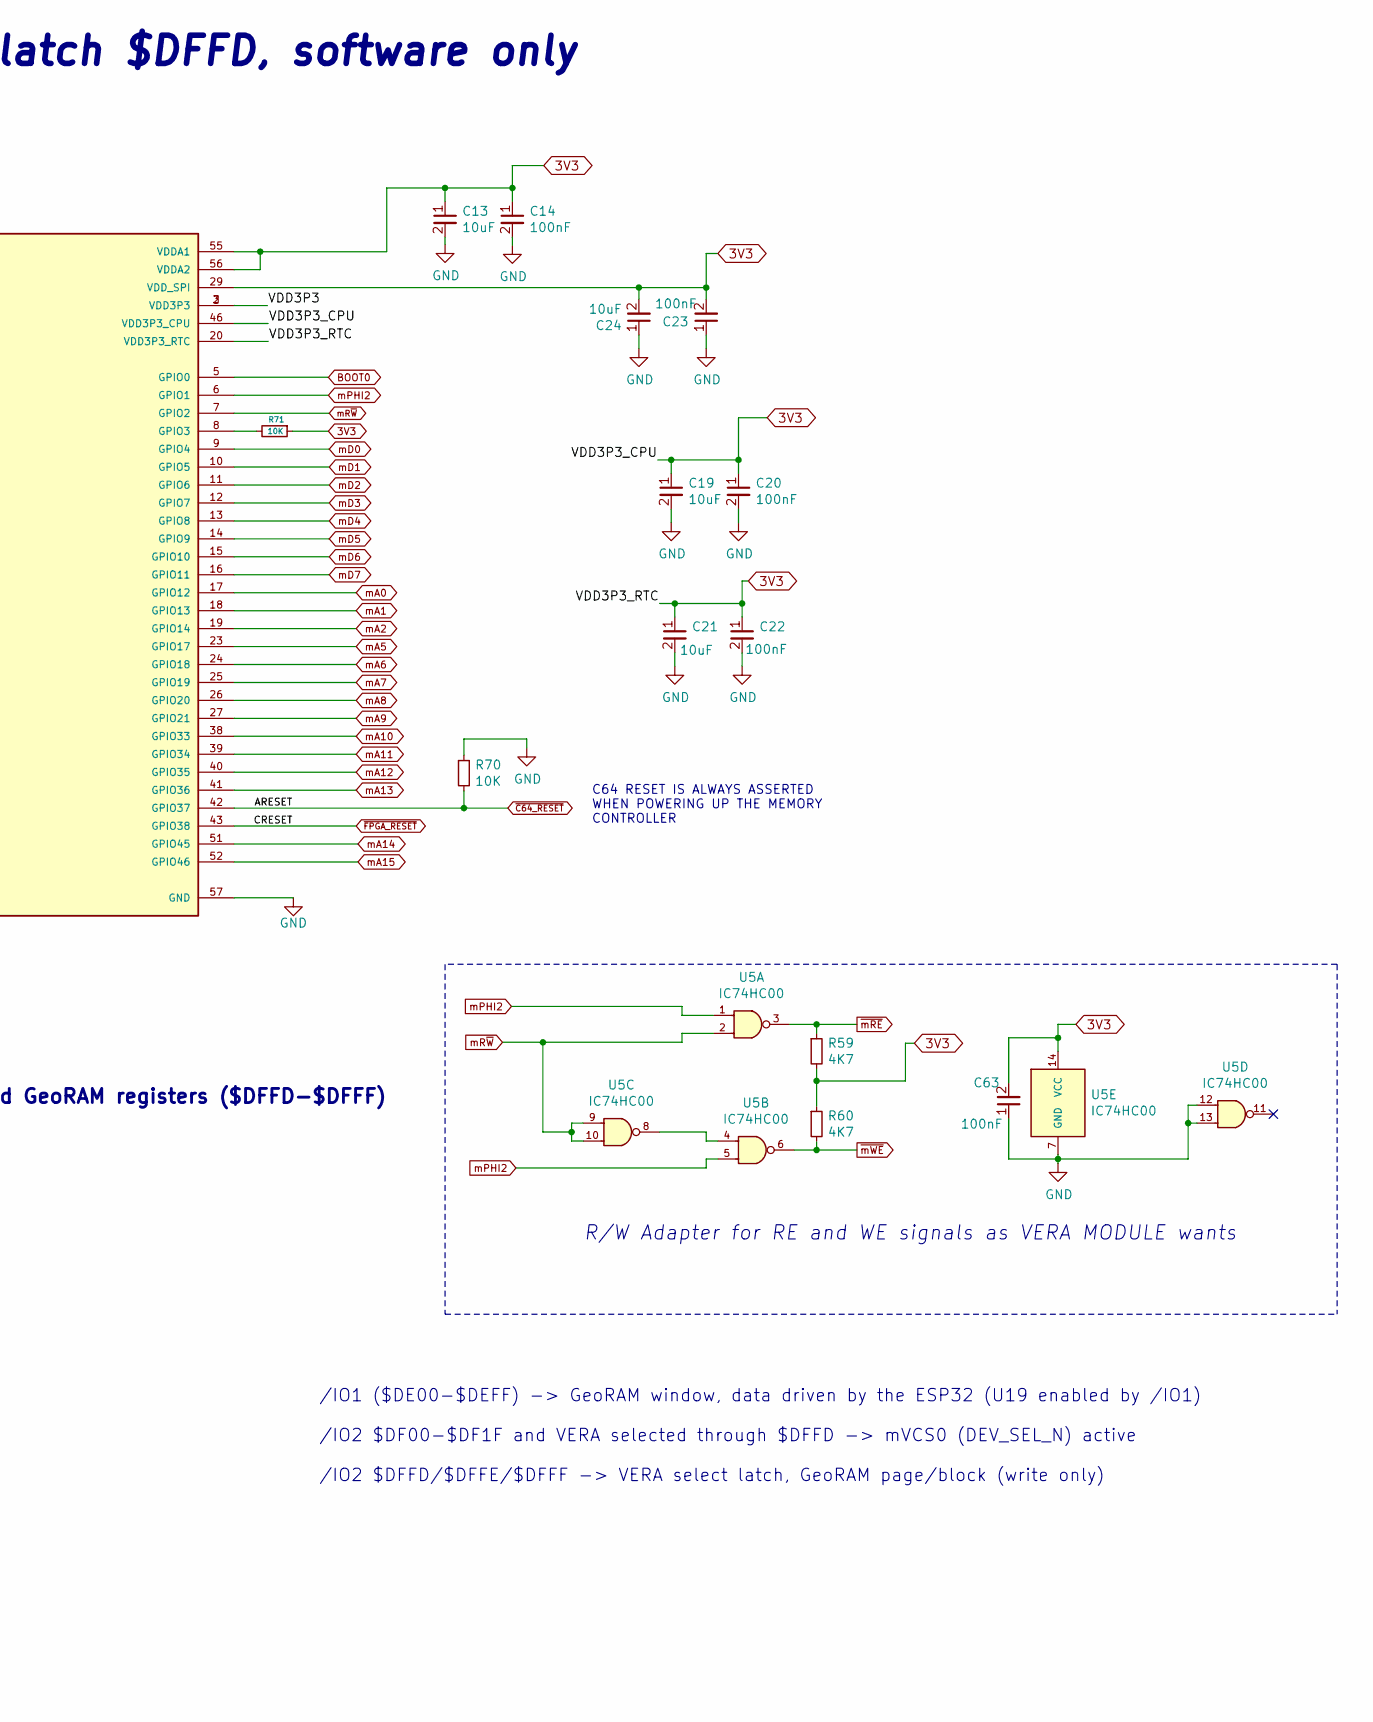
[picture p21: schematic busdecoder.sch, BUS DECODER, part in row 1, column 2]

Parts:
C13, C15, C17, C19, C21, C24: 10uF; C_0805_2012Metric_Pad1.18x1.45mm_HandSolder; LCSC C440198
C14, C16, C18, C20, C22, C23, C61, C63, C67, C68: 100nF; C_0805_2012Metric_Pad1.18x1.45mm_HandSolder; LCSC C840116
C25: 1uF; C_0805_2012Metric_Pad1.18x1.45mm_HandSolder; LCSC C2798196
C64, C65: 27pF; C_0805_2012Metric_Pad1.18x1.45mm_HandSolder; LCSC C1808
L1: FB0805100R100MHZ4A; L_0805_2012Metric_Pad1.15x1.40mm_HandSolder; LCSC C15957
L2: IND0603600R100MHZ300mA; L_0603_1608Metric_Pad1.05x0.95mm_HandSolder; LCSC C139271
LD1, LD5: RED; LED_1206_3216Metric_Pad1.42x1.75mm_HandSolder; LCSC C965822
R31, R33, R59, R60: 4K7; R_0805_2012Metric_Pad1.20x1.40mm_HandSolder; LCSC C17673
R32, R61: 330R; R_0805_2012Metric_Pad1.20x1.40mm_HandSolder; LCSC C313892
R36, R53, R65, R70, R71: 10K; R_0805_2012Metric_Pad1.20x1.40mm_HandSolder; LCSC C84376
SW1, SW3: SPST2P; SPST-7.3x3.9x2.5-WUERTH-434121025816; LCSC C318911
U5: IC74HC00; SOIC-14_3.9x8.7mm_P1.27mm; LCSC C5586
U7: ESP32-S3FN8; IC_ESP32-S3FN8-QFN40P700X700X90-57N; Manufacturer PN ESP32-S3FN8; LCSC C2913196
U24, U25: SN74LVC00; TSSOP-14_4.4x5mm_P0.65mm; LCSC C7803
Y2: 40.000Mhz; Crystal_SMD_2520-4Pin_2.5x2.0mm; LCSC C284176

Connections:
3V3: C13.1, C14.1, C17.1, C18.1, C19.1, C20.1, C21.1, C22.1, C23.2, C24.2, C63.2, C67.1, C68.1, L1.1, R31.1, R32.1, R33.1, R36.2, R53.2, R59.2, R60.1, R61.1, R65.2, R71.1, U5.14 (VCC), U7.20 (VDD3P3_RTC), U7.29 (VDD_SPI), U7.46 (VDD3P3_CPU), U7.55 (VDDA1), U7.56 (VDDA2), U24.5, U24.14 (VCC), U25.14 (VCC); also elsewhere on the board
/BusDecoder/B: U25.3, U25.5
/BusDecoder/VDD3P3: C15.1, C16.1, L1.2, U7.2 (VDD3P3), U7.3 (VDD3P3)
/BusDecoder/a1: U24.8, U25.1
/BusDecoder/a2: U24.11, U25.2
/BusDecoder/n1: U24.3, U24.9, U24.10
/BusDecoder/n2: U24.6, U24.12, U24.13
BOOT0: C61.1, R33.2, SW3.2, U7.5 (GPIO0); also elsewhere on the board
ESP32_CH340_RXD: U7.50 (U0RXD); also elsewhere on the board
ESP32_CH340_TXD: U7.49 (U0TXD); also elsewhere on the board
FPGA_CDONE: U7.44 (MTCK); also elsewhere on the board
GND: C13.2, C14.2, C15.2, C16.2, C17.2, C18.2, C19.2, C20.2, C21.2, C22.2, C23.1, C24.1, C25.2, C61.2, C63.1, C64.1, C65.1, C67.2, C68.2, R70.1, SW1.1, SW3.1, U5.7 (GND), U5.12 (4A), U5.13 (4B), U7.57 (GND), U24.7 (GND), U25.7 (GND), U25.9, U25.10, U25.12, U25.13, Y2.2 (GND), Y2.4 (GND); also elsewhere on the board
unnamed: C64.2, U7.53 (XTAL_N), Y2.3
unnamed: C65.2, L2.2, Y2.1
unnamed: L2.1, U7.54 (XTAL_P)
unnamed: LD1.2 (A), R32.2
unnamed: LD5.2 (A), R61.2
unnamed: R71.2, U7.8 (GPIO3)
unnamed: U5.4 (4A), U5.8 (4Y)
RST\EN: C25.1, R31.2, SW1.2, U7.4 (CHIP_PU); also elsewhere on the board
mA0: U7.17 (GPIO12); also elsewhere on the board
mA1: U7.18 (GPIO13); also elsewhere on the board
mA2: U7.19 (GPIO14); also elsewhere on the board
mA3: U7.21 (XTAL_32K_P); also elsewhere on the board
mA4: U7.22 (XTAL_32K_N); also elsewhere on the board
mA5: U7.23 (GPIO17); also elsewhere on the board
mA6: U7.24 (GPIO18); also elsewhere on the board
mA7: U7.25 (GPIO19); also elsewhere on the board
mA8: U7.26 (GPIO20); also elsewhere on the board
mA9: U7.27 (GPIO21); also elsewhere on the board
mA10: U7.38 (GPIO33); also elsewhere on the board
mA11: U7.39 (GPIO34); also elsewhere on the board
mA12: U7.40 (GPIO35); also elsewhere on the board
mA13: U7.41 (GPIO36); also elsewhere on the board
mA14: U7.51 (GPIO45); also elsewhere on the board
mA15: U7.52 (GPIO46); also elsewhere on the board
mD0: U7.9 (GPIO4); also elsewhere on the board
mD1: U7.10 (GPIO5); also elsewhere on the board
mD2: U7.11 (GPIO6); also elsewhere on the board
mD3: U7.12 (GPIO7); also elsewhere on the board
mD4: U7.13 (GPIO8); also elsewhere on the board
mD5: U7.14 (GPIO9); also elsewhere on the board
mD6: U7.15 (GPIO10); also elsewhere on the board
mD7: U7.16 (GPIO11); also elsewhere on the board
mPHI2: U5.1 (4A), U5.5 (4B), U7.6 (GPIO1), U25.4; also elsewhere on the board
mR~W: U5.2 (4B), U5.9 (4A), U5.10 (4B), U7.7 (GPIO2), U24.1; also elsewhere on the board
~ABUS_OE: U7.37 (SPICLK_P); also elsewhere on the board
~C64_RESET: R70.2, U7.42 (GPIO37); also elsewhere on the board
~FPGA_RESET: U7.43 (GPIO38); also elsewhere on the board
~OE: U25.6; also elsewhere on the board
~mIO1: LD5.1 (K), R53.1, U7.47 (MTDI), U24.4; also elsewhere on the board
~mIO2: LD1.1 (K), R65.1, U7.48 (MTMS); also elsewhere on the board
~mRE: R59.1, U5.3 (4Y); also elsewhere on the board
~mVCS0: R36.1, U7.45 (MTDO), U24.2; also elsewhere on the board
~mWE: R60.2, U5.6 (4Y); also elsewhere on the board

Notes on the sheet:
R/W Adapter for RE and WE signals as VERA MODULE wants
/IO1 ($DE00-$DEFF) -> GeoRAM window, data driven by the ESP32 (U19 enabled by /IO1) /IO2 $DF00-$DF1F and VERA selected through $DFFD -> mVCS0 (DEV_SEL_N) active /IO2 $DFFD/$DFFE/$DFFF -> VERA select latch, GeoRAM page/block (write only)
VERA SELECT: latch $DFFD, software only
Accessing $DFXX (/IO2)
ESP32 RESET SWITCH
C64 Expansion Port Decoder: /IO1 GeoRAM window ($DE00-$DEFF), /IO2 VERA registers ($DF00-$DF1F), latch and GeoRAM registers ($DFFD-$DFFF)
Accessing $DEXX (/IO1)
HARDWARE DRIVEN LEDS
ESP32 BOOT SWITCH
C64 RESET IS ALWAYS ASSERTED WHEN POWERING UP THE MEMORY CONTROLLER
C64 SIGNALS ARE ALWAYS NOT VALIDATED WHEN POWERING UP THE MEMORY CONTROLLER AND THE SYSTEM CORE
