gianlucarenzi/Vera-Module-RBL-C64/VERA-MODULE-RBL.kicad_pcb

## KiCad design VERA-MODULE-RBL.kicad_pcb (continued)

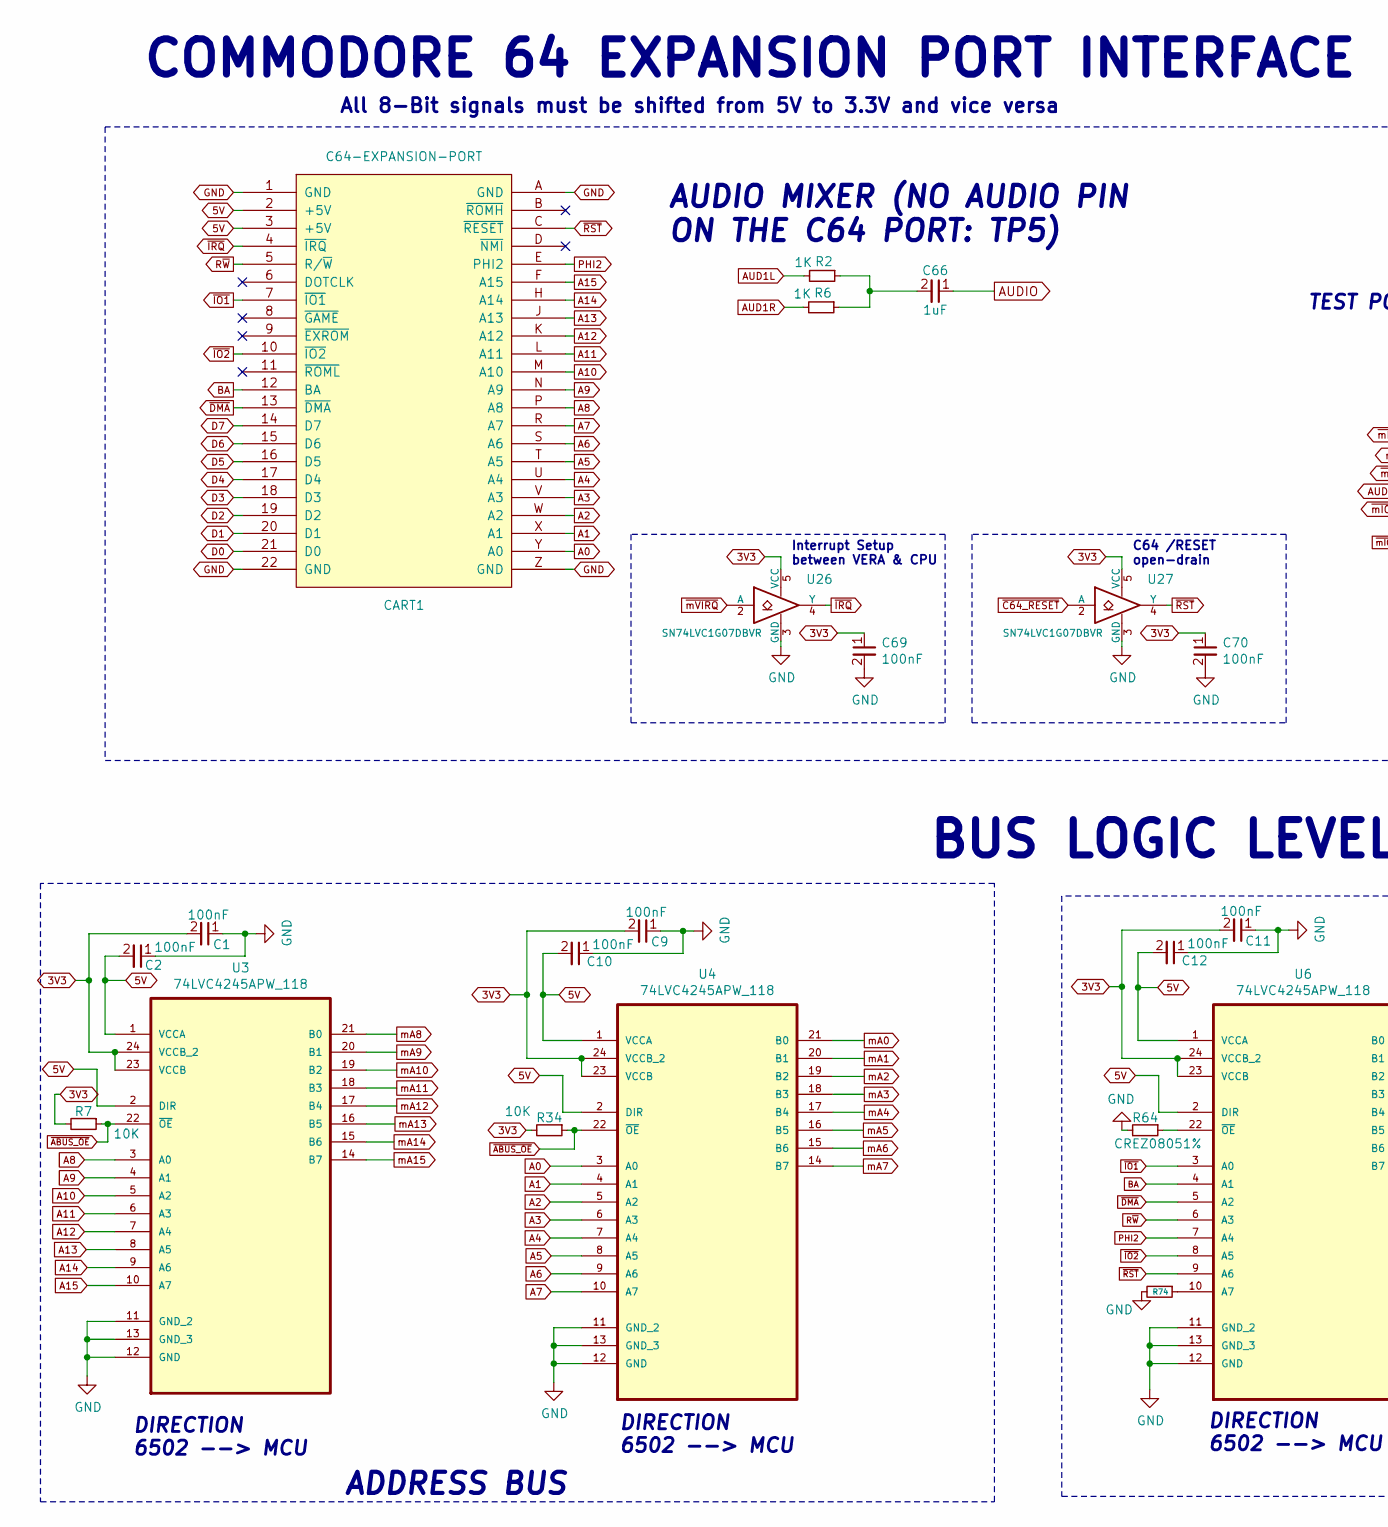
[picture p22: schematic cartridgeInterface.sch, C64 EXPANSION PORT INTERFACE AND BUS LEVEL SHIFTERS, part in row 1, column 1]

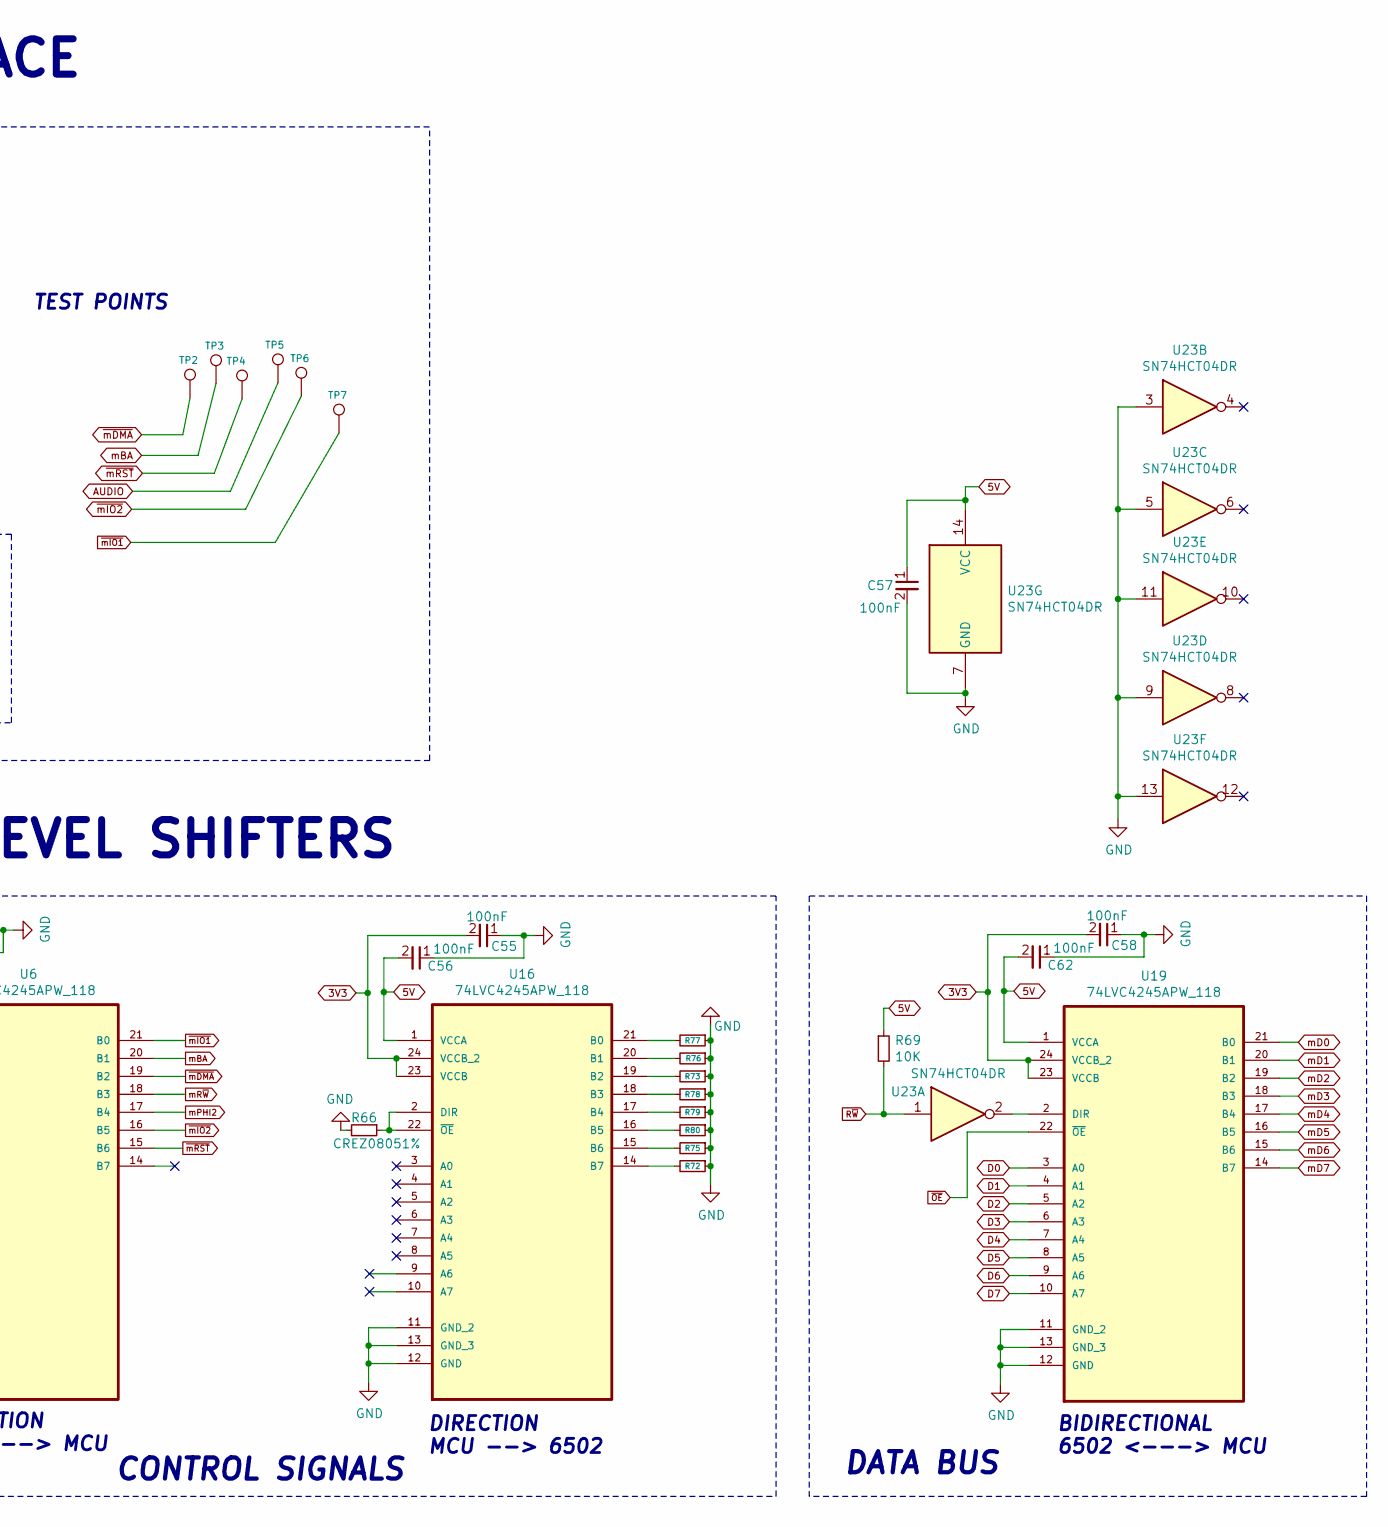
[picture p23: schematic cartridgeInterface.sch, C64 EXPANSION PORT INTERFACE AND BUS LEVEL SHIFTERS, part in row 1, column 2]

Parts:
C1, C2, C9, C10, C11, C12, C55, C56, C57, C58, C62, C69, C70: 100nF; C_0805_2012Metric_Pad1.18x1.45mm_HandSolder; LCSC C840116
C66: 1uF; C_0805_2012Metric_Pad1.18x1.45mm_HandSolder; LCSC C2798196
CART1: C64-EXPANSION-PORT; C64-EXPANSION-CARTRIDGE
R2, R6: 1K; R_0805_2012Metric_Pad1.20x1.40mm_HandSolder; LCSC C17513
R7, R34, R69: 10K; R_0805_2012Metric_Pad1.20x1.40mm_HandSolder; LCSC C84376
R64, R66, R72, R73, R74, R75, R76, R77, R78, R79, R80: CREZ08051%; R_0805_2012Metric_Pad1.20x1.40mm_HandSolder; LCSC C328378
TP2, TP3, TP4, TP5, TP6, TP7: TestPoint; TestPoint_Pad_D2.0mm
U3, U4, U6, U16, U19: 74LVC4245APW_118; IC_74LVC4245_SOP65P640X110-24N; LCSC C6091
U23: SN74HCT04DR; SOIC-14_3.9x8.7mm_P1.27mm; LCSC C6766
U26, U27: SN74LVC1G07DBVR; SOT-23-5; LCSC C7829

Connections:
3V3: C1.2, C9.2, C11.2, C55.2, C58.2, C69.1, C70.1, R7.2, R34.2, U3.23 (VCCB), U3.24 (VCCB_2), U4.23 (VCCB), U4.24 (VCCB_2), U6.23 (VCCB), U6.24 (VCCB_2), U16.23 (VCCB), U16.24 (VCCB_2), U19.23 (VCCB), U19.24 (VCCB_2), U26.5 (VCC), U27.5 (VCC); also elsewhere on the board
5V: C2.2, C10.2, C12.2, C56.2, C57.1, C62.2, CART1.2 (+5V), CART1.3 (+5V), R69.1, U3.1 (VCCA), U3.2 (DIR), U4.1 (VCCA), U4.2 (DIR), U6.1 (VCCA), U6.2 (DIR), U16.1 (VCCA), U19.1 (VCCA), U23.14 (VCC); also elsewhere on the board
A0: CART1.Y (A0), U4.3 (A0)
A1: CART1.X (A1), U4.4 (A1)
A2: CART1.W (A2), U4.5 (A2)
A3: CART1.V (A3), U4.6 (A3)
A4: CART1.U (A4), U4.7 (A4)
A5: CART1.T (A5), U4.8 (A5)
A6: CART1.S (A6), U4.9 (A6)
A7: CART1.R (A7), U4.10 (A7)
A8: CART1.P (A8), U3.3 (A0)
A9: CART1.N (A9), U3.4 (A1)
A10: CART1.M (A10), U3.5 (A2)
A11: CART1.L (A11), U3.6 (A3)
A12: CART1.K (A12), U3.7 (A4)
A13: CART1.J (A13), U3.8 (A5)
A14: CART1.H (A14), U3.9 (A6)
A15: CART1.F (A15), U3.10 (A7)
AUD1L: R2.2; also elsewhere on the board
AUD1R: R6.2; also elsewhere on the board
AUDIO: C66.1, TP5.1
BA: CART1.12 (BA), U6.4 (A1)
D0: CART1.21 (D0), U19.3 (A0)
D1: CART1.20 (D1), U19.4 (A1)
D2: CART1.19 (D2), U19.5 (A2)
D3: CART1.18 (D3), U19.6 (A3)
D4: CART1.17 (D4), U19.7 (A4)
D5: CART1.16 (D5), U19.8 (A5)
D6: CART1.15 (D6), U19.9 (A6)
D7: CART1.14 (D7), U19.10 (A7)
GND: C1.1, C2.1, C9.1, C10.1, C11.1, C12.1, C55.1, C56.1, C57.2, C58.1, C62.1, C69.2, C70.2, CART1.1 (GND), CART1.22 (GND), CART1.A (GND), CART1.Z (GND), R64.2, R66.2, R72.1, R73.1, R74.2, R75.1, R76.1, R77.1, R78.1, R79.1, R80.1, U3.11 (GND_2), U3.12 (GND), U3.13 (GND_3), U4.11 (GND_2), U4.12 (GND), U4.13 (GND_3), U6.11 (GND_2), U6.12 (GND), U6.13 (GND_3), U16.11 (GND_2), U16.12 (GND), U16.13 (GND_3), U19.11 (GND_2), U19.12 (GND), U19.13 (GND_3), U23.3, U23.5, U23.7 (GND), U23.9, U23.11, U23.13, U26.3 (GND), U27.3 (GND); also elsewhere on the board
unnamed: C66.2, R2.1, R6.1
unnamed: R64.1, U6.22 (~OE)
unnamed: R66.1, U16.2 (DIR), U16.22 (~OE)
unnamed: R72.2, U16.14 (B7)
unnamed: R73.2, U16.19 (B2)
unnamed: R74.1, U6.10 (A7)
unnamed: R75.2, U16.15 (B6)
unnamed: R76.2, U16.20 (B1)
unnamed: R77.2, U16.21 (B0)
unnamed: R78.2, U16.18 (B3)
unnamed: R79.2, U16.17 (B4)
unnamed: R80.2, U16.16 (B5)
unnamed: U19.2 (DIR), U23.2
PHI2: CART1.E (PHI2), U6.7 (A4)
R~W: CART1.5 (R/~W), R69.2, U6.6 (A3), U23.1
mA0: U4.21 (B0); also elsewhere on the board
mA1: U4.20 (B1); also elsewhere on the board
mA2: U4.19 (B2); also elsewhere on the board
mA3: U4.18 (B3); also elsewhere on the board
mA4: U4.17 (B4); also elsewhere on the board
mA5: U4.16 (B5); also elsewhere on the board
mA6: U4.15 (B6); also elsewhere on the board
mA7: U4.14 (B7); also elsewhere on the board
mA8: U3.21 (B0); also elsewhere on the board
mA9: U3.20 (B1); also elsewhere on the board
mA10: U3.19 (B2); also elsewhere on the board
mA11: U3.18 (B3); also elsewhere on the board
mA12: U3.17 (B4); also elsewhere on the board
mA13: U3.16 (B5); also elsewhere on the board
mA14: U3.15 (B6); also elsewhere on the board
mA15: U3.14 (B7); also elsewhere on the board
mBA: TP3.1, U6.20 (B1)
mD0: U19.21 (B0); also elsewhere on the board
mD1: U19.20 (B1); also elsewhere on the board
mD2: U19.19 (B2); also elsewhere on the board
mD3: U19.18 (B3); also elsewhere on the board
mD4: U19.17 (B4); also elsewhere on the board
mD5: U19.16 (B5); also elsewhere on the board
mD6: U19.15 (B6); also elsewhere on the board
mD7: U19.14 (B7); also elsewhere on the board
mPHI2: U6.17 (B4); also elsewhere on the board
mR~W: U6.18 (B3); also elsewhere on the board
~ABUS_OE: R7.1, R34.1, U3.22 (~OE), U4.22 (~OE); also elsewhere on the board
~C64_RESET: U27.2 (A); also elsewhere on the board
~DMA: CART1.13 (~DMA), U6.5 (A2)
~IO1: CART1.7 (~IO1), U6.3 (A0)
~IO2: CART1.10 (~IO2), U6.8 (A5)
~IRQ: CART1.4 (~IRQ), U26.4 (Y)
~OE: U19.22 (~OE); also elsewhere on the board
~RST: CART1.C (~RESET), U6.9 (A6), U27.4 (Y)
~mDMA: TP2.1, U6.19 (B2)
~mIO1: TP7.1, U6.21 (B0); also elsewhere on the board
~mIO2: TP6.1, U6.16 (B5); also elsewhere on the board
~mRST: TP4.1, U6.15 (B6)
~mVIRQ: U26.2 (A); also elsewhere on the board

Notes on the sheet:
COMMODORE 64 EXPANSION PORT INTERFACE
All 8-Bit signals must be shifted from 5V to 3.3V and vice versa
TEST POINTS
BUS LOGIC LEVEL SHIFTERS
DIRECTION 6502 --> MCU
DIRECTION MCU --> 6502
BIDIRECTIONAL 6502 <---> MCU
CONTROL SIGNALS
ADDRESS BUS
DATA BUS
Interrupt Setup between VERA & CPU
C64 /RESET open-drain
AUDIO MIXER (NO AUDIO PIN ON THE C64 PORT: TP5)

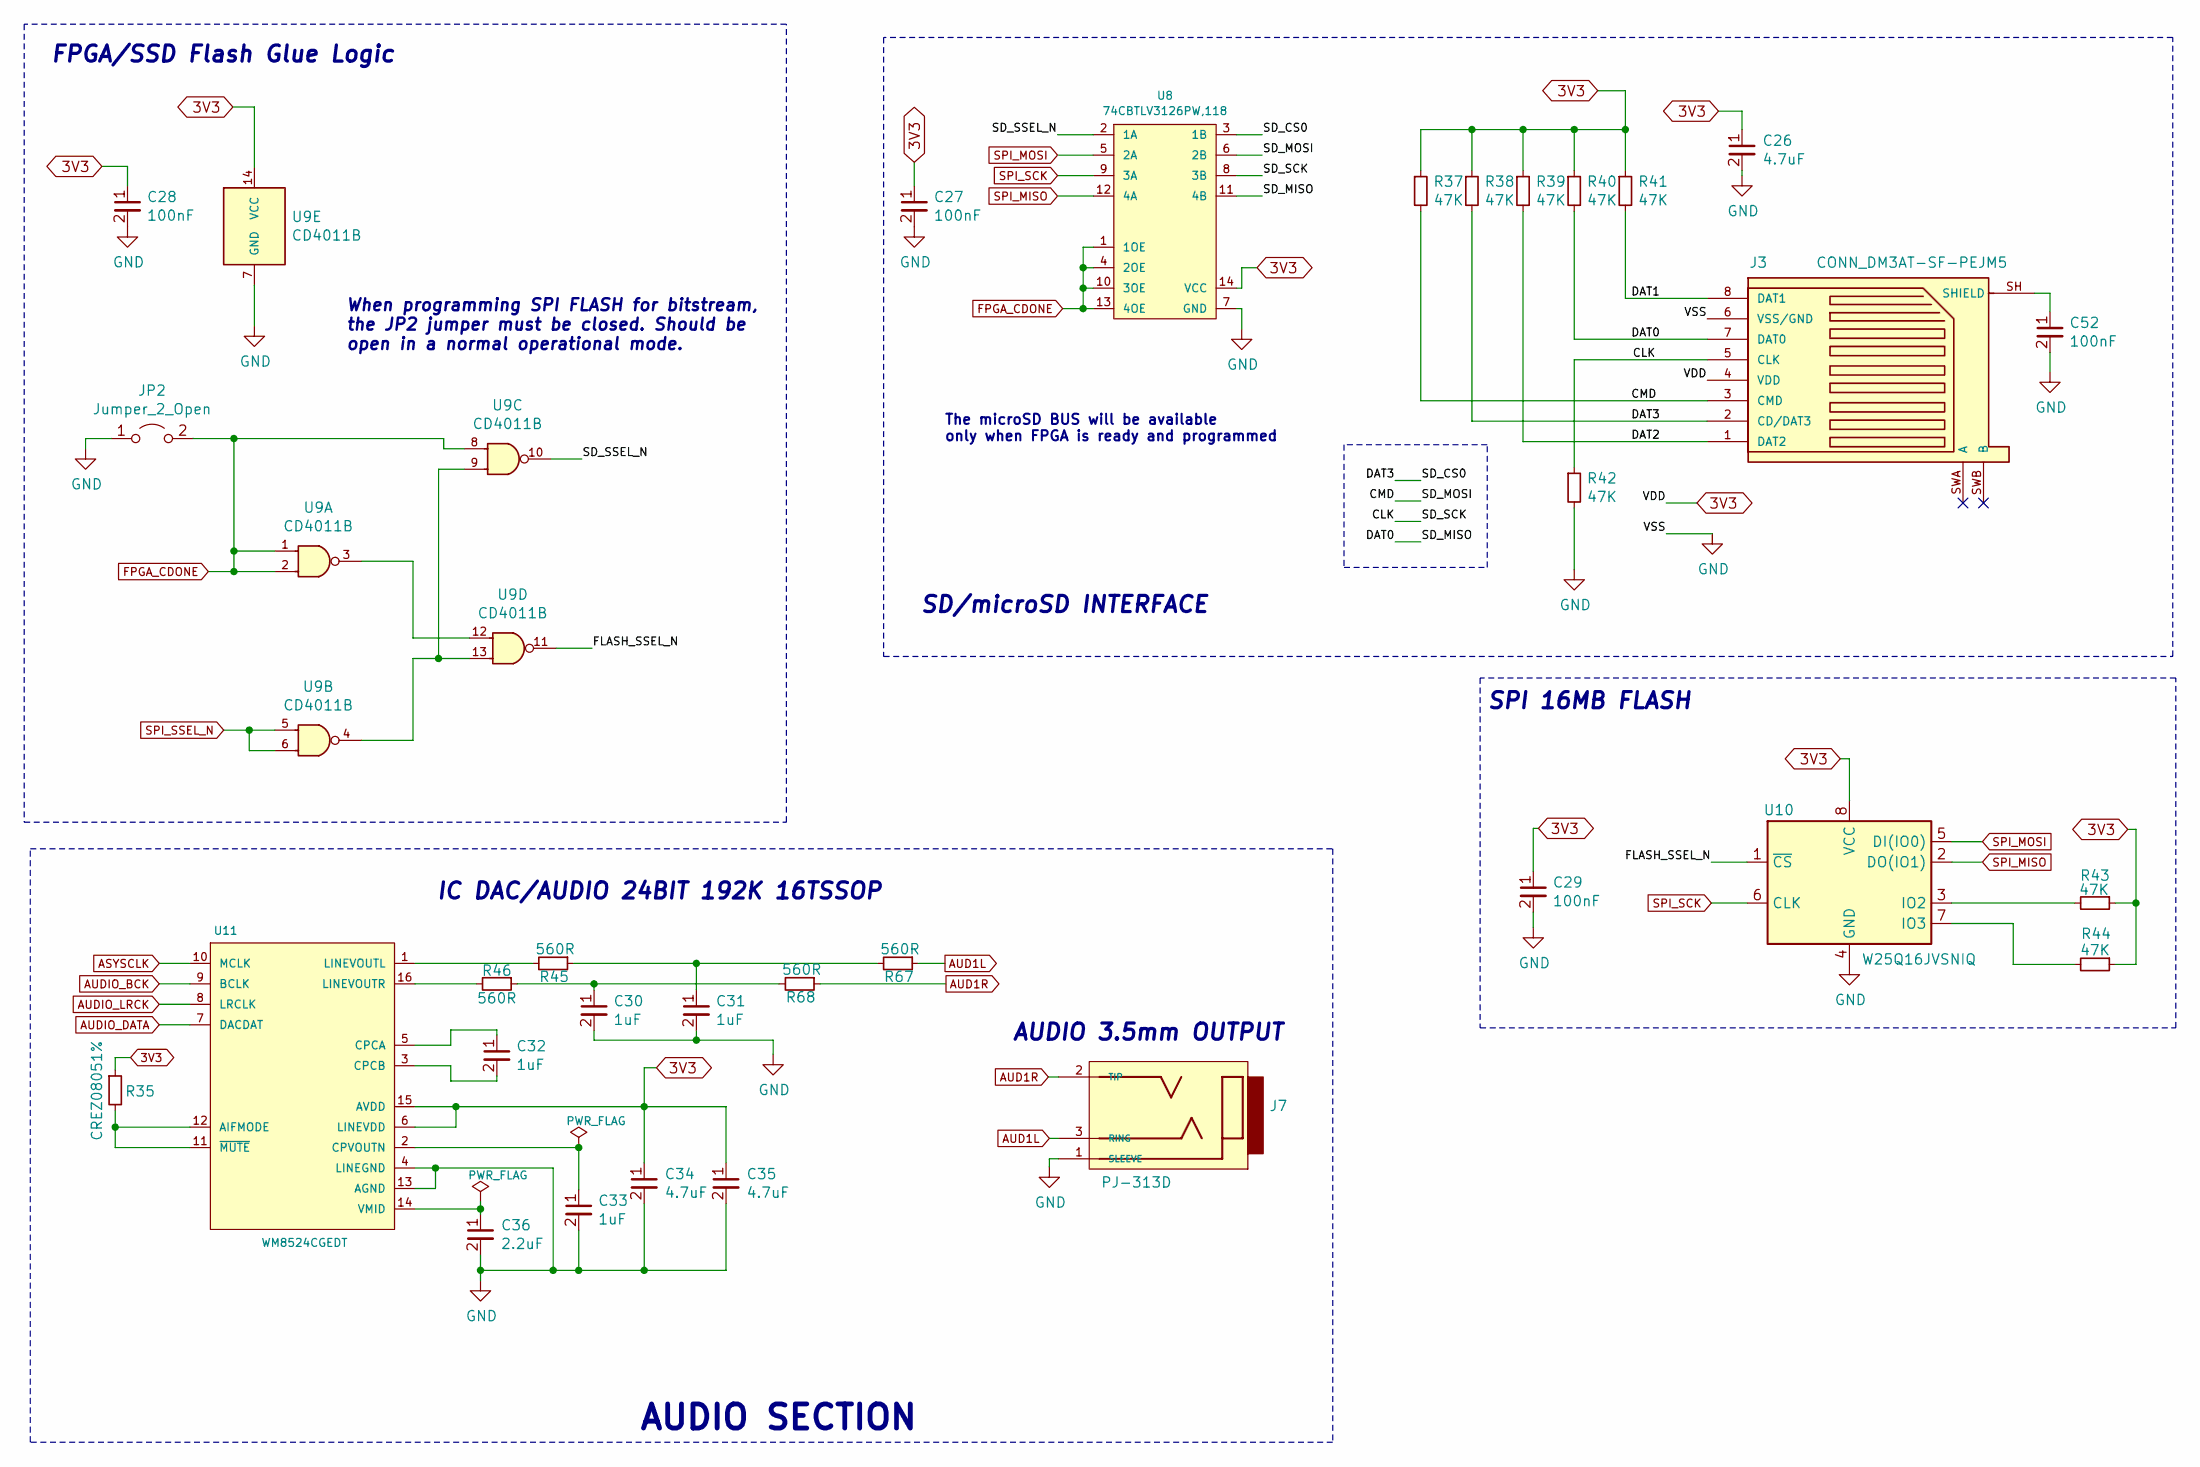
[picture p24: schematic vera-fpga-flash.sch, uSD Card, FPGA FLASH and AUDIO SECTION]

Parts:
C26, C34, C35: 4.7uF; C_0805_2012Metric_Pad1.18x1.45mm_HandSolder; LCSC C7393930
C27, C28, C29, C52: 100nF; C_0805_2012Metric_Pad1.18x1.45mm_HandSolder; LCSC C840116
C30, C31, C32, C33: 1uF; C_0805_2012Metric_Pad1.18x1.45mm_HandSolder; LCSC C2798196
C36: 2.2uF; C_0805_2012Metric_Pad1.18x1.45mm_HandSolder; LCSC C377773
J3: CONN_DM3AT-SF-PEJM5; HRS_DM3AT-SF-PEJM5; PARTREV 20200913; LCSC C114218
J7: PJ-313D; jack_3.5_pj313d-smt; LCSC C668608
JP2: Jumper_2_Open; PinHeader_1x02_P2.54mm_Vertical
R35: CREZ08051%; R_0805_2012Metric_Pad1.20x1.40mm_HandSolder; LCSC C328378
R37, R38, R39, R40, R41, R42, R43, R44: 47K; R_0805_2012Metric_Pad1.20x1.40mm_HandSolder; LCSC C17713
R45, R46, R67, R68: 560R; R_0805_2012Metric_Pad1.20x1.40mm_HandSolder; LCSC C28636
U8: 74CBTLV3126PW,118; TSSOP-14_4.4x5mm_P0.65mm; LCSC C543078
U9: CD4011B; SOIC-14_3.9x8.7mm_P1.27mm; LCSC C194334
U10: W25Q16JVSNIQ; SOIC-8_3.9x4.9mm_P1.27mm; LCSC C2456211
U11: WM8524CGEDT; TSSOP-16_4.4x5mm_P0.65mm; LCSC C146242

Connections:
3V3: C26.1, C27.1, C28.1, C29.1, C34.1, C35.1, J3.4 (VDD), R35.1, R37.1, R38.1, R39.1, R40.1, R41.1, R43.1, R44.1, U8.14 (VCC), U9.14 (VCC), U10.8 (VCC), U11.6 (LINEVDD), U11.15 (AVDD); also elsewhere on the board
/Vera FPGA flash/CLK: J3.5 (CLK), R42.1, U8.8 (3B)
/Vera FPGA flash/CMD: J3.3 (CMD), R37.2, U8.6 (2B)
/Vera FPGA flash/DAT0: J3.7 (DAT0), R40.2, U8.11 (4B)
/Vera FPGA flash/DAT1: J3.8 (DAT1), R41.2
/Vera FPGA flash/DAT2: J3.1 (DAT2), R39.2
/Vera FPGA flash/DAT3: J3.2 (CD/DAT3), R38.2, U8.3 (1B)
/Vera FPGA flash/FLASH_SSEL_N: U9.11 (4Y), U10.1 (~CS)
/Vera FPGA flash/SD_SSEL_N: U8.2 (1A), U9.10 (4Y)
ASYSCLK: U11.10 (MCLK); also elsewhere on the board
AUD1L: J7.3 (RING), R67.1; also elsewhere on the board
AUD1R: J7.2 (TIP), R68.1; also elsewhere on the board
AUDIO_BCK: U11.9 (BCLK); also elsewhere on the board
AUDIO_DATA: U11.7 (DACDAT); also elsewhere on the board
AUDIO_LRCK: U11.8 (LRCLK); also elsewhere on the board
FPGA_CDONE: JP2.2 (B), U8.1 (1OE), U8.4 (2OE), U8.10 (3OE), U8.13 (4OE), U9.1 (4A), U9.2 (4B), U9.8 (4A); also elsewhere on the board
GND: C26.2, C27.2, C28.2, C29.2, C30.2, C31.2, C33.2, C34.2, C35.2, C36.2, C52.2, J3.6 (VSS/GND), J7.1 (SLEEVE), JP2.1 (A), R42.2, U8.7 (GND), U9.7 (GND), U10.4 (GND), U11.4 (LINEGND), U11.13 (AGND); also elsewhere on the board
unnamed: C30.1, R46.1, R68.2
unnamed: C31.1, R45.1, R67.2
unnamed: C32.1, U11.5 (CPCA)
unnamed: C32.2, U11.3 (CPCB)
unnamed: C33.1, U11.2 (CPVOUTN)
unnamed: C36.1, U11.14 (VMID)
unnamed: C52.1, J3.SH (SHIELD)
unnamed: R35.2, U11.11 (~MUTE), U11.12 (AIFMODE)
unnamed: R43.2, U10.3 (IO2)
unnamed: R44.2, U10.7 (IO3)
unnamed: R45.2, U11.1 (LINEVOUTL)
unnamed: R46.2, U11.16 (LINEVOUTR)
unnamed: U9.3 (4Y), U9.12 (4A)
unnamed: U9.4 (4Y), U9.9 (4B), U9.13 (4B)
SPI_MISO: U8.12 (4A), U10.2 (DO(IO1)); also elsewhere on the board
SPI_MOSI: U8.5 (2A), U10.5 (DI(IO0)); also elsewhere on the board
SPI_SCK: U8.9 (3A), U10.6 (CLK); also elsewhere on the board
SPI_SSEL_N: U9.5 (4A), U9.6 (4B); also elsewhere on the board

Notes on the sheet:
IC DAC/AUDIO 24BIT 192K 16TSSOP
SD/microSD INTERFACE
FPGA/SSD Flash Glue Logic
SPI 16MB FLASH
The microSD BUS will be available only when FPGA is ready and programmed
When programming SPI FLASH for bitstream, the JP2 jumper must be closed. Should be open in a normal operational mode.
AUDIO 3.5mm OUTPUT
AUDIO SECTION

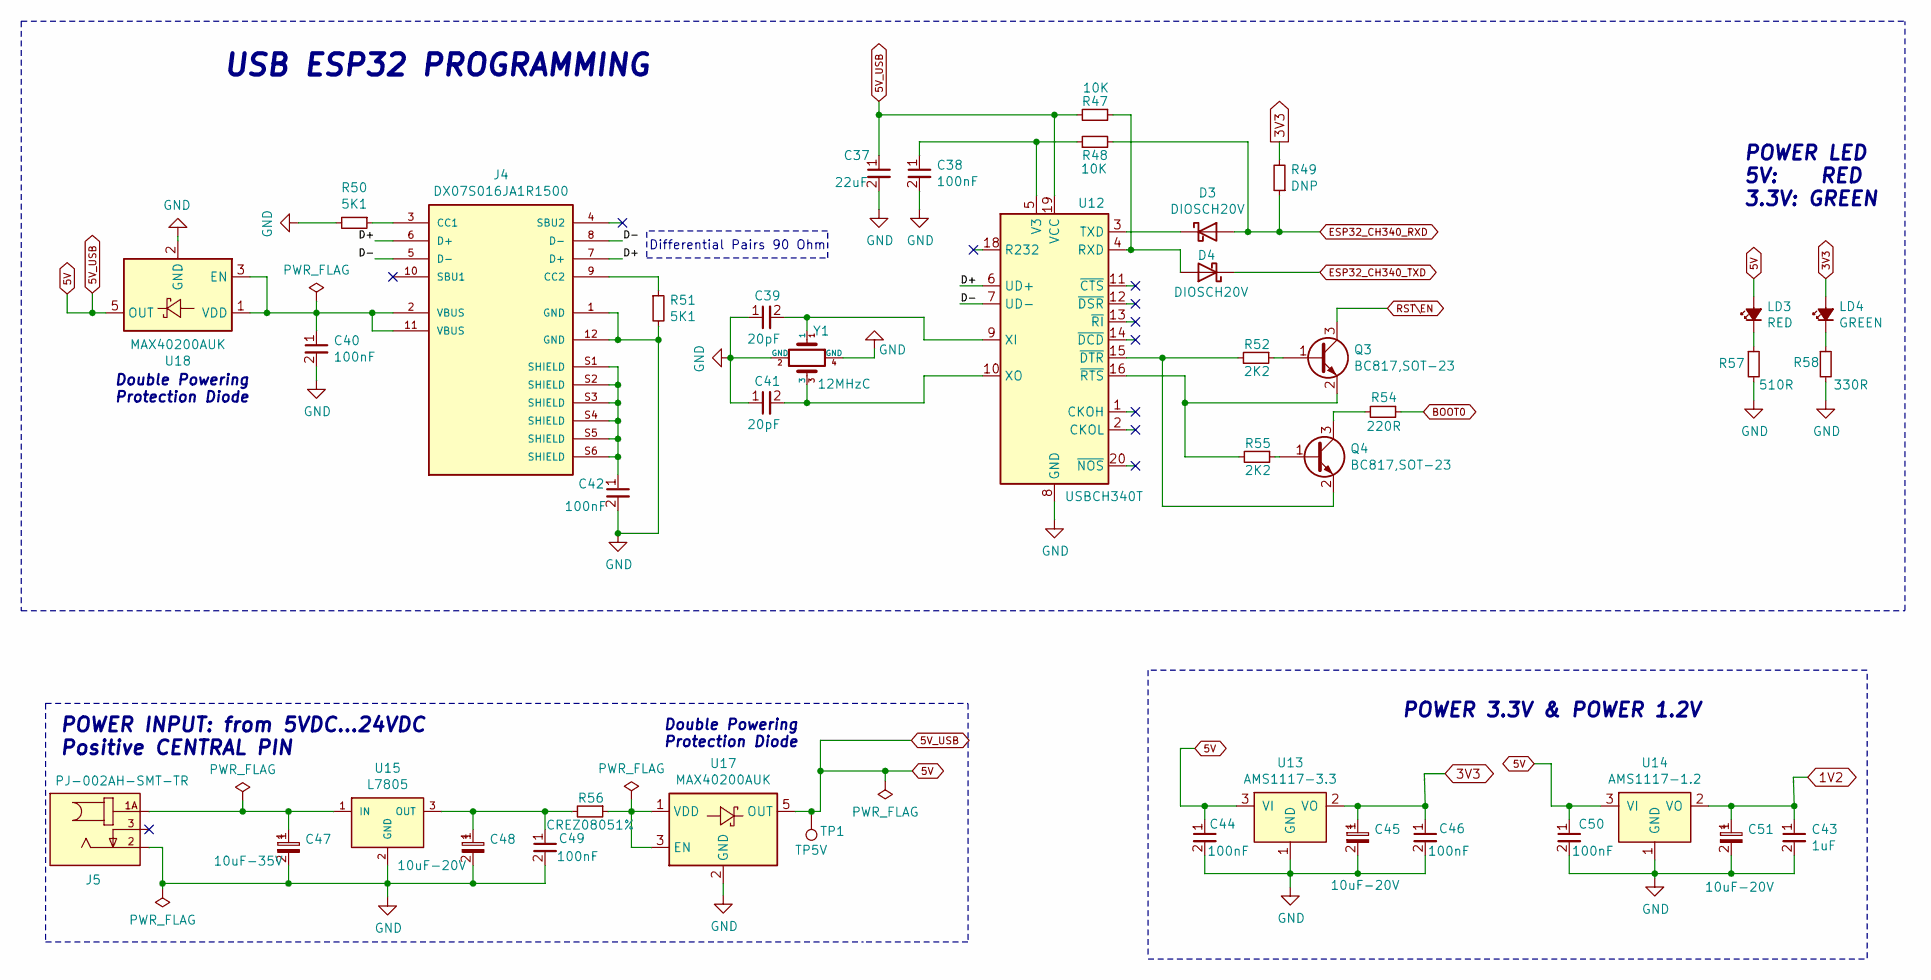
[picture p25: schematic powersupply.sch, POWERSUPPLY and USB]

Parts:
C37: 22uF; C_0805_2012Metric_Pad1.18x1.45mm_HandSolder; LCSC C86817
C38, C40, C42, C44, C46, C49, C50: 100nF; C_0805_2012Metric_Pad1.18x1.45mm_HandSolder; LCSC C840116
C39, C41: 20pF; C_0805_2012Metric_Pad1.18x1.45mm_HandSolder; LCSC C376875
C43: 1uF; C_0805_2012Metric_Pad1.18x1.45mm_HandSolder; LCSC C2798196
C45, C48, C51: 10uF-20V; CP_EIA-3528-12_Kemet-T_Pad1.50x2.35mm_HandSolder; LCSC C8017
C47: 10uF-35V; CP_EIA-3528-12_Kemet-T_Pad1.50x2.35mm_HandSolder; LCSC C8017
D3, D4: DIOSCH20V; D_SMC_Handsoldering; LCSC C236151
J4: DX07S016JA1R1500; JAE_DX07S016JA1R1500; PARTREV 1; LCSC C3197885
J5: PJ-002AH-SMT-TR; CUI_PJ-002AH-SMT-TR; LCSC C22434687
LD3: RED; LED_1206_3216Metric_Pad1.42x1.75mm_HandSolder; LCSC C965822
LD4: GREEN; LED_0805_2012Metric_Pad1.15x1.40mm_HandSolder; LCSC C84260
Q3, Q4: BC817,SOT-23; SOT-23; LCSC C20069154
R47, R48: 10K; R_0805_2012Metric_Pad1.20x1.40mm_HandSolder; LCSC C84376
R49: DNP; R_1206_3216Metric_Pad1.30x1.75mm_HandSolder
R50, R51: 5K1; R_0805_2012Metric_Pad1.20x1.40mm_HandSolder; LCSC C27834
R52, R55: 2K2; R_0805_2012Metric_Pad1.20x1.40mm_HandSolder; LCSC C17520
R54: 220R; R_0805_2012Metric_Pad1.20x1.40mm_HandSolder; LCSC C5120092
R56: CREZ08051%; R_0805_2012Metric_Pad1.20x1.40mm_HandSolder; LCSC C328378
R57: 510R; R_0805_2012Metric_Pad1.20x1.40mm_HandSolder; LCSC C114563
R58: 330R; R_0603_1608Metric_Pad0.98x0.95mm_HandSolder; LCSC C105881
TP1: TP5V; TestPoint_Pad_D2.0mm
U12: USBCH340T; SSOP-20_5.3x7.2mm_P0.65mm_Pad0.45; LCSC C8689
U13: AMS1117-3.3; SOT-223-3_TabPin2; LCSC C6186
U14: AMS1117-1.2; SOT-223-3_TabPin2; LCSC C347218
U15: L7805; TO-252-2; LCSC C110908
U17, U18: MAX40200AUK; SOT-23-5; LCSC C47118006
Y1: 12MHzC; Crystal_SMD_EuroQuartz_MT-4Pin_3.2x2.5mm; LCSC C9002

Connections:
1V2: C43.1, C51.1, U14.2 (VO); also elsewhere on the board
3V3: C45.1, C46.1, LD4.2 (A), R49.2, U13.2 (VO); also elsewhere on the board
5V: C37.1, C44.1, C50.1, LD3.2 (A), R47.2, TP1.1, U12.19 (VCC), U13.3 (VI), U14.3 (VI), U17.5 (OUT), U18.5 (OUT); also elsewhere on the board
/PowerSupply/D+: J4.6 (D+), J4.7 (D+), U12.6 (UD+)
/PowerSupply/D-: J4.5 (D-), J4.8 (D-), U12.7 (UD-)
BOOT0: R54.1; also elsewhere on the board
ESP32_CH340_RXD: D3.2 (A), R48.2, R49.1; also elsewhere on the board
ESP32_CH340_TXD: D4.1 (K); also elsewhere on the board
GND: C37.2, C38.2, C39.1, C40.2, C41.1, C42.2, C43.2, C44.2, C45.2, C46.2, C47.2, C48.2, C49.2, C50.2, C51.2, J4.1 (GND), J4.12 (GND), J5.2, R50.2, R51.2, R57.2, R58.2, U12.8 (GND), U13.1 (GND), U14.1 (GND), U15.2 (GND), U17.2 (GND), U18.2 (GND), Y1.2 (GND), Y1.4 (GND); also elsewhere on the board
unnamed: C38.1, R48.1, U12.5 (V3)
unnamed: C39.2, U12.9 (XI), Y1.1
unnamed: C40.1, J4.2 (VBUS), J4.11 (VBUS), U18.1 (VDD), U18.3 (EN)
unnamed: C41.2, U12.10 (XO), Y1.3
unnamed: C42.1, J4.S1 (SHIELD), J4.S2 (SHIELD), J4.S3 (SHIELD), J4.S4 (SHIELD), J4.S5 (SHIELD), J4.S6 (SHIELD)
unnamed: C47.1, J5.1A, J5.1B, U15.1 (IN)
unnamed: C48.1, C49.1, R56.2, U15.3 (OUT)
unnamed: D3.1 (K), U12.3 (TXD)
unnamed: D4.2 (A), R47.1, U12.4 (RXD)
unnamed: J4.3 (CC1), R50.1
unnamed: J4.9 (CC2), R51.1
unnamed: LD3.1 (K), R57.1
unnamed: LD4.1 (K), R58.1
unnamed: Q3.1 (B), R52.1
unnamed: Q3.2 (E), R55.2, U12.16 (~RTS)
unnamed: Q4.1 (B), R55.1
unnamed: Q4.2 (E), R52.2, U12.15 (~DTR)
unnamed: Q4.3 (C), R54.2
unnamed: R56.1, U17.1 (VDD), U17.3 (EN)
RST\EN: Q3.3 (C); also elsewhere on the board

Notes on the sheet:
POWER INPUT: from 5VDC...24VDC Positive CENTRAL PIN
USB ESP32 PROGRAMMING
POWER 3.3V & POWER 1.2V
POWER LED 5V: RED 3.3V: GREEN
Differential Pairs 90 Ohm
Double Powering Protection Diode

Schematic: vga-analog.sch, VGA ANALOG AND EXTERNAL VIDEO CONNECTOR

Parts:
C53, C54: 100nF; C_0805_2012Metric_Pad1.18x1.45mm_HandSolder; LCSC C840116
J1: CONN_SMD_HEADER_BOX_02x08_HX-JN2.54; IDC-Header_2x08_P2.54mm_Vertical_SMD; LCSC C41376031
J2: DS1038-15FBNSiA74-0CC; CONNFLY_DS1038-15FBNSIA74-0CC; LCSC C75754
R8, R9, R10: 4K3; R_0805_2012Metric_Pad1.20x1.40mm_HandSolder; LCSC C17667
R11, R13, R15: 2K; R_0805_2012Metric_Pad1.20x1.40mm_HandSolder; LCSC C114572
R12, R14, R16: 150R; R_0805_2012Metric_Pad1.20x1.40mm_HandSolder; LCSC C17471
R17, R19, R21: 910R; R_0805_2012Metric_Pad1.20x1.40mm_HandSolder; LCSC C2930211
R18, R20, R22: 160R; R_0805_2012Metric_Pad1.20x1.40mm_HandSolder; LCSC C2960793
R23, R25, R27: 510R; R_0805_2012Metric_Pad1.20x1.40mm_HandSolder; LCSC C114563
R24, R26, R28: 27R; R_0805_2012Metric_Pad1.20x1.40mm_HandSolder; LCSC C17594
R29, R30: 820R; R_0805_2012Metric_Pad1.20x1.40mm_HandSolder; LCSC C17837

Connections:
3V3: J1.4, J1.16; also elsewhere on the board
5V: J1.9, J1.15, J2.9; also elsewhere on the board
AUD1L: J1.11; also elsewhere on the board
AUD1R: J1.12; also elsewhere on the board
GND: C53.1, C54.1, J1.5, J1.6, J1.7, J1.8, J1.10, J2.5, J2.6, J2.7, J2.8, J2.10; also elsewhere on the board
unnamed: C53.2, J2.S2 (SHIELD__1)
unnamed: C54.2, J2.S1 (SHIELD)
unnamed: R11.1, R12.2
unnamed: R13.1, R14.2
unnamed: R15.1, R16.2
unnamed: R17.1, R18.2
unnamed: R19.1, R20.2
unnamed: R21.1, R22.2
unnamed: R23.1, R24.2
unnamed: R25.1, R26.2
unnamed: R27.1, R28.2
VGABLUE: J1.3, J2.3, R8.1, R12.1, R18.1, R24.1
VGAGREEN: J1.2, J2.2, R9.1, R14.1, R20.1, R26.1
VGAHSYNC: J1.13, J2.13, R29.1
VGARED: J1.1, J2.1, R10.1, R16.1, R22.1, R28.1
VGAVSYNC: J1.14, J2.14, R30.1
VGA_B0: R8.2; also elsewhere on the board
VGA_B1: R11.2; also elsewhere on the board
VGA_B2: R17.2; also elsewhere on the board
VGA_B3: R23.2; also elsewhere on the board
VGA_G0: R9.2; also elsewhere on the board
VGA_G1: R13.2; also elsewhere on the board
VGA_G2: R19.2; also elsewhere on the board
VGA_G3: R25.2; also elsewhere on the board
VGA_HSYNC: R29.2; also elsewhere on the board
VGA_R0: R10.2; also elsewhere on the board
VGA_R1: R15.2; also elsewhere on the board
VGA_R2: R21.2; also elsewhere on the board
VGA_R3: R27.2; also elsewhere on the board
VGA_VSYNC: R30.2; also elsewhere on the board

Notes on the sheet:
EXTERNAL DISPLAY WITH AUDIO
ANALOG VGA SIGNALS
EXTERNAL VIDEO CONNECTOR

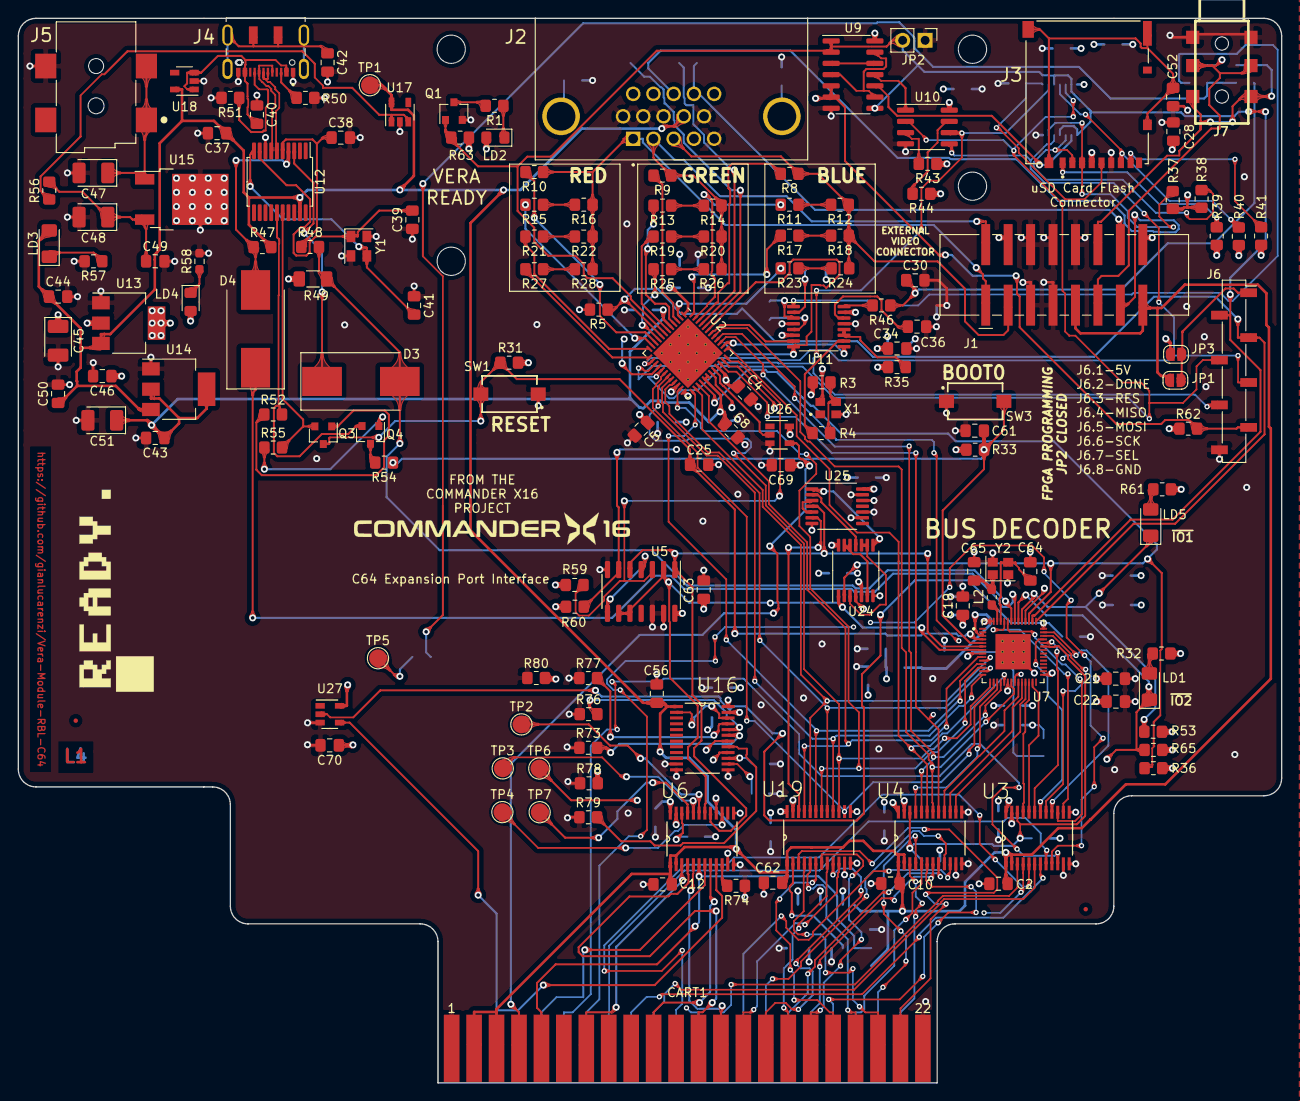
[picture p26: board VERA-MODULE-RBL.kicad_pcb from above]

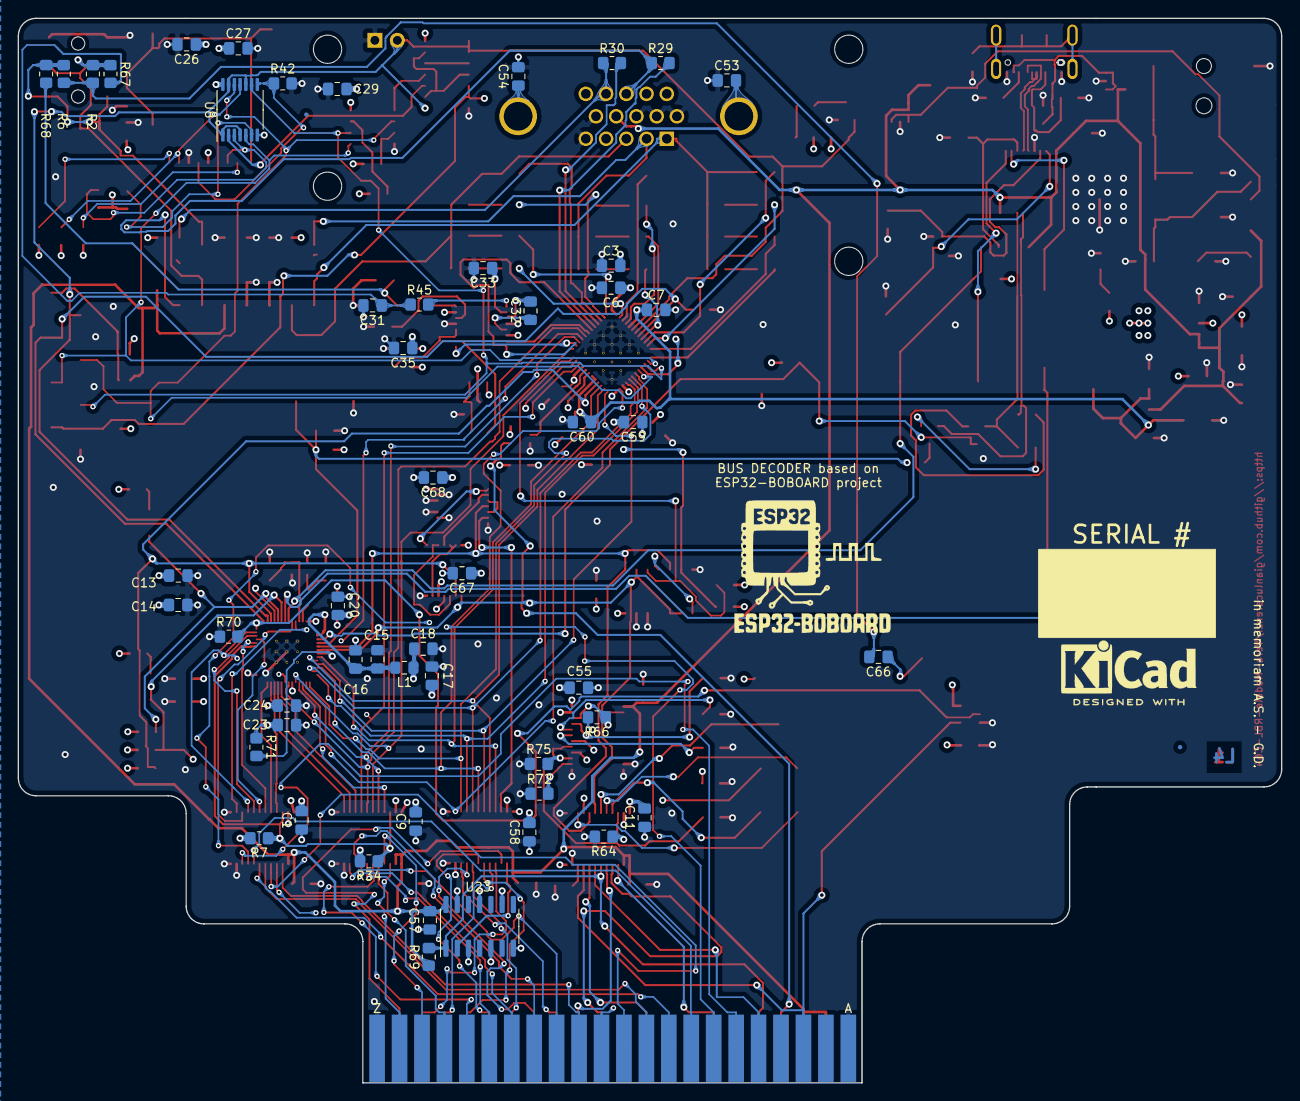
[picture p27: board VERA-MODULE-RBL.kicad_pcb from below]

Board: 4 copper layers, 143.0 x 120.5 mm, 221 parts (57 on the bottom side), 195 nets.
