gianlucarenzi/Vera-Module-RBL-C64/(commit log)

2026-10-21 Initial import: VERA Module RBL-C64
    Commodore 64 expansion-port version of the VERA Module, derived from
    VERA Module RBL-XE (ATARI). Schematic and PCB are still the ATARI ones;
    the hardware changes for the C64 are listed in PIN-MAPPING.md § 9.
    - I/O map: GeoRAM 256 KB window at $DE00 (/IO1), VERA registers at
    $DF00-$DF1F, select latch at $DFFD, GeoRAM page/block at $DFFE/$DFFF
    - firmware/MCU: ESP32-S3FN8 bus controller, cycles qualified by /IO1 and
    /IO2; bus loop on Core 0, serial log on Core 1 via a lock-free ring
    - firmware/FPGA: iCE40UP5K bus interface (C6502_Interface.vhd)
    - docs: README, PIN-MAPPING (checked against ESP32-S3 datasheet v2.2),
    firmware analysis (.tex/.pdf)
2026-10-21 docs: mark the project as WORK IN PROGRESS, not working
    Warning banner at the top of the English and Italian sections and a
    status badge: the board has not been built or tested, firmware and docs
    are verified only in simulation or on paper.
2026-10-23 firmware: $DFFD selects only the VERA, GeoRAM always active
    The VERA chip select (ESP32 DEV_SEL_N, FPGA VERA_CS) still needs /IO2,
    $DF00-$DF1F and the $DFFD latch set. The GeoRAM window ($DE00-$DEFF)
    and its page/block registers ($DFFE/$DFFF) no longer depend on the
    latch, like the original cartridge, so existing GeoRAM software works
    without touching $DFFD. Docs updated; FPGA not simulated, bitstream
    not rebuilt.
2026-10-23 docs(fpga): rewrite the build and programming guide for the C64
    The guide was still the Atari one (PBI/CCTL, RAMbo, PBI ROM, A0-A15).
    Now it describes the C64 Rev 6 design: /IO1-/IO2 qualification, VERA
    chip select with the $DFFD latch, GeoRAM always active on the AS6C4008,
    single bitstream build/flash, C64 reset sequencing, pin table from the
    PCF and ~1 MHz timing. Makefile header no longer says "no GeoRAM".
2026-10-26 hw: RBL-XE schematic adapted to the C64 expansion port
    Schematic sheets copied from VERA Module RBL-XE (2026-10-26 revision:
    U19 ~OE gating with U24/U25, ESP32 strapping with ~ABUS_OE on GPIO 47,
    open-drain IRQ U26, spare channels tied off), then the connector sheet
    adapted to the Commodore 64:
    - CART1/ECI1 (Atari) replaced by CART1 C64-EXPANSION-PORT, 2x22 edge
    fingers, 2.54 mm; /GAME, /EXROM, /ROML, /ROMH, /NMI, Dot Clock NC
    - U6: /IO1 -> ~mIO1 -> GPIO 41, /IO2 -> ~mIO2 -> GPIO 42; BA, /DMA,
    /RESET to test points TP3, TP2, TP4
    - U19 gating: U24 pin 4 = ~mIO1, pin 5 = 3V3 (were ~mEXSEL, ~mMPD)
    - /RESET open-drain through U27 SN74LVC1G07 (+ C70), like the IRQ;
    U16 drives no C64 line, i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
2026-10-26 firmware(esp32): port the RBL-XE bus loop optimizations to the C64
    - bus loop alone on Core 1 with interrupts masked and MWDT1 disabled;
    Serial and the log printer (LogTask) on Core 0, timestamps added by
    the consumer, latch events pushed in the following PHI1
    - critical path in inline assembly: bounded /IO1-/IO2 wait with one
    bnall, one GPIO.in read, IO2 decoded by a table (bus_decode.h,
    checked by a host test), DEV_SEL_N after 5 instructions; GeoRAM
    byte driven as byte << 4 with two posted stores, no LUT
    - R/W, /IO1, /IO2 on dedicated GPIO input channels 1-3
    - writes sampled BUS_WR_SAMPLE_NS (300 ns) after PHI2 rises, side
    effects applied in the rest of PHI2
    - GeoRAM moved from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
2026-10-26 docs: align pin map, requirements and firmware notes with RBL-XE
    PIN-MAPPING.md follows the RBL-XE layout: boot-time strapping
    (R71, C25 1 uF, ~ABUS_OE), 74LVC4245 sides (A = 5 V C64, B = 3.3 V),
    U6/U16/U19 channels after the C64 rework, expansion port pinout at
    2.54 mm, change list in section 9. VERA-ATARI-HW-REQUIREMENTS.md
    rewritten for the C64 from the RBL-XE document (gating, open-drain
    IRQ and RESET, strapping, 5 V without diode, bring-up from BASIC).
    Firmware README, analysis document (PDF rebuilt) and README describe
    the new bus loop.
2026-10-26 Remove leftover Atari content from the C64 project
    - VERA-ATARI-HW-REQUIREMENTS.md renamed VERA-C64-HW-REQUIREMENTS.md,
    references updated (analysis PDF rebuilt)
    - LOGO2 "ATARI READY" becomes "C64 READY" (c64_ready_8mm_REV); LOGO4
    "ATARI DUO BUS" (DUOCart bus logo) removed from schematic and netlist
    - VERA-MODULE-RBL.csv regenerated from the current netlist (it still
    listed the Atari CART1/ECI1 of October 2025)
    - stale Atari exports removed: VERA-MODULE-RBL.xml and the *.sch-bak
    backups, now ignored
    What still says Atari on purpose: provenance notes (derived from
    RBL-XE) and the PCB with its production files, still the Atari layout
    until it is updated from the netlist.
2026-10-29 hw, firmware: remap A10-A13 to GPIO 33-36 as on RBL-XE
    Same change as RBL-XE: A10-A13 now go to GPIO 33-36 (U7 pins 38-41) in
    natural order to simplify the routing. U3 side unchanged.
    - busdecoder.sch: U7-side labels swapped; netlist updated to match.
    - main.cpp: PIN_A10..PIN_A13 follow the new pins.
    - PIN-MAPPING, firmware README and analysis document (.tex + PDF).
    The .kicad_pcb is not updated yet: import the netlist and reroute.
2026-10-29 hw: take the Y2 crystal 3D model from RetroBitLab
    KiCad 5 has no 3D model for Crystal_SMD_2520-4Pin_2.5x2.0mm; the STEP model
    now lives in RetroBitLab.3dshapes.
2026-10-29 output_job.sh: pass the board to clean_virtual.sh with --pcb
    As a positional argument the .kicad_pcb was treated as one more CPL CSV to
    clean: every run rewrote the board (dropping its blank lines) and left a
    new backup copy next to it.
2026-10-29 output_job.sh: run on Debian 13 and the KiCad 5 AppImage too
    Same scripts as Vera-Module-RBL-XE. They keep working on older Debian
    (system KiCad 5, Python 3.9, cairo 1.16) and also run where KiCad 5 is
    only the AppImage:
    - generate_bom.py replaces xsltproc + bom2grouped_csv_jlcpcb.xsl, which
    was missing; plain Python 3, same output byte for byte as the XSL
    - run_generate_cpl.sh uses the system pcbnew when there is one, otherwise
    "kicad5 --python" (AppImage v2.2.0+), and reports a failure instead of
    going on with stale CPL files
    - eeplot is rebuilt when its binary misses system libraries or the local
    patches change; the build checks fig2dev too
    - eeplot-kicad5-schematics.patch: find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
2026-10-31 output_job.sh and JLCPCB scripts from RBL-XE
    BOM XML, CPL check and Gerbers generated from the sources, JLCPCB
    stock check with the Global Sourcing list, eeplot TOC patch for cairo
    1.18, fastroute tools. Order files are now named -C64 (they were still
    -XE).
2026-10-31 hw: C36, R37-R44, J7, X1 to the parts used on RBL-XE
    C36 C377773, R37-R44 C17713 (JLCPCB Basic), J7 PJ-313D C668608,
    X1 YXC OT3EL89CJI-111YLC-25M C7471623: the old ones are out of stock or
    short at JLCPCB. The J7 footprint still has to be changed on the PCB.
2026-10-31 WORKFLOW.md: design workflow from schematic to JLCPCB order
    Schematic and annotation, stock check, library update, ERC, footprints,
    netlist, PCB net classes, routing, zone fill and DRC, output_job.sh and
    the three files to send (Gerber zip, BOM, CPL). Linked from README.
2026-10-31 WORKFLOW.pdf from WORKFLOW.tex, ibom settings
    WORKFLOW.tex derives from WORKFLOW.md (flow diagram, same chapters);
    built with firmware/MCU/produce-pdf-from-tex.sh WORKFLOW. ibom.config.ini
    makes the InteractiveHtmlBom plugin write ibom/ibom.html with tracks,
    zones and nets.
2026-10-31 Remove files not needed by the build, no more CPL backups
    - config.py: not used by any script
    - ESP32-PICO datasheets (two identical copies) and RP2350 datasheet and
    schematic: the board uses the ESP32-S3FN8
    - VERA-MODULE-RBL_cpl_top/bot.csv: regenerated by output_job.sh, now
    ignored with the versioned JLCPCB BOM/CPL and KiCad leftovers
    - kicad_virtual_cleaner.py keeps the original CSV in memory instead of
    writing .backup_* files and a cleanup report at every run
2026-11-02 hw: PCB placement, PCB updated from the netlist
    Schematic: CART1 and the decoder note moved on their sheets.
    PCB: new placement, then updated from the netlist with the upstream
    changes: U7 pads 38-41 on mA10-mA13 as remapped on RBL-XE, X1 value
    OT3EL89CJI-111YLC-25M, J7 on the PJ-313D footprint with the jack mouth
    in the same place on the top edge.
2026-11-02 output_job.sh: STEP by kicad2step, VRML by FreeCAD
    STEP: kicad2step of KiCad 5 (outside the flatpak, so the KiCad 5 3D models
    are found), board recoloured to the solder mask green.
    VRML: converted from that STEP with FreeCAD on Xvfb (utilities/step2wrl.py),
    colours kept, placed like the KiCad VRML. kicad-cli stays as fallback.
2026-11-02 addressdecoder.sch removed: not part of the schematic hierarchy
    The root sheet does not use it (C66/C67 and the 74LVC138 decoder there are
    not on the board). It stays in the git history; the HW requirements note
    says how to get it back.
2026-11-04 J1 now HanXia HX JN2.54-2x8P TP H8.9 (C41376031), U7 thermal vias
    - vga-analog.sch: J1 is CONN_SMD_HEADER_BOX_02x08_HX-JN2.54 with the
    IDC-Header_2x08_P2.54mm_Vertical_SMD footprint (LCSC C41376031)
    - PCB: J1 footprint updated, with the IDC-Header-2x08_P2.54mm-VERT-SMD.STEP model
    - PCB: U7 IC_ESP32-S3FN8-QFN40P700X700X90-57N updated from the library:
    3x3 GND thermal vias (0.3/0.2 mm, 1.2 mm pitch) in the exposed pad 57
    and the IC_ESP32-S3FN8_QFN.step 3D model
    - generate_gerbers.py, sch2bomxml.py: logical_abspath() keeps the
    ~/Progetti path when the project is reached through the symlink
    - BOM and netlist regenerated
2026-11-04 generate_gerbers.py: drill files in mm
    Excellon metric decimal instead of inch, as in vera-hdmi-expansion.
2026-11-04 PCB started from the RBL-XE board: placement and routing reused
    - PCB: copy of the VERA Module RBL-XE board (pre-production) updated to
    the C64 netlist by text edits: common footprints keep the XE placement
    and routing, nets renamed as in the C64 schematic (~CCTL -> ~IO2,
    ~D1XX -> ~IO1, ~S4 -> BA, ~S5 -> ~DMA, ~REFRESH -> ~RST, ...)
    - PCB: ECI1, LOGO4 and the Atari test points removed; C64 CART1, LOGO2,
    U27, R78-R80, C70 and TP2-TP7 added (new parts staged below the board)
    - PCB: old Atari cartridge fan-out removed up to the first gates
    (U3, U4, U6, U16, U19, U26, C66) together with the net-less copper
    - PCB: title block, silkscreen labels (~IO1, ~IO2, "C64 Expansion Port
    Interfa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
2026-11-04 PCB: C64 outline and edge tongue, new parts placed
    - board outline reduced to 143.15 x 120.65 mm with the tongue for the
    C64 expansion port; CART1 moved onto it
    - U27, R78-R80, C70, TP2-TP7 placed; C66 and FID4 moved
    - teardrop zones removed (only the GND and 3V3 pours are left)
    - copper at U16-16/17/18 and U24-5 cut for the C64 netlist
    State before routing the remaining connections (CART1 fan-out, R78-R80,
    U27, test points) with fastroute.
2026-11-04 tools: incremental routing with fastroute, existing wiring kept
    - route_incremental.sh: routes only the missing connections; GND and
    POWER as planes, outer GND pours kept, no SMD fanout stage
    - split_dsn_wires.py: one DSN wire per segment; KiCad 5 puts T junctions
    on intermediate vertices of its multi-point paths, which fastroute does
    not see, so complete nets looked broken (75 false unrouted -> 52 real)
    - filter_ses.py: KiCad 5 replaces all tracks on session import, so the
    session keeps every fixed segment and via exactly once with its DSN
    width (fastroute writes some of them twice or narrowed), drops the
    load-time pad joins and keeps new wiring only on the incomplete nets;
    re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
2026-11-04 WORKFLOW.tex/.pdf: incremental routing with fastroute
    Section 7 as in WORKFLOW.md: tools/route.sh routes from scratch,
    tools/route_incremental.sh only the missing connections (split DSN
    paths, filtered session).
2026-11-04 route_incremental.sh: INNER_FALLBACK, planes as a last resort
    With INNER_FALLBACK=1, if connections are still unrouted after the first
    stage a second one starts from its session with GND and POWER routable at
    INNER_COST (default 25) times the outer layers, and is kept only if it
    leaves fewer connections unrouted. New traces on the planes are reported:
    refill and check the GND/3V3 islands in the DRC. Explicit layer costs are
    needed: without them fastroute makes the outer layers more expensive.
    On this board: 12 -> 6 unrouted, one 2.1 mm trace on POWER.
2026-11-04 PCB: routing completed, zone outlines fitted to the C64 board
    - remaining connections routed with fastroute (tools/route_incremental.sh,
    INNER_FALLBACK) and by hand: CART1 fan-out, R78-R80, U27, test points;
    KiCad ratsnest: 0 unconnected
    - the ~mIO1, ~mIO2 and ~C64_RESET stubs on U16-16/17/18 and the ~mIO2 stub
    on U24-5 removed (commit 27d9f36 said they were already cut: they were not)
    - GND/3V3 zone outlines: bottom edge from y 222.5 (XE board) to y 170.5,
    2.4 mm below the C64 edge tongue as on the other sides
    - teardrops added again, zones filled
    - images regenerated
    - tools/unrouted_nets.py: thermal spoke points tested against the fill, and
    KiCad's own ratsnest total printed as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
2026-11-04 PCB: new wiring optimized by fastroute; tools/optimize_new.sh
    - PCB: the wiring added since 27d9f36 optimized by fastroute (XE routing
    kept fixed): new tracks 2659 -> 2555 mm, 161 -> 131 vias, 90-degree
    bends on the board 43 -> 2; then corrected by hand, KiCad DRC clean,
    ratsnest 0 unconnected
    - optimize_new.sh BASE_COMMIT WORKDIR: optimizer only on the tracks and
    vias added after BASE_COMMIT (new_items.py finds them, unprotect_new.py
    unprotects them in the DSN and drops the teardrop planes)
    - split_dsn_wires.py: also splits a segment where a via or another wire
    end of the same net lies in its middle, as KiCad connects them (mR~W at
    U24-1 looked unrouted)
    - filter_ses.py: only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
2026-11-04 output_job.sh: interactive BOM generated with the other outputs
    - tools/generate_ibom.py: runs the InteractiveHtmlBom plugin without
    pcbnew's GUI (console wx app, no display needed) and loads
    ibom.config.ini as the plugin started from pcbnew does (its own command
    line ignores the ini, so the settings would have to be repeated)
    - output_job.sh: ibom/ibom.html from the saved board after the Gerbers
    - ibom/ibom.html regenerated: it was still the one of the XE board
    (2025-10-29)
    - WORKFLOW.md/.tex/.pdf, ibom.config.ini: step 6 of the production files
2026-11-04 v1.0 outputs regenerated by output_job.sh
    - production/: Gerber and drill files of the finished C64 board
    - VERA-MODULE-RBL.pdf, images/VERA-MODULE-RBL.step/.wrl regenerated
    - VERA-MODULE-RBL.csv/.xml: U12 footprint RetroBitLab:SSOP-20 ..._Pad0.45
    - ibom/ibom.html unchanged (already generated from this board)
    check_jlcpcb_stock.sh (5 boards): all parts available, 65 rows,
    50 Extended; U11 WM8524CGEDT (C146242) by Global Sourcing.
2026-11-04 tools: fastroute scripts independent of the board
    - board_info.py: finds the only .kicad_pcb of the project, its inner copper
    layers and the per-layer trace costs
    - route_incremental.sh, optimize_new.sh: board name, inner layers and costs
    from board_info.py instead of VERA-MODULE-RBL and GND/POWER, so the same
    tools/ work on vera-hdmi-expansion too; route_incremental.sh also stops
    when the DSN is missing or older than the board, and accepts an inner
    layer that KiCad already exports as a power plane
